BonisOleg/adiabatic/static/images/сайт/0-02-05-3eb4adaa0fc649120910b41186bc80454fc107874810b4671cba74e420dbb2bf_a26d8dc03b7513a2.jpg

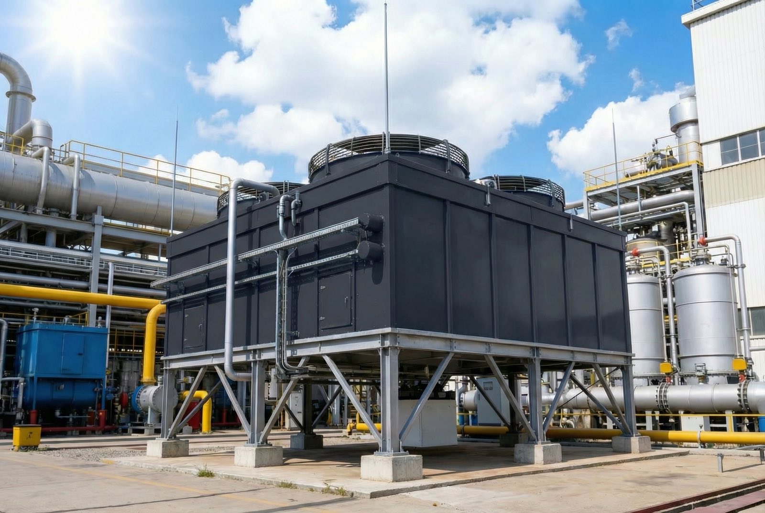
static/images/сайт/0-02-05-3eb4adaa0fc649120910b41186bc80454fc107874810b4671cba74e420dbb2bf_a26d8dc03b7513a2.jpg
