BonisOleg/adiabatic/static/images/сайт/photo_2025-12-09_13-31-13.jpg

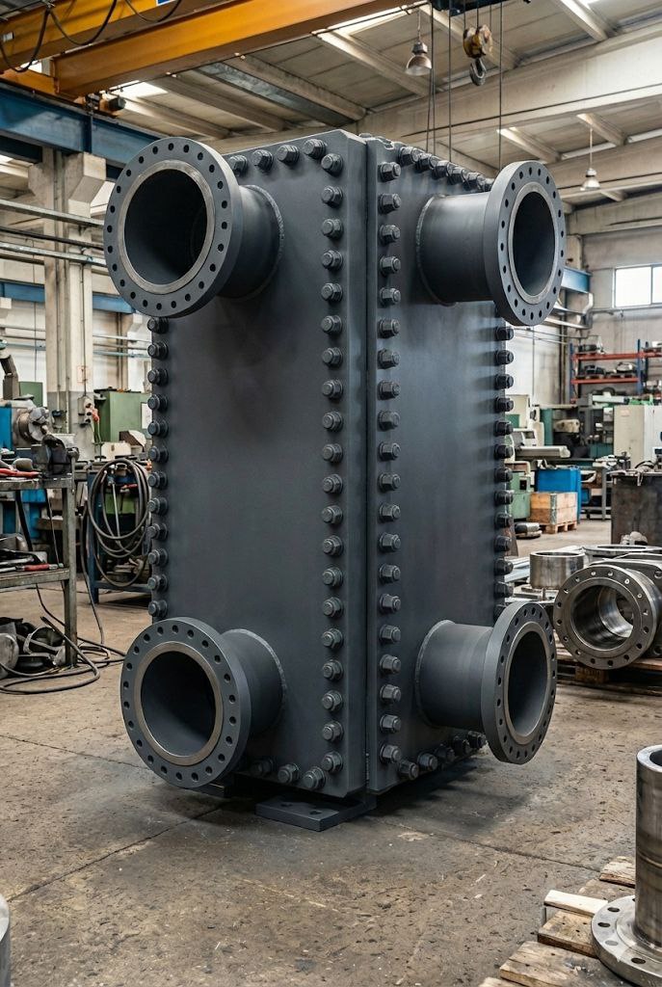
static/images/сайт/photo_2025-12-09_13-31-13.jpg
