BonisOleg/adiabatic/ОПТИМІЗАЦІЯ_ПЛАН.md

# 🚀 ПЛАН ОПТИМІЗАЦІЇ ADIABATIC ПРОЄКТУ

## 📊 ПОТОЧНА СИТУАЦІЯ

### Аналіз проєкту:
- **Загальний CSS**: 1 файл `main.css` (1992 рядки) - ВСІ стилі разом
- **Загальний JS**: 1 файл `main.js` (1030+ рядків) - ВСІ скрипти разом
- **Inline CSS**: 237 рядків у `base.html` (критичні стилі)
- **Inline JS**: Analytics та Service Worker у `base.html`
- **Зайвий код**: Неактивні додатки (payment, documents, analytics)

### Активні сторінки (14 штук):
1. **pages** (7): home, about, contacts, products, partners, blog, page_detail
2. **catalog** (4): catalog_list, category_detail, product_detail, qr_document
3. **leads** (3): lead_form, thank_you, thank_you_detail

## 🎯 ЦІЛІ ОПТИМІЗАЦІЇ

1. **Розділити CSS і JS по сторінках** - 1 файл на сторінку
2. **Видалити ВЕСЬ зайвий код** неактивних додатків
3. **Зберегти 100% функціональність** сайту
4. **Прискорити завантаження** за рахунок меншого розміру файлів
5. **Покращити кешування** браузером

## 📋 ДЕТАЛЬНИЙ ПЛАН ВИКОНАННЯ

### ЕТАП 1: ОЧИЩЕННЯ ЗАЙВОГО CSS/JS КОДУ

⚠️ **ВАЖЛИВО**: Додатки payment/, documents/, analytics/ **ЗАЛИШАЄМО** - вони потрібні для майбутнього!

#### 1.1 Очистити зайві стилі з main.css
- [ ] Видалити стилі для неактивних payment форм (якщо є)
- [ ] Видалити стилі для неактивних analytics dashboard (якщо є)
- [ ] Видалити стилі для неактивних document viewers (якщо є)
- [ ] Залишити базові стилі, які можуть знадобитися

#### 1.2 Очистити зайвий JavaScript з main.js
- [ ] Видалити неактивний JS для payment processing
- [ ] Видалити неактивний JS для analytics dashboard
- [ ] Видалити неактивний JS для document management
- [ ] Залишити базовий функціонал

#### 1.3 Оптимізувати без видалення додатків
- [ ] Перевірити які CSS/JS класи НЕ використовуються в шаблонах
- [ ] Видалити тільки неактивний код, не структуру додатків

### ЕТАП 2: СТРУКТУРА CSS ФАЙЛІВ

#### 2.1 Базові файли (спільні)
```
static/css/
├── base.css           # Критичні стилі з base.html
├── components.css     # Кнопки, форми, карти (спільні компоненти)
├── layout.css         # Header, footer, navigation, grid
└── variables.css      # CSS змінні, кольори, шрифти
```

#### 2.2 CSS файли по сторінках
```
static/css/pages/
├── home.css           # Hero з відео, продукти, партнери
├── about.css          # Про компанію, команда
├── contacts.css       # Контактна форма, карта
├── products.css       # Сфери застосування, галузі
├── partners.css       # Список партнерів
├── blog.css           # Блог, статті
└── page_detail.css    # Динамічні сторінки

static/css/catalog/
├── catalog_list.css   # Список каталогу, фільтри
├── category_detail.css # Сторінка категорії
├── product_detail.css  # Детальна сторінка продукту, 3D gallery
└── qr_document.css    # QR документи

static/css/leads/
├── lead_form.css      # Форма заявки
├── thank_you.css      # Сторінка подяки
└── thank_you_detail.css # Детальна подяка
```

### ЕТАП 3: СТРУКТУРА JS ФАЙЛІВ

#### 3.1 Базові файли (спільні)
```
static/js/
├── base.js            # Мобільне меню, smooth scroll, iOS фікси
├── components.js      # Форми, модалки, утиліти
└── analytics.js       # GA4, відстеження (винести з base.html)
```

#### 3.2 JS файли по сторінках
```
static/js/pages/
├── home.js            # Відео ротація, анімації hero
├── contacts.js        # Карта, валідація контактної форми
└── [інші сторінки мають мінімум JS]

static/js/catalog/
├── catalog_list.js    # Фільтри каталогу, пошук
├── product_detail.js  # 3D Gallery, Image Modal, техспеки
└── gallery.js         # 3D переглядач (окремо для переіспользування)

static/js/leads/
├── lead_form.js       # Валідація форм, AJAX відправка
└── form_validation.js # Спільна валідація для всіх форм
```

### ЕТАП 4: ОПТИМІЗАЦІЯ ПІДКЛЮЧЕННЯ

#### 4.1 Оновити base.html
```html
<!-- Критичні стилі inline (тільки найнеобхідніше) -->
<style>
  /* Тільки reset, основні змінні, header, footer */
</style>

<!-- Базові CSS файли (асинхронно) -->
<link rel="preload" href="/static/css/variables.css" as="style" onload="this.onload=null;this.rel='stylesheet'">
<link rel="preload" href="/static/css/layout.css" as="style" onload="this.onload=null;this.rel='stylesheet'">
<link rel="preload" href="/static/css/components.css" as="style" onload="this.onload=null;this.rel='stylesheet'">

<!-- Базовий JS -->
<script src="/static/js/base.js" defer></script>
```

#### 4.2 Блоки для сторінок
```html
{% block page_css %}{% endblock %}
{% block page_js %}{% endblock %}
```

#### 4.3 Приклад підключення для home.html
```html
{% block page_css %}
<link rel="stylesheet" href="/static/css/pages/home.css">
{% endblock %}

{% block page_js %}
<script src="/static/js/pages/home.js" defer></script>
{% endblock %}
```

### ЕТАП 5: РОЗПОДІЛ ФУНКЦІОНАЛУ

#### 5.1 Спільний функціонал (base.js)
- Мобільне меню (mobile menu toggle)
- Desktop анімоване меню
- Smooth scrolling
- iOS Safari фікси
- Back to top кнопка
- Service Worker реєстрація

#### 5.2 Компоненти (components.js)
- Валідація форм (базова)
- Модальні вікна (базові)
- Утиліти (debounce, відстеження помилок)
- Intersection Observer для анімацій

#### 5.3 Специфічний функціонал по сторінках
- **home.js**: Відео ротація, анімації hero секції
- **product_detail.js**: 3D Gallery, Image Modal, техспеки
- **lead_form.js**: AJAX форми, специфічна валідація
- **catalog_list.js**: Фільтри, пошук по каталогу

### ЕТАП 6: ОПТИМІЗАЦІЯ CSS

#### 6.1 Розподіл стилів з main.css

**variables.css** (CSS змінні):
```css
:root {
  --primary: #1B365D;
  --secondary: #C4384D;
  /* всі CSS змінні */
}
```

**layout.css** (структура):
- Header, footer
- Navigation (desktop + mobile)
- Container, section classes
- Grid systems

**components.css** (компоненти):
- Кнопки (.btn, .btn--primary, etc.)
- Картки (.card, .equipment-card)
- Форми (.form, .form-group)
- Модальні вікна

**home.css** (тільки для головної):
- Hero стилі
- Video rotation
- Products grid
- Applications section
- Downloads section

**product_detail.css** (тільки для продукту):
- 3D Gallery стилі
- Tech specs таблиці
- Advantages grid
- CTA section

### ЕТАП 7: ТЕСТУВАННЯ

#### 7.1 Функціональне тестування
- [ ] Мобільне меню працює
- [ ] Desktop анімоване меню працює
- [ ] Відео ротація на головній
- [ ] 3D Gallery на сторінці продукту
- [ ] Форми відправляються
- [ ] Всі анімації працюють
- [ ] iOS Safari оптимізації

#### 7.2 Performance тестування
- [ ] Швидкість завантаження сторінок
- [ ] Розмір CSS/JS файлів
- [ ] Кешування працює
- [ ] Lazy loading зображень

## 📊 ОЧІКУВАНІ РЕЗУЛЬТАТИ

### До оптимізації:
- **main.css**: 1992 рядки (~150KB)
- **main.js**: 1030+ рядків (~80KB)
- **Завантаження**: ВСІ стилі і скрипти на кожній сторінці

### Після оптимізації:
- **base.css**: ~300 рядків (~20KB)
- **page-specific CSS**: 100-400 рядків (~5-20KB)
- **base.js**: ~200 рядків (~15KB)
- **page-specific JS**: 50-300 рядків (~3-15KB)
- **Завантаження**: Тільки потрібні файли для конкретної сторінки

### Прискорення:
- **Головна сторінка**: ~70% менше CSS/JS
- **Сторінка продукту**: ~50% менше CSS/JS (бо 3D функціонал)
- **Форма заявки**: ~80% менше CSS/JS
- **Загальне прискорення**: 2-3x швидше

## 🔧 ТЕХНІЧНІ ДЕТАЛІ

### CSS організація:
```css
/* components.css - приклад кнопок */
.btn {
  /* базові стилі кнопок */
}

.btn--primary { /* основна кнопка */ }
.btn--secondary { /* вторинна кнопка */ }
.btn--3d { /* тільки для продуктів */ }
```

### JS модульність:
```javascript
// base.js
function initMobileMenu() { /* спільний код */ }
function initSmoothScrolling() { /* спільний код */ }

// home.js
function initVideoRotation() { /* тільки для головної */ }

// product_detail.js  
class Gallery3D { /* тільки для продуктів */ }
```

### Підключення за потребою:
- **home.html**: base.css + home.css + base.js + home.js
- **product_detail.html**: base.css + product_detail.css + base.js + gallery.js + product_detail.js
- **lead_form.html**: base.css + form.css + base.js + form_validation.js

## ✅ ЧЕКЛІСТ ВИКОНАННЯ

### Підготовка:
- [ ] Backup поточного коду
- [ ] Тестове середовище готове

### Очищення зайвого коду:
- [ ] Проаналізувати які CSS класи не використовуються
- [ ] Проаналізувати який JS код не використовується  
- [ ] Видалити неактивні стилі з main.css
- [ ] Видалити неактивний JavaScript з main.js
- [ ] ✅ ЗАЛИШИТИ всі додатки (payment/, documents/, analytics/)

### Розділення CSS:
- [ ] Створити структуру папок
- [ ] Розділити main.css на компоненти
- [ ] Створити CSS для кожної сторінки
- [ ] Перевірити всі стилі працюють

### Розділення JS:
- [ ] Створити структуру папок
- [ ] Розділити main.js на модулі
- [ ] Створити JS для кожної сторінки
- [ ] Перевірити весь функціонал працює

### Оновлення шаблонів:
- [ ] Оновити base.html
- [ ] Додати блоки page_css і page_js
- [ ] Оновити всі 14 шаблонів
- [ ] Перевірити підключення файлів

### Тестування:
- [ ] Всі сторінки відкриваються
- [ ] Всі функції працюють
- [ ] Мобільна версія працює
- [ ] iOS Safari працює
- [ ] Performance покращений

### Фінальні кроки:
- [ ] Видалити старі файли main.css, main.js
- [ ] Оновити .gitignore якщо потрібно
- [ ] Документувати зміни
- [ ] Deploy на продакшен

## 🚀 РЕЗУЛЬТАТ

Після виконання плану:
- ✅ **Сайт стане швидшим** (2-3x)
- ✅ **Код стане чистішим** (без зайвого)
- ✅ **Підтримка стане легшою** (модульність)
- ✅ **Кешування покращиться** (менші файли)
- ✅ **100% функціональність збережена**

**Головне правило**: НІЧОГО НЕ ЗЛАМАТИ! 🛡️
