BonisOleg/adiabatic/static/images/tovar6.png

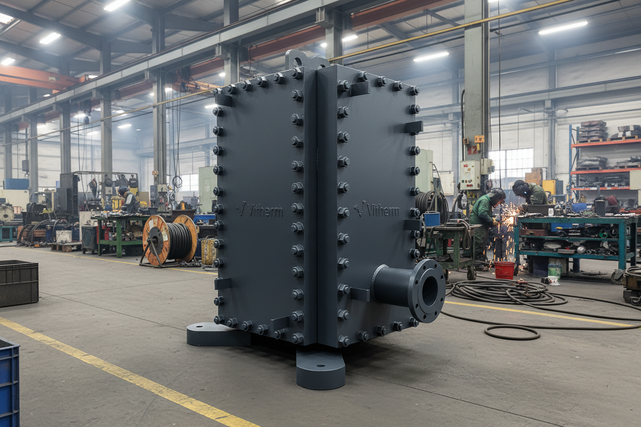
static/images/tovar6.png
