BonisOleg/adiabatic/static/images/сайт/0-02-05-1a9fca4899ccf471a3d658756550e7a283c3ff7af5b11dbfbce31b4d3bbf0c0a_f5ad5dce52cb923e.jpg

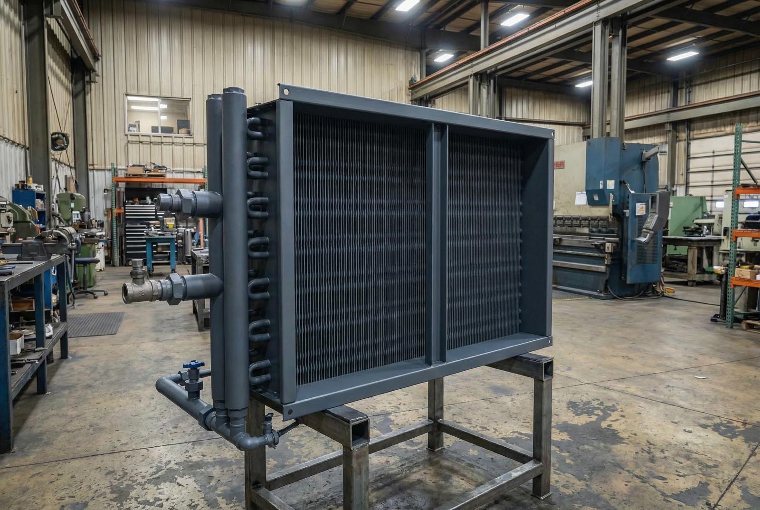
static/images/сайт/0-02-05-1a9fca4899ccf471a3d658756550e7a283c3ff7af5b11dbfbce31b4d3bbf0c0a_f5ad5dce52cb923e.jpg
