BonisOleg/adiabatic/static/images/сайт/0-02-05-5e768033f6e527f5cd78bf170995c12d8afdc9c7c348f54152d39fb6d8a779e8_63474c44207616c6.jpg

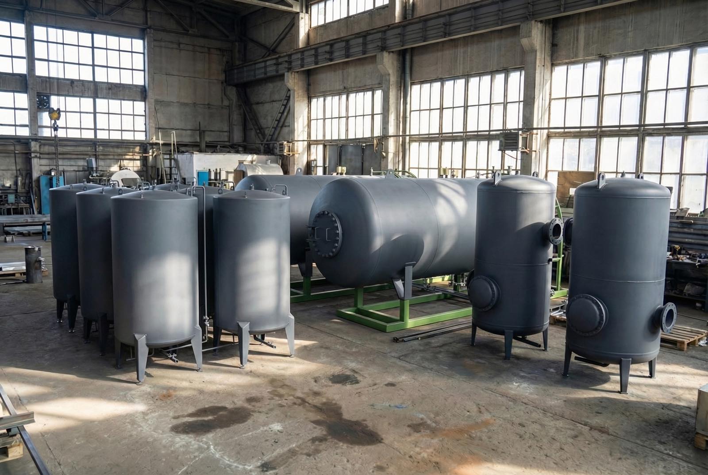
static/images/сайт/0-02-05-5e768033f6e527f5cd78bf170995c12d8afdc9c7c348f54152d39fb6d8a779e8_63474c44207616c6.jpg
