BonisOleg/adiabatic/static/images/сайт/0-02-05-919ba7b33e21d02bffa0fa3d58ddc5d80f63605416315276e9dd6206414cf1c3_1c1d455c35bce096.jpg

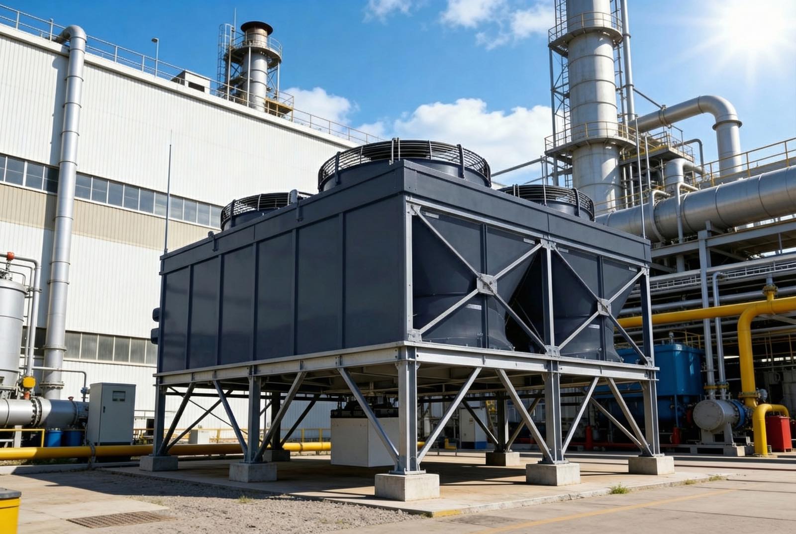
static/images/сайт/0-02-05-919ba7b33e21d02bffa0fa3d58ddc5d80f63605416315276e9dd6206414cf1c3_1c1d455c35bce096.jpg
