BonisOleg/adiabatic/static/images/сайт/0-02-05-992b67395d587ad29af840b961c614702c5de4444f6ba71ae19c8a748ea154f4_6bf83c84c83d3f53.jpg

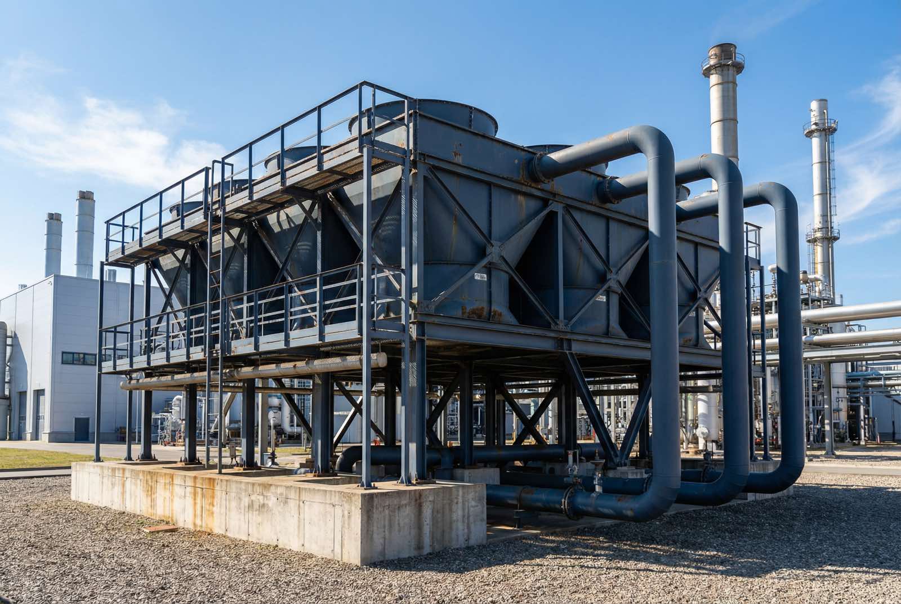
static/images/сайт/0-02-05-992b67395d587ad29af840b961c614702c5de4444f6ba71ae19c8a748ea154f4_6bf83c84c83d3f53.jpg
