BonisOleg/adiabatic/static/images/сайт/0-02-05-746751beb6804ef7eb7b141f460269889f6d4e62b52f62eda0f67aa950a41e95_8c5e32d4b4429a24.jpg

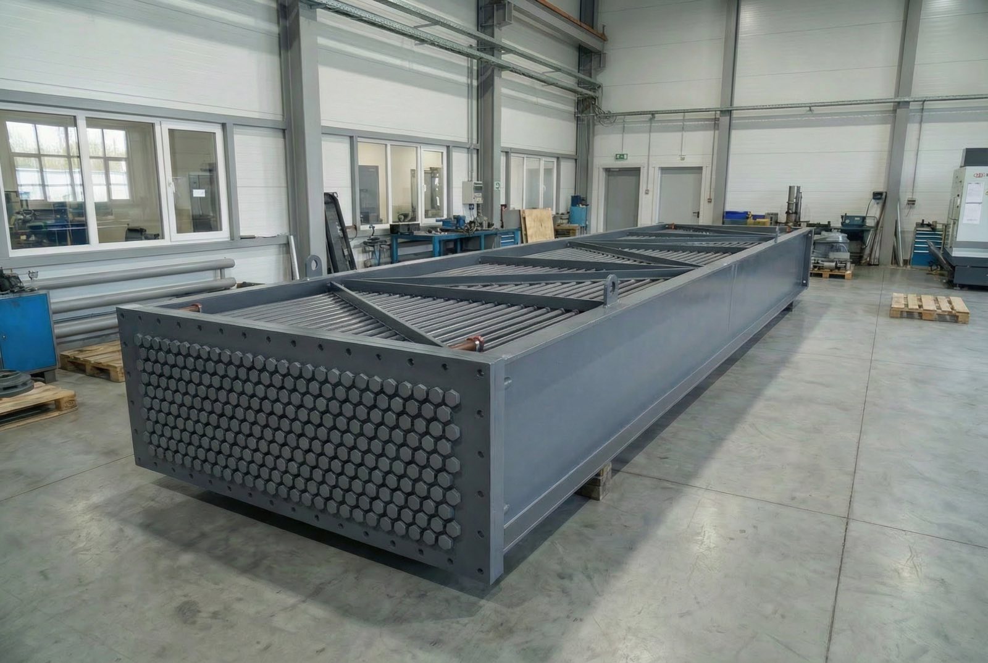
static/images/сайт/0-02-05-746751beb6804ef7eb7b141f460269889f6d4e62b52f62eda0f67aa950a41e95_8c5e32d4b4429a24.jpg
