BonisOleg/adiabatic/static/images/сайт/2314214317_50_37.png

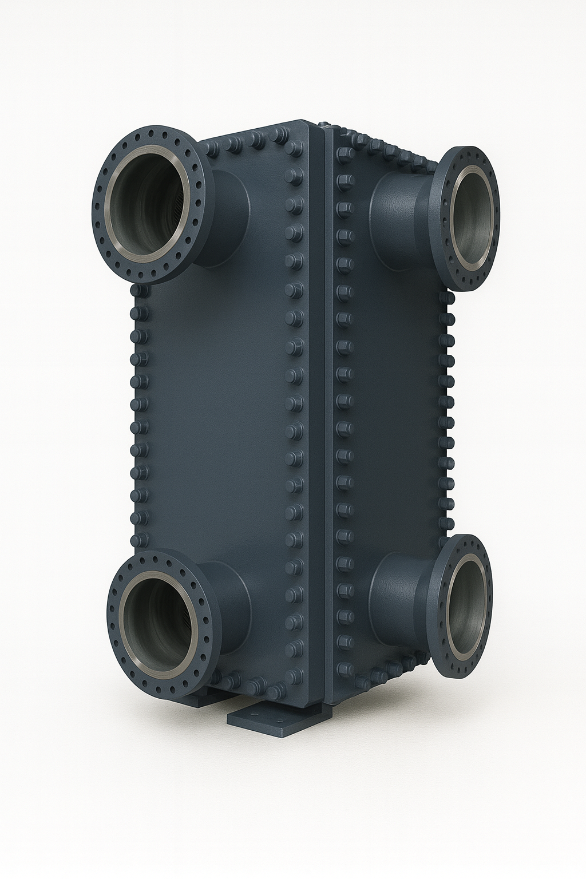
static/images/сайт/2314214317_50_37.png
