BonisOleg/adiabatic/static/images/3D/Нестандарт/8/COMPLETE RADIATOR.SLDASM

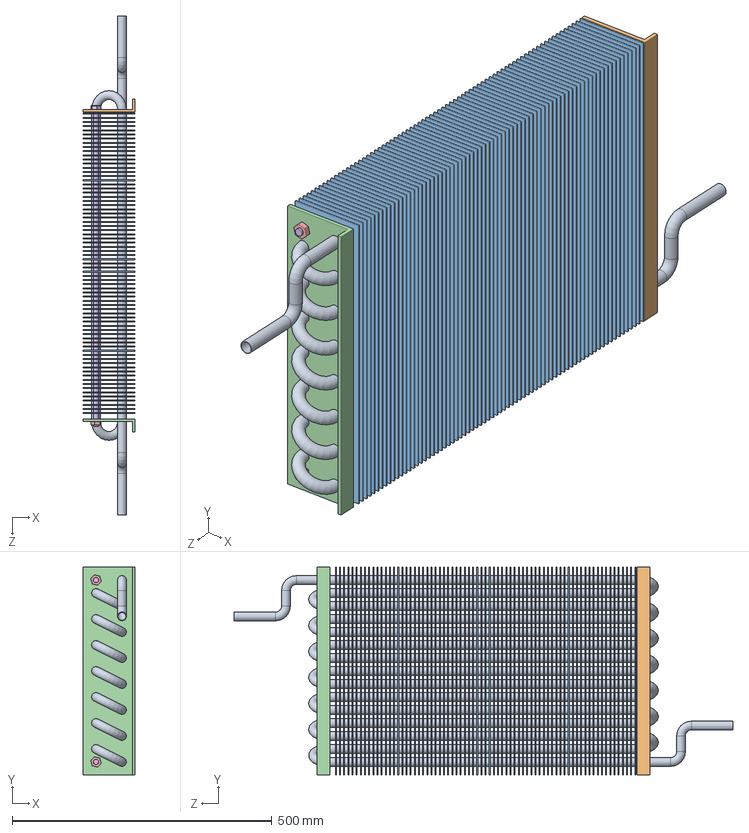
[picture p10: CAD file, 2025-09-01, last stored version]
static/images/3D/Нестандарт/8/COMPLETE RADIATOR.SLDASM
100.0 x 400.0 x 960.0 mm
pipes
side plate 2
fin x 73
side plate 1
nut x 2
strainer x 2
