BonisOleg/adiabatic/static/images/3D/Трубчатые/14/BONNET/ASME B16.5 Flange Welding Neck - Class 600 4.SLDPRT

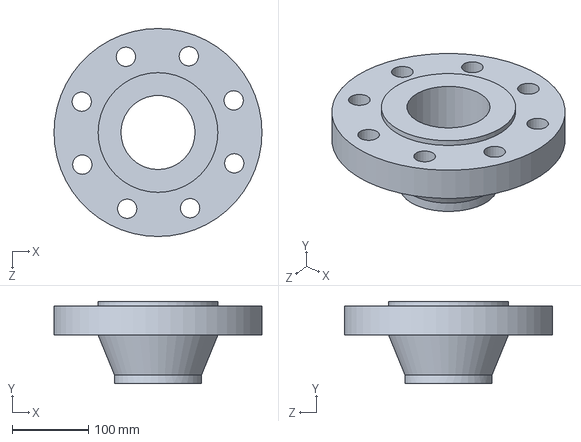
[picture p11: CAD file, 2025-09-01, last stored version]
static/images/3D/Трубчатые/14/BONNET/ASME B16.5 Flange Welding Neck - Class 600 4.SLDPRT
273.1 x 108.0 x 273.1 mm
