BonisOleg/adiabatic/static/images/3D/Трубчатые/14/SUPPORT SADDLE FIX AND MOBILE DIAM 508/SUPPORT SADDLE FIX AND MOBILE DIAM 508(2).SLDASM

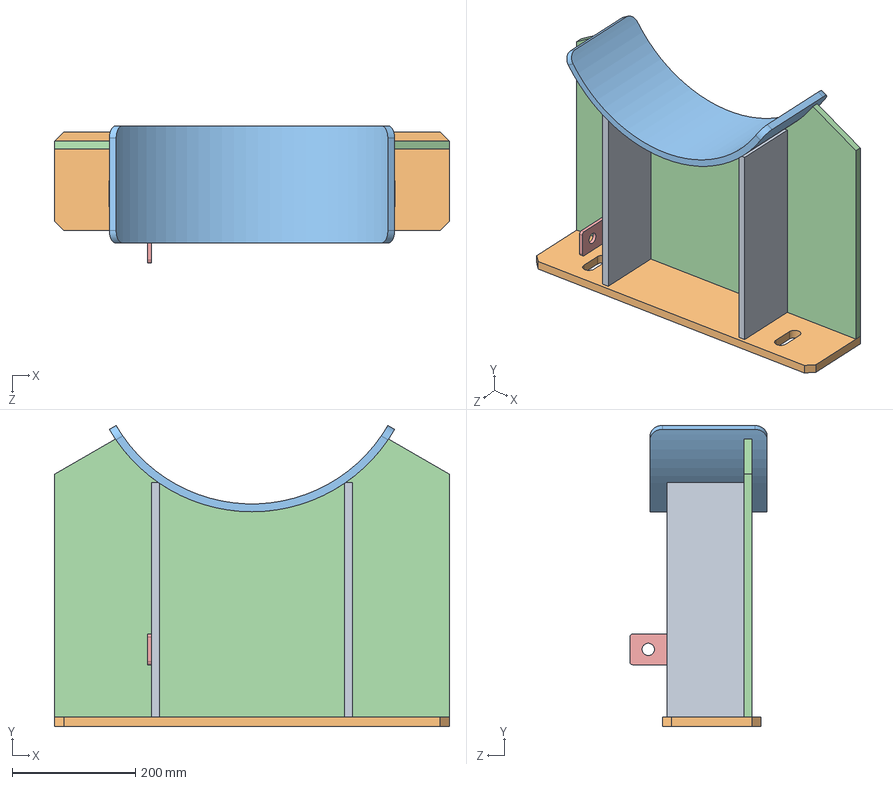
[picture p12: CAD file, 2025-09-01, last stored version]
static/images/3D/Трубчатые/14/SUPPORT SADDLE FIX AND MOBILE DIAM 508/SUPPORT SADDLE FIX AND MOBILE DIAM 508(2).SLDASM
640.0 x 487.8 x 222.7 mm
PLATE 125 X 380 X 12,7 x 2
PLATE 160 X 640 X 15,8
PLATE 190 X 544 X 12,7
PLATE 450 X 640 X 12,7
HEARTHING CONNECTOR
