BonisOleg/adiabatic/static/images/3D/Паяные/1/Assem1.SLDASM

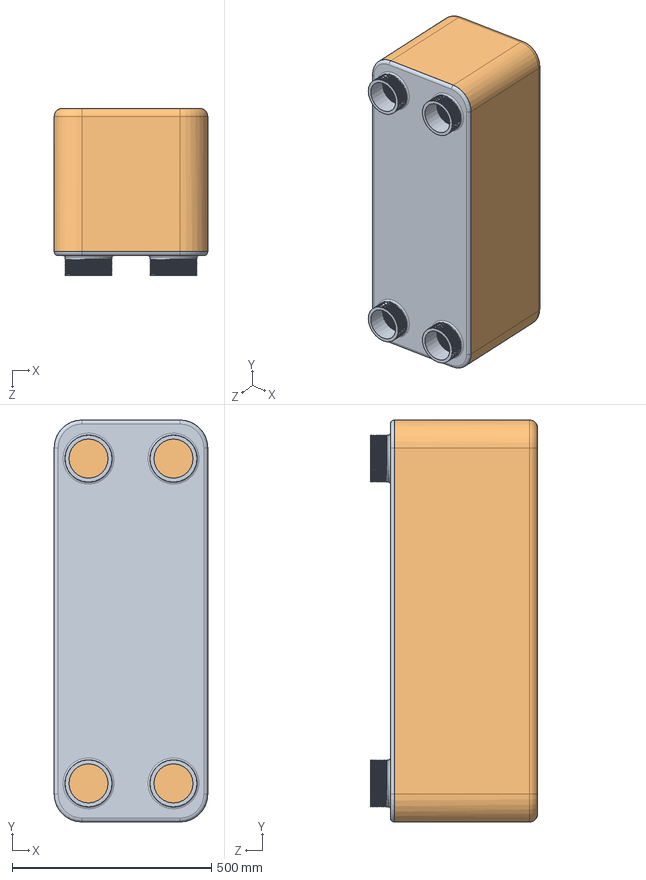
[picture p13: CAD file, 2025-09-01, last stored version]
static/images/3D/Паяные/1/Assem1.SLDASM
386.0 x 1010.0 x 420.0 mm
cover 2
cover 1
plate Bb x 66
plate A x 66
