BonisOleg/adiabatic/static/images/3D/Трубчатые/11/HEAT EXCHANGER TIPE U 1.SLDASM

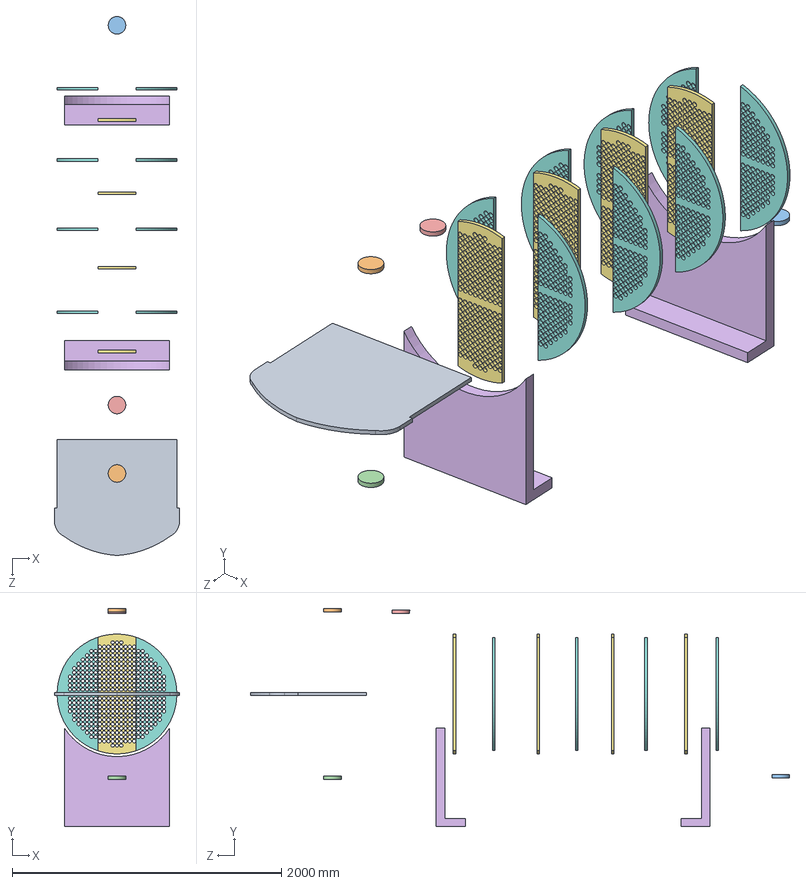
[picture p14: CAD file, 2025-09-01, last stored version]
static/images/3D/Трубчатые/11/HEAT EXCHANGER TIPE U 1.SLDASM
928.5 x 1619.2 x 4001.7 mm
FIRMAN NUR SAPUTRA_22419477_PLAT ROD
LID10
LID11
LID12
LID13
FIRMAN NUR SAPUTRA_22419477_PENYANGGA HEAT EXCHNAGER x 2
double baffle p1 x 4
double baffle t x 4
