BonisOleg/adiabatic/static/images/3D/Трубчатые/11/DOUBLE BAFFLE.SLDASM

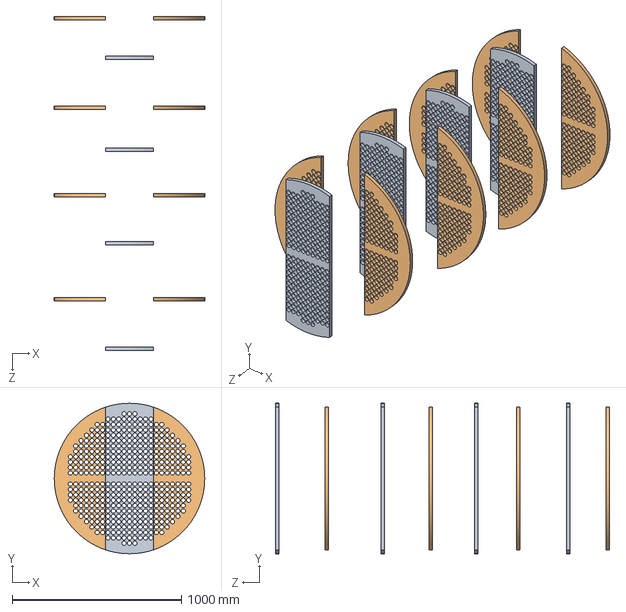
[picture p15: CAD file, 2025-09-01, last stored version]
static/images/3D/Трубчатые/11/DOUBLE BAFFLE.SLDASM
889.0 x 889.0 x 1972.2 mm
double baffle p1 x 4
double baffle t x 4
