BonisOleg/adiabatic/static/images/3D/Трубчатые/14/SHELL/SHELL.SLDASM

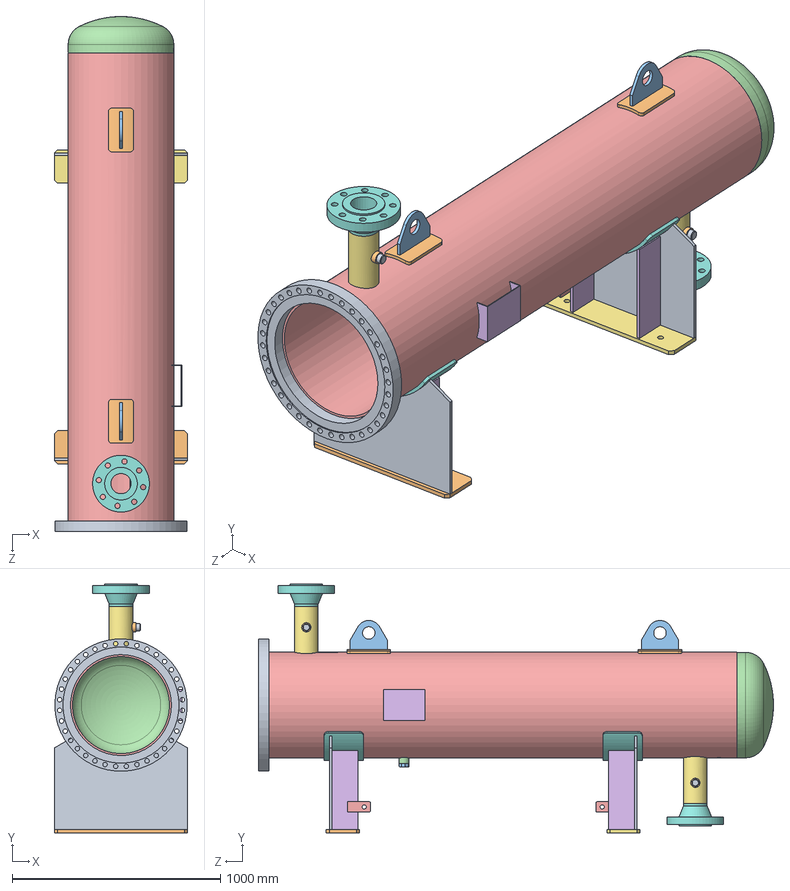
[picture p16: CAD file, 2025-09-01, last stored version]
static/images/3D/Трубчатые/14/SHELL/SHELL.SLDASM
640.0 x 1196.4 x 2475.7 mm
FLANGE DIAM 636 X 51
LIFITING LUG PLATE x 2
LIFTING LUG x 2
SHELL COVER DIAM 508 X 177
SHELL TUBE DIAM 20 Pol SCH60 x 2250
PLATE IDENTIFICATION SUPPORT
ASME B36.10M PIPE 4 POL SCH 80 X 246 x 2
ASME B16.5 Flange Welding Neck - Class 600 4 x 2
ASME B16.11 Round Head Plug 1 x 2
BONNET LIFTING LUG x 2
ASME B16.11 Coupling Threaded Class 3000 1 x 1
ASME B16.11 Coupling Threaded - Class 3000 1 x 1
HEARTHING CONNECTOR x 2
PLATE 125 X 380 X 12,7 x 4
PLATE 160 X 640 X 15,8(2)
PLATE 190 X 544 X 12,7 x 2
PLATE 450 X 640 X 12,7 x 2
PLATE 160 X 640 X 15,8
