BonisOleg/adiabatic/static/images/3D/Трубчатые/5/Assembly.SLDASM

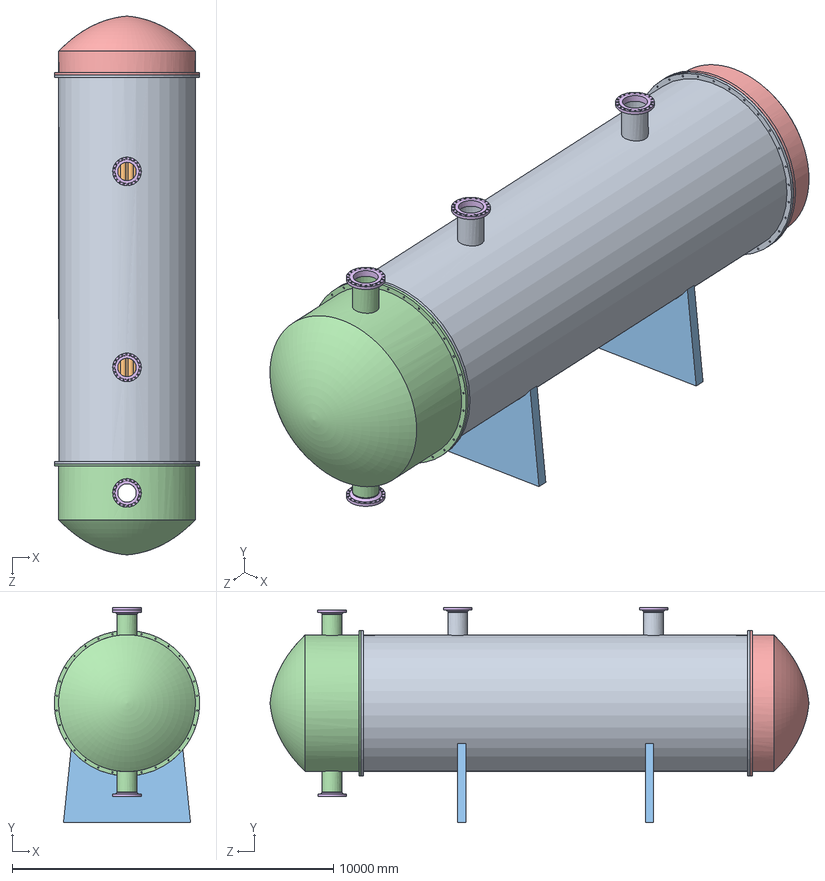
[picture p17: CAD file, 2025-09-01, last stored version]
static/images/3D/Трубчатые/5/Assembly.SLDASM
4524.0 x 6693.0 x 16774.8 mm
berk_gövdekesik
berk_ayna
berk_taşıyıcı x 2
berk_bombekesik
berk_bombe
FLANGE x 4
