BonisOleg/adiabatic/static/images/3D/Трубчатые/14/BONNET/ASME B36.10M PIPE 4 POL SCH 80 X 246.SLDPRT

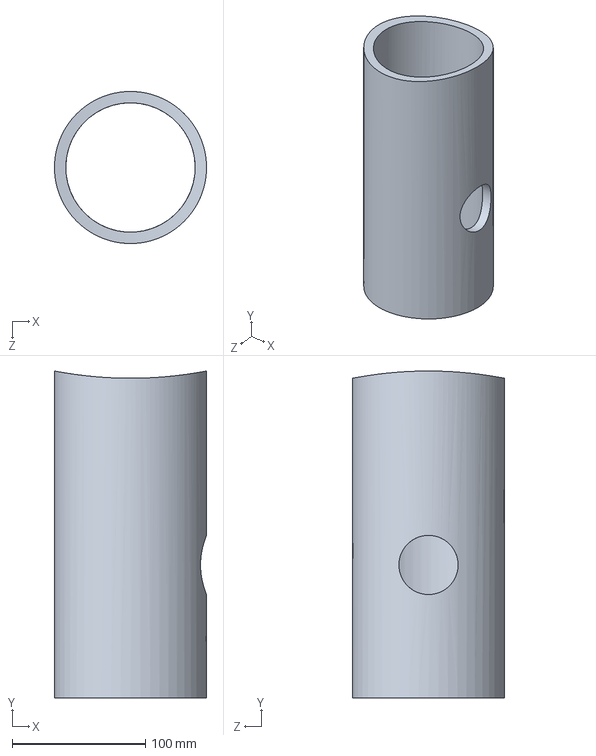
[picture p18: CAD file, 2025-09-01, last stored version]
static/images/3D/Трубчатые/14/BONNET/ASME B36.10M PIPE 4 POL SCH 80 X 246.SLDPRT
114.3 x 245.8 x 114.3 mm
