BonisOleg/adiabatic/static/images/3D/Трубчатые/14/BONNET/BONNET.SLDASM

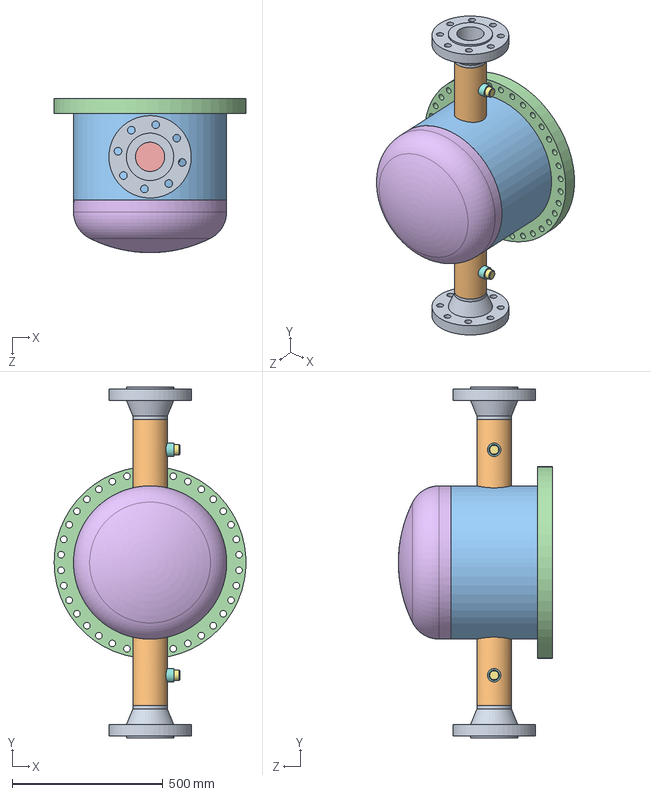
[picture p19: CAD file, 2025-09-01, last stored version]
static/images/3D/Трубчатые/14/BONNET/BONNET.SLDASM
635.4 x 1163.3 x 511.7 mm
ASME B16.5 Flange Welding Neck - Class 600 4 x 2
ASME B36.10M PIPE 4 POL SCH 80 X 246 x 2
BONNET CYLINDER Ø20 SCH 60 x 286
FLANGE DIAM 636 X 51
PASS PARTITION
SHELL COVER DIAM 508 X 177
ASME B16.11 Round Head Plug 1 x 2
BONNET LIFTING LUG x 2
