BonisOleg/adiabatic/static/images/3D/Трубчатые/14/SHELL/ASME B16.11 Round Head Plug 1.SLDPRT

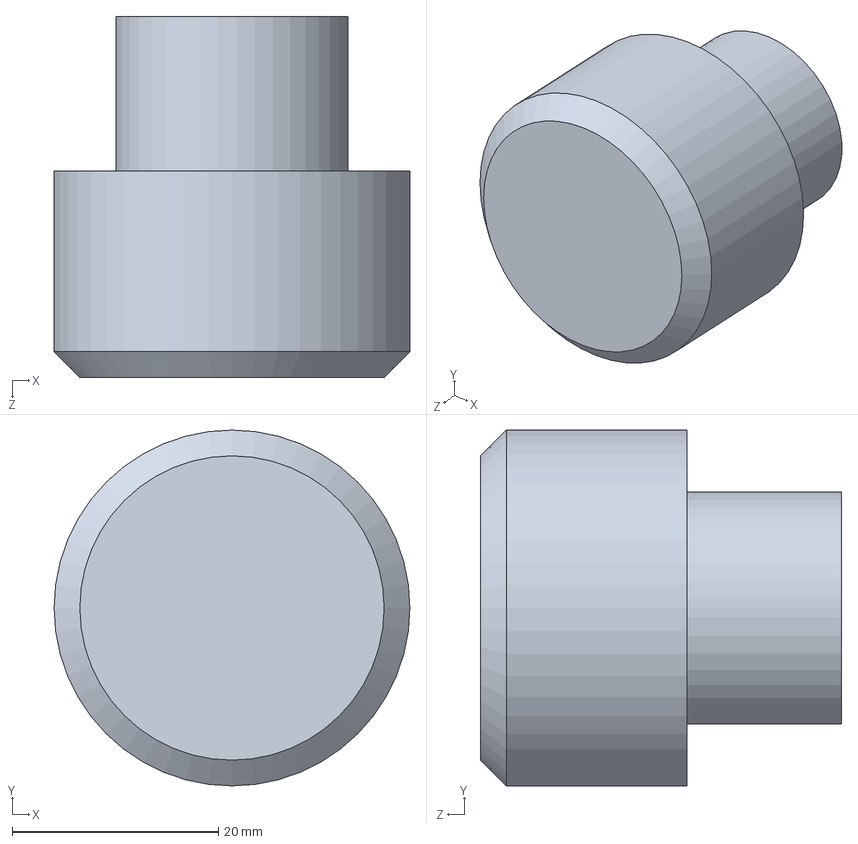
[picture p20: CAD file, 2025-09-01, last stored version]
static/images/3D/Трубчатые/14/SHELL/ASME B16.11 Round Head Plug 1.SLDPRT
34.5 x 34.5 x 35.0 mm
