BonisOleg/adiabatic/static/images/3D/Трубчатые/14/STATIONARY TUBESHEET/Assem1.SLDASM

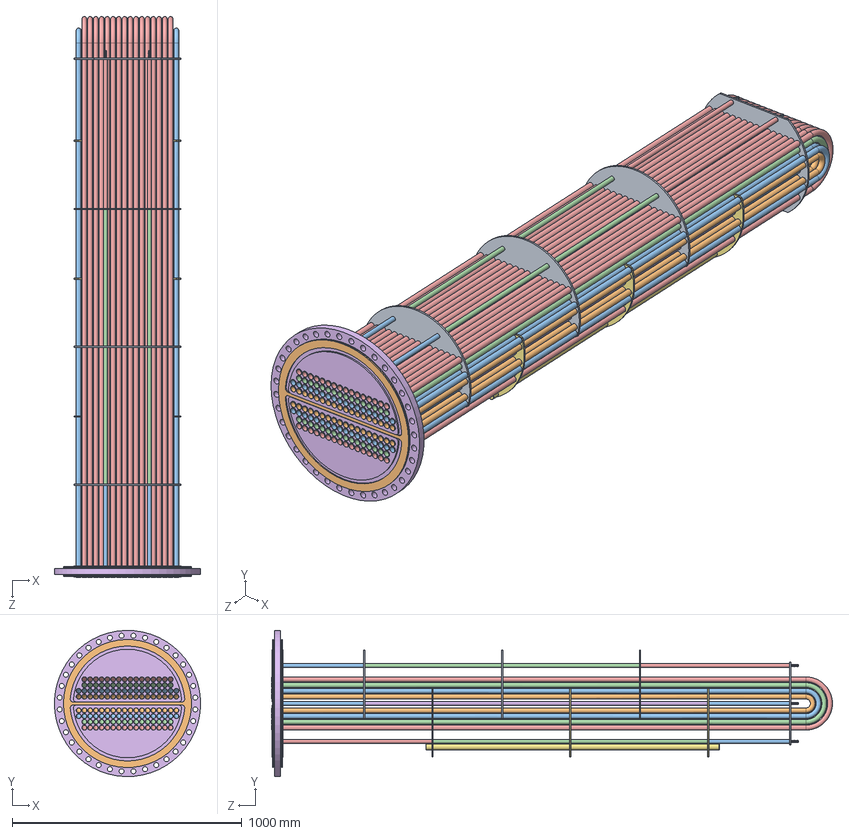
[picture p21: CAD file, 2025-09-01, last stored version]
static/images/3D/Трубчатые/14/STATIONARY TUBESHEET/Assem1.SLDASM
636.0 x 635.7 x 2440.6 mm
BAFFLE
BONNET GASKET
SPACER TUBE DIAM. 3l8 SCH 80 x 350 x 8
SPACER TUBE DIAM. 3l8 SCH 80 x 600 x 8
SPACER TUBE DIAM. 3l8 SCH 80 x 653 x 4
SPACER TUBE DIAM. 3l8 SCH 80 x 297 x 10
TIE ROD DIAM 25 X 1276 x 2
TIE ROD THREAD 3 8 X 2280 x 6
TRANSVERSE BAFFLE SUPERIOR x 3
TUBE DIAM 0.5 SCH 80 X 4766 x 18
TUBE DIAM. 0.5 SCH 80 X 4844 x 18
TUBE DIAM. 0.5 SCH 80 X 4923 x 16
TUBE DIAM. 0.5 SCH 80 X 5000 x 16
TUBESHEET
TRANSVERSE BAFFLE INFERIOR x 3
SHELL GASKET
