BonisOleg/adiabatic/static/images/3D/Трубчатые/14/SHELL/ASME B16.11 Coupling Threaded  Class 3000 1 x 1.SLDPRT

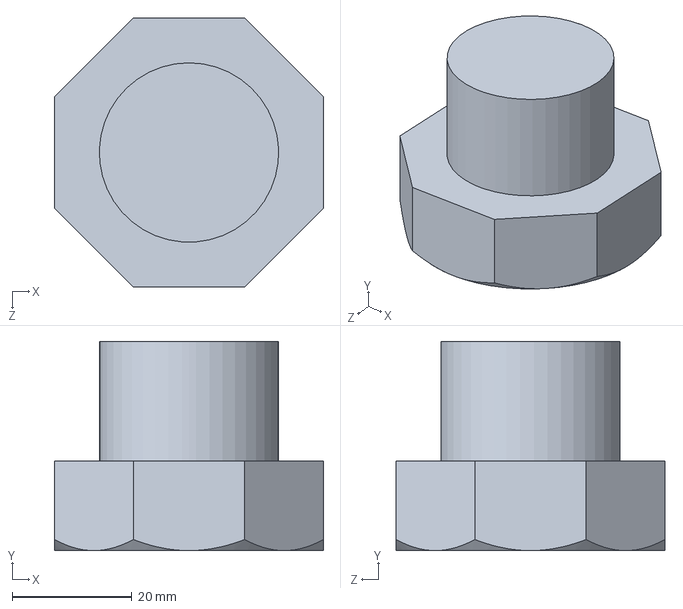
[picture p22: CAD file, 2025-09-01, last stored version]
static/images/3D/Трубчатые/14/SHELL/ASME B16.11 Coupling Threaded Class 3000 1 x 1.SLDPRT
45.0 x 35.0 x 45.0 mm
