BonisOleg/adiabatic/static/images/3D/Нестандарт/4/finned tube he/finned tube he assy.SLDASM

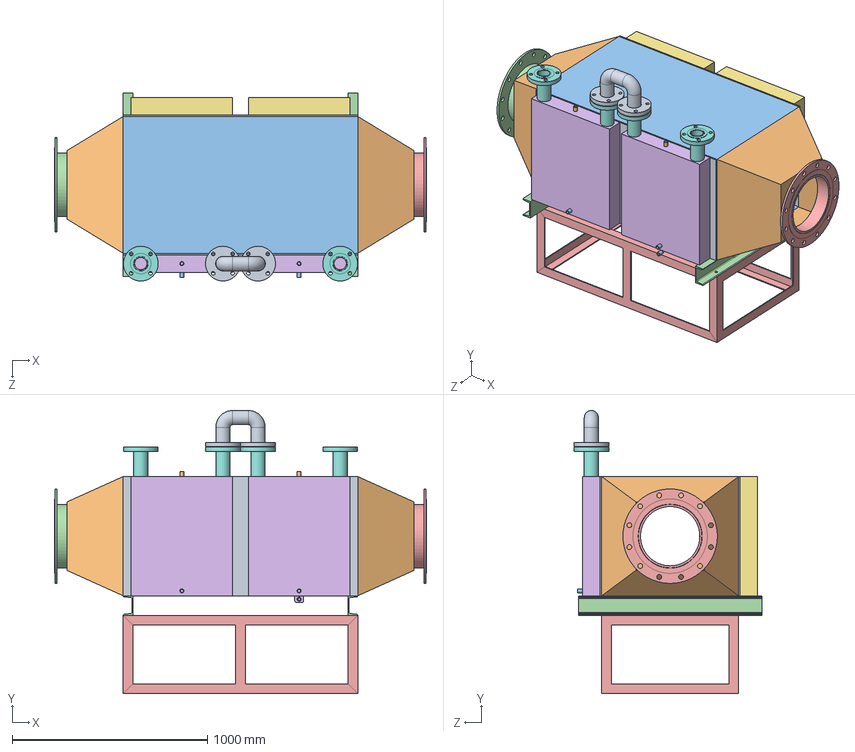
[picture p23: CAD file, 2025-09-01, last stored version]
static/images/3D/Нестандарт/4/finned tube he/finned tube he assy.SLDASM
1903.0 x 1448.0 x 962.0 mm
tube holding plate x 2
air shell x 2
air inlet flange
air outlet flange
rh waterbox x 2
lh water box x 2
65 nb class 150 x 4
loop flange
air vent 15bsp x 2
drain 15bsp x 2
50x100 channel
50x50 angle
condensate outlet
