BonisOleg/adiabatic/static/images/3D/Трубчатые/3/Main Rod End .5in thrd.SLDPRT

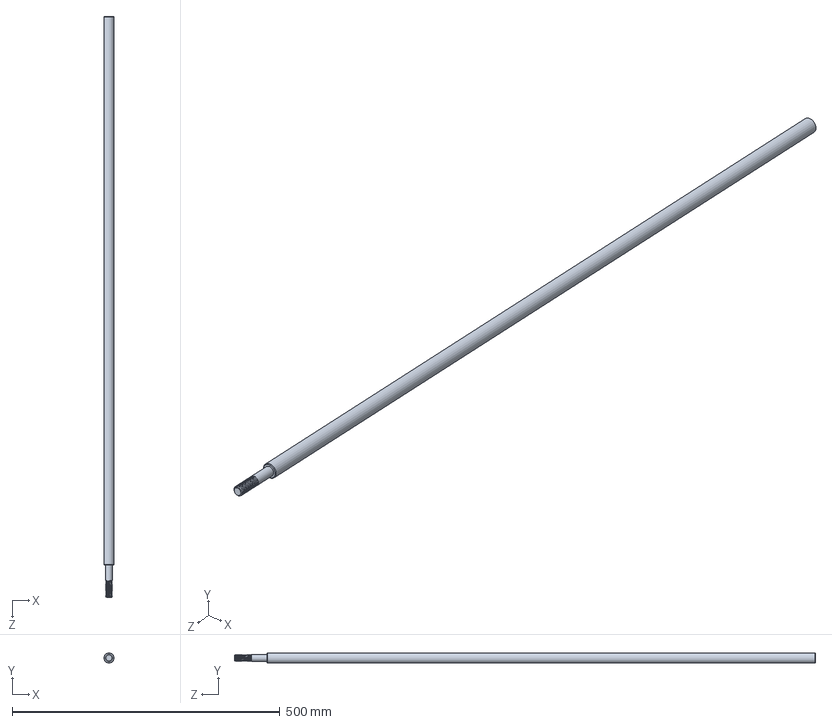
[picture p24: CAD file, 2025-09-01, last stored version]
static/images/3D/Трубчатые/3/Main Rod End .5in thrd.SLDPRT
19.1 x 19.1 x 1085.8 mm
