BonisOleg/adiabatic/static/images/3D/Трубчатые/3/Rod Plate Assembly.SLDASM

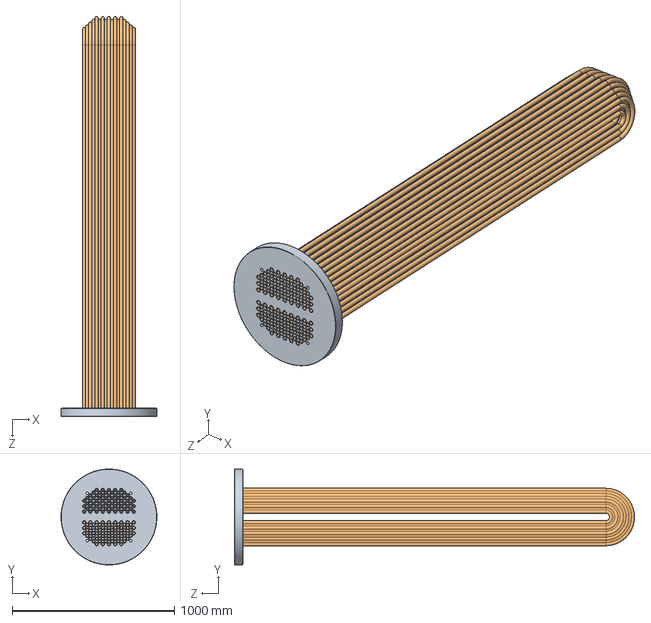
[picture p25: CAD file, 2025-09-01, last stored version]
static/images/3D/Трубчатые/3/Rod Plate Assembly.SLDASM
590.3 x 590.4 x 2462.6 mm
Plate Rod
