BonisOleg/adiabatic/static/images/3D/Трубчатые/15/Permutador e andaimes G.C/Montagem permutador inferiorg.c..SLDASM

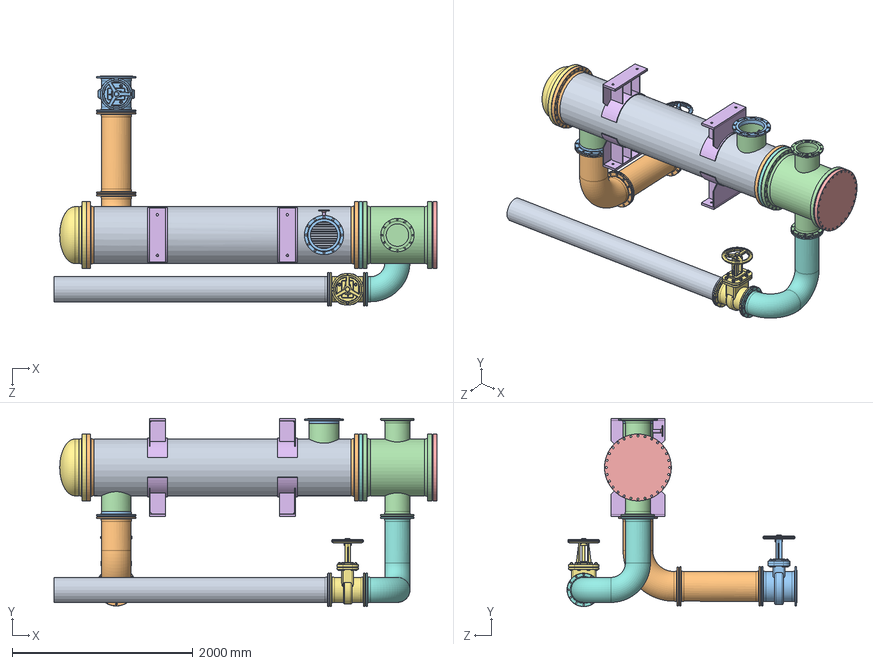
[picture p26: CAD file, 2025-09-01, last stored version]
static/images/3D/Трубчатые/15/Permutador e andaimes G.C/Montagem permutador inferiorg.c..SLDASM
4241.3 x 2084.0 x 2546.3 mm
Casco
Flange casco x 2
Flange tubo casco x 2
tubo casco x 2
Flange dreno x 2
tubo dreno x 2
Boleadog.c.
Espelho fixog.c.
Tubosg.c.
Espelho flutuanteg.c.
Chicanasg.c. x 12
Caretelg.c.
Tampa do carretelg.c.
Suporteg.c. x 4
Gate valve DN 100 PN 1,6 MPa (MZTA)g.c.
Saida carretel inferiorg.c.
tub inferior produtog.c.
saida casco inferiorg.c.
Gate valve DN 100 PN 1,6 MPa (MZTA) maiorg.c.
