BonisOleg/adiabatic/static/images/3D/Нестандарт/10/Heat Exchanger.stp

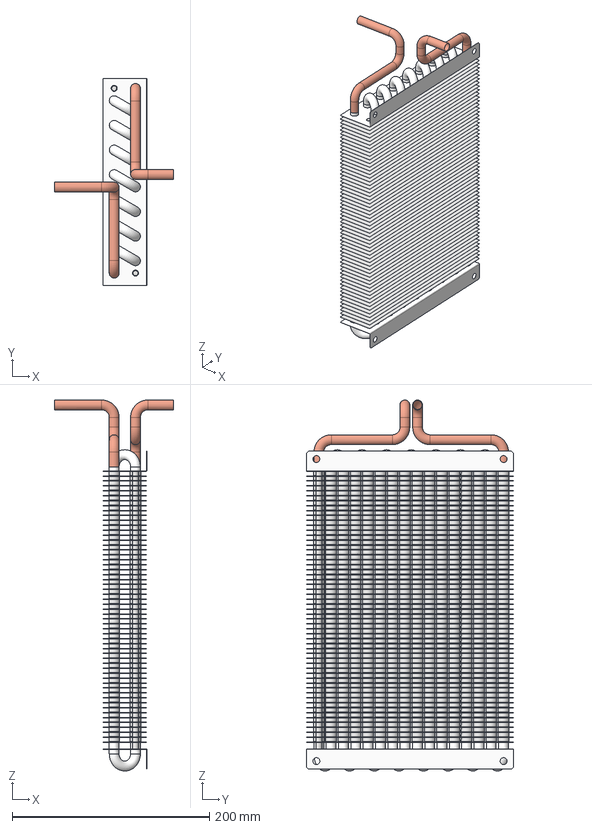
[picture p27: CAD file, 2025-09-01, last stored version]
static/images/3D/Нестандарт/10/Heat Exchanger.stp
121.0 x 210.0 x 376.4 mm
End Plate 1
End Plate 2
Support Rod x 2
Pipe 3 x 16
Pipe 5 x 15
Pipe 1
Pipe 2
cOOLING pLATE x 55
