BonisOleg/adiabatic/static/images/3D/Нестандарт/6/Carcasa.SLDPRT

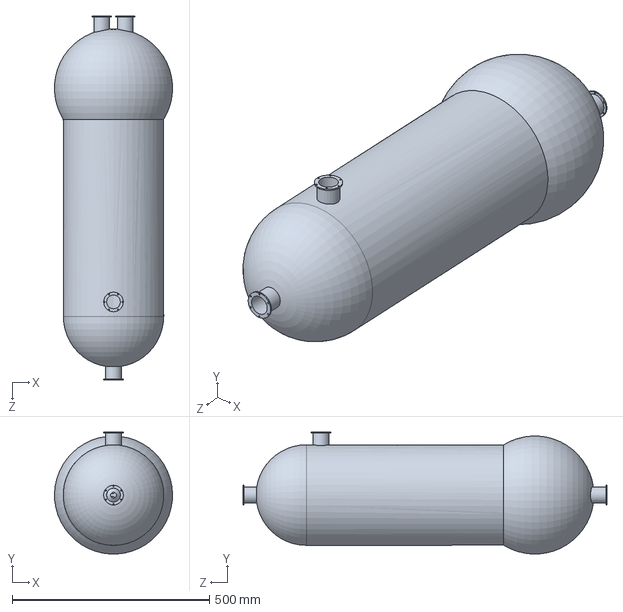
[picture p28: CAD file, 2025-09-01, last stored version]
static/images/3D/Нестандарт/6/Carcasa.SLDPRT
299.4 x 309.5 x 922.5 mm
