BonisOleg/adiabatic/static/images/3D/Паяные/1/plate A.SLDPRT

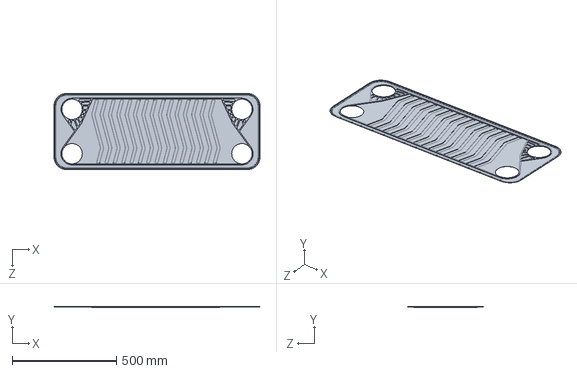
[picture p29: CAD file, 2025-09-01, last stored version]
static/images/3D/Паяные/1/plate A.SLDPRT
990.0 x 3.72 x 366.0 mm
