BonisOleg/adiabatic/static/images/3D/Пластинчатые/1/FP09-77-1-NH.stp

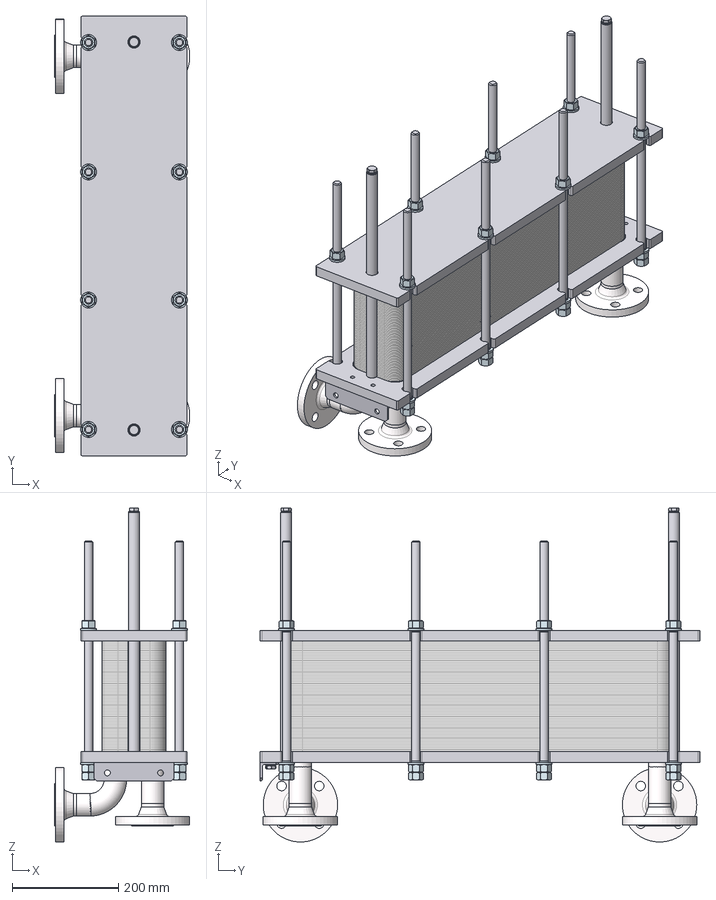
[picture p30: CAD file, 2025-09-01, last stored version]
static/images/3D/Пластинчатые/1/FP09-77-1-NH.stp
254.9 x 827.0 x 628.4 mm
DIN 933 - ersetzt durch DIN EN 24017 M10 x 40 x 2
DIN 933 - ersetzt durch DIN EN 24017 M10 x 20 x 2
