BonisOleg/adiabatic/static/images/3D/Пластинчатые/2/Wisselaar.stp

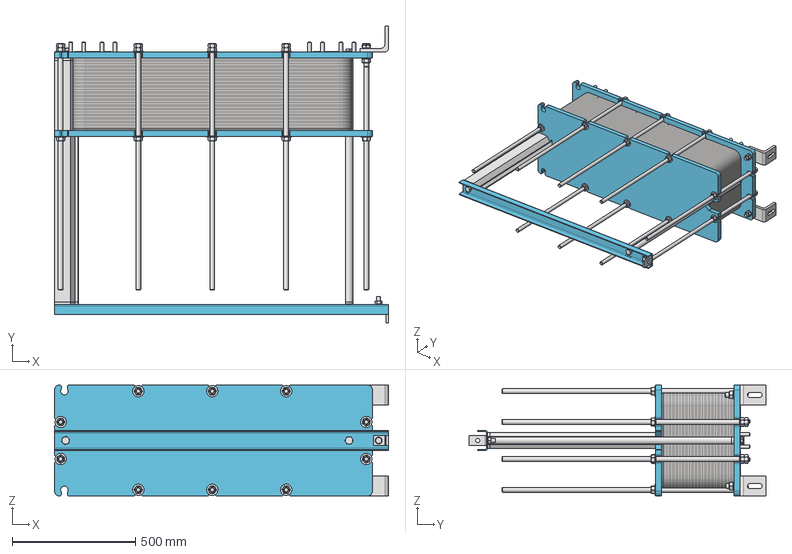
[picture p31: CAD file, 2025-09-01, last stored version]
static/images/3D/Пластинчатые/2/Wisselaar.stp
1355.0 x 1204.0 x 450.0 mm
Backplate_
Frontplate
boven_bar_1
Afdekplaat x 2
Onder_bar_1
Moer_onderbar x 2
trekstang x 10
Ring_Trekstang x 20
DIN 934 - M20 x 2_1 x 3
DIN 934 - M20 x 2 x 29
Plaat x 60
Eindplaat
Draadeind x 32
DIN 125 - A 21
DIN 125 - A 17
DIN 933 - M20 x 50
DIN 933 - M16 x 50
aansluiting x 4
Achterkant
Poot_voor x 2
Beugel_achter
DIN 433 - 19 x 8
DIN 433 - 21 x 3
DIN 433 - 17
DIN 933 - M20 x 75 x 2
DIN 933 - M16 x 50_1
DIN 933 - M20 x 50_1 x 2
DIN 934 - M16
