BonisOleg/adiabatic/static/images/3D/Пластинчатые/3/Heat Exchanger Funke FP-70.stp

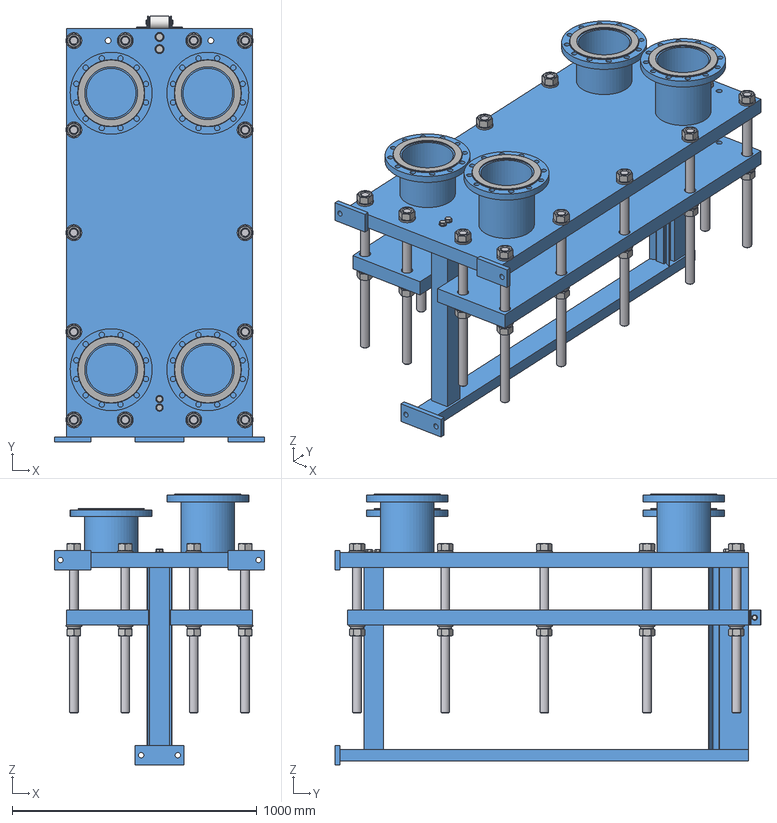
[picture p32: CAD file, 2025-09-01, last stored version]
static/images/3D/Пластинчатые/3/Heat Exchanger Funke FP-70.stp
860.0 x 1740.0 x 1107.5 mm
ﾄﾀﾍ.7.00.01.23
ﾄﾀﾍ.7.00.00.39 x 2
ﾄﾀﾍ.7.00.00.39-06 x 2
ﾄﾀﾍ.7.00.05.01-01 x 2
ﾄﾀﾍ.7.00.01.67
ﾄﾀﾍ.7.00.08.20 x 2
ﾄﾀﾍ.7.00.08.21-01
襞旂 13942-68 x 2
ﾄﾀﾍ.7.00.08.36
ﾄﾀﾍ.6.00.10.02
ﾄﾀﾍ.7.00.08.40-03 x 2
ﾄﾀﾍ.7.00.08.40-02 x 2
ﾄﾀﾍ.7.00.05.02
ﾄﾀﾍ.7.00.02.17-01
ﾄﾀﾍ.7.00.03.01-01 x 28
ﾄﾀﾍ.6.00.00.07-13 x 14
