BonisOleg/adiabatic/static/images/3D/Пластинчатые/5/Alfa Laval TK20-BWFG.STEP

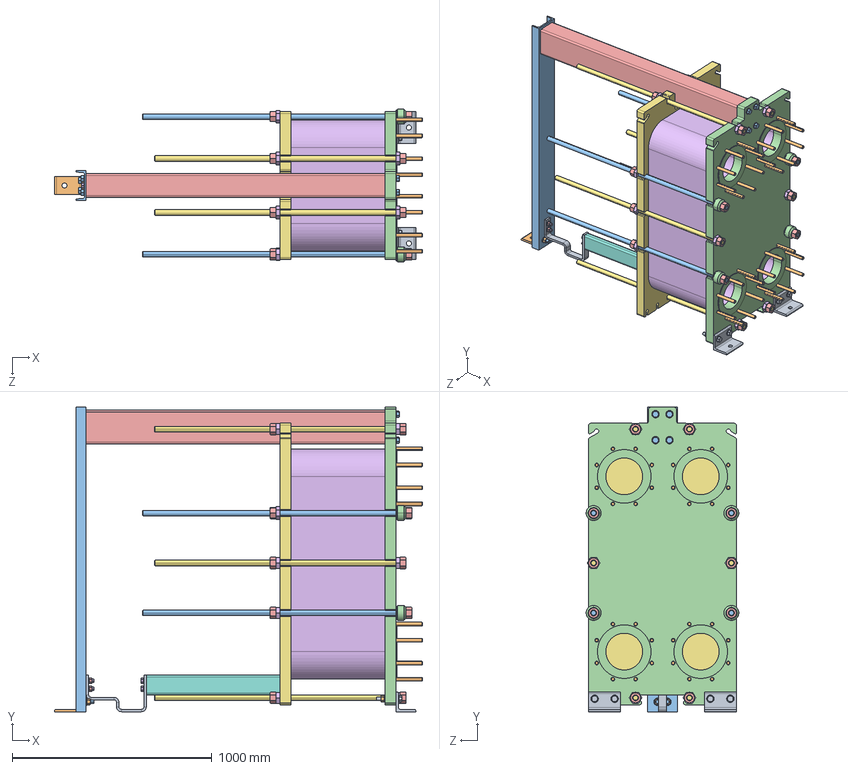
[picture p33: CAD file, 2025-09-01, last stored version]
static/images/3D/Пластинчатые/5/Alfa Laval TK20-BWFG.STEP
1843.0 x 1525.0 x 765.0 mm
Cantoneira TK20-BWFG x 2
Cantoneira2 TK20-BWFG
Perfil U TK20-BWFG
Placa Fixa TK20-BWFG
Travessa Superior TK20-BWFG
Placas TK20-BWFG
Placa Movel TK20-BWFG
Travessa Inferior TK20-BWFG
Chapa Apoio TK20-BWFG
Parafuso 3-4X150 TK20-BWFG x 32
Parafuso M30 TK20-BWFG x 4
Bucha TK20-BWFG x 4
hex nut heavy_a_B18.2.4.6M - Heavy hex nut, M30 x 3.5 --W-N x 20
Contraporca TK20-BWFG x 16
Parafuso M30 TK20-BWFG_Curto x 6
flat washer type a narrow_ai_Preferred Narrow FW 0.75 x 20
hex bolt_ai_HBOLT 0.7500-16x4.5x1.75-N x 4
hex nut_ai_HNUT 0.7500-16-B-N x 6
hex bolt_ai_HBOLT 0.7500-16x2.5x1.75-N x 10
flat washer type a narrow_ai_Preferred Narrow FW 0.625 x 6
hex nut_ai_HNUT 0.6250-18-D-N x 2
hex bolt_ai_HBOLT 0.6250-18x2x1.5-N x 4
