BonisOleg/adiabatic/static/images/3D/Пластинчатые/6/Alfa Laval T20-BWFG.SLDPRT

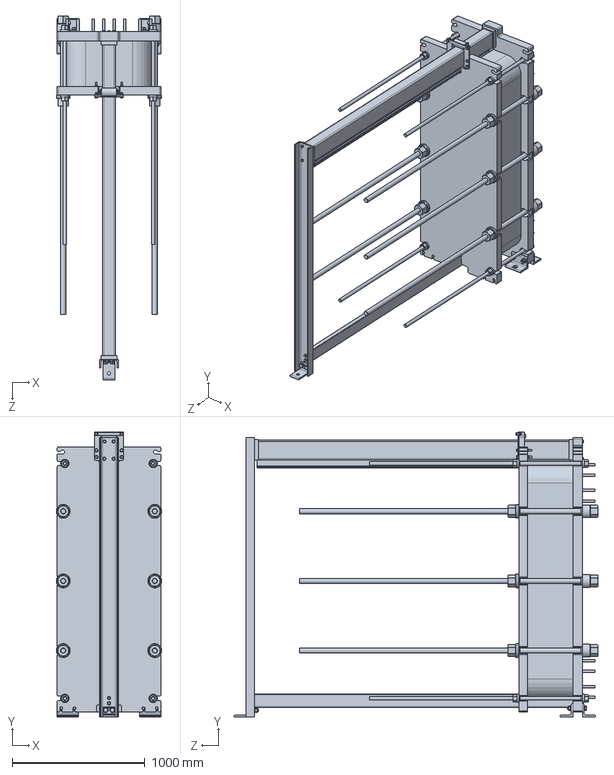
[picture p34: CAD file, 2025-09-01, last stored version]
static/images/3D/Пластинчатые/6/Alfa Laval T20-BWFG.SLDPRT
795.0 x 2145.0 x 2743.0 mm
