BonisOleg/adiabatic/static/images/3D/Пластинчатые/8/TGB OIL COOLER  EDL.stp

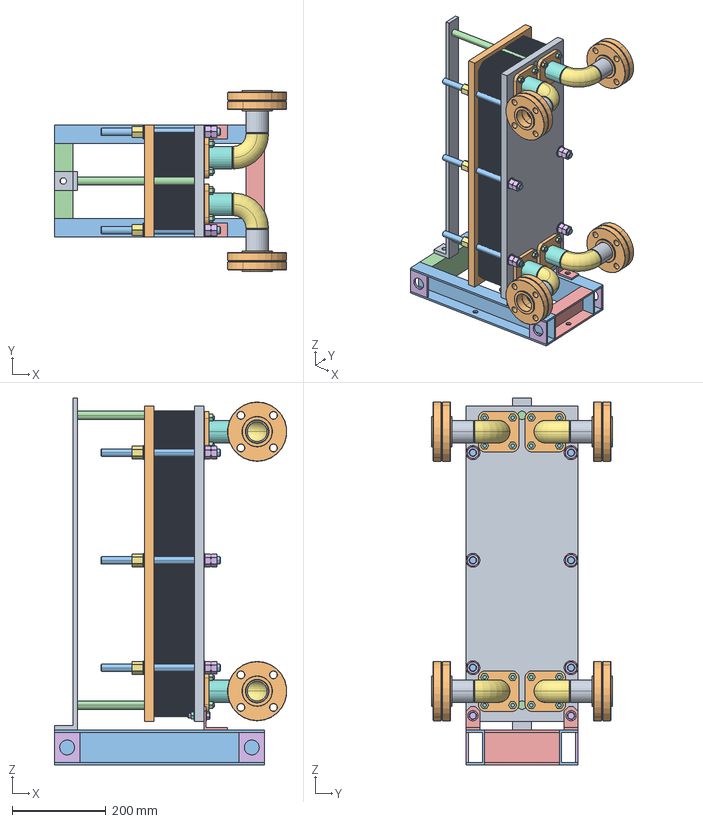
[picture p35: CAD file, 2025-09-01, last stored version]
static/images/3D/Пластинчатые/8/TGB OIL COOLER EDL.stp
497.2 x 387.4 x 785.0 mm
