BonisOleg/adiabatic/static/images/3D/Трубчатые/10/Shell and Tube Heat Exchanger.stp

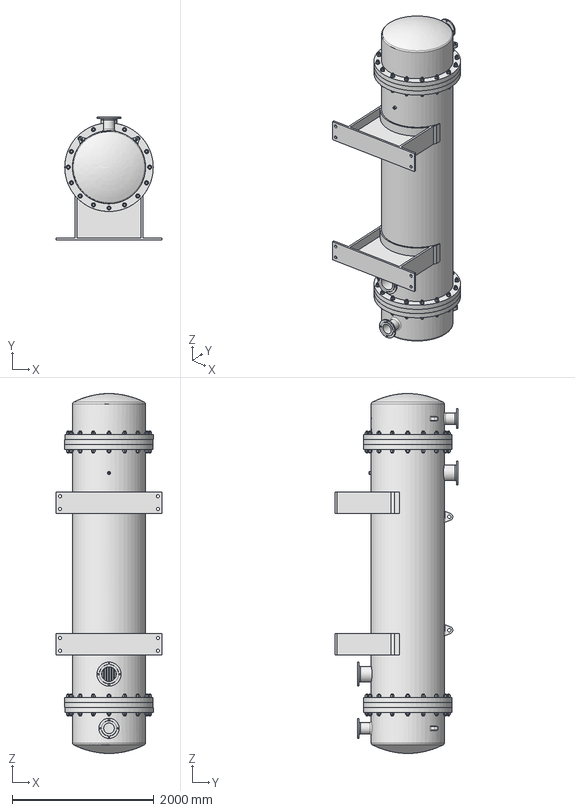
[picture p37: CAD file, 2025-09-01, last stored version]
static/images/3D/Трубчатые/10/Shell and Tube Heat Exchanger.stp
1500.0 x 1742.0 x 5080.0 mm
Tube sheet x 2
Tube x 296
Tube_MIR2 x 296
Baffle x 12
Holder x 2
Rear-end header
Front-end header
ISO 8673 - M33 x 2 x 64
DIN 126 - 36 x 64
Thread_MIR1 x 32
