BonisOleg/adiabatic/static/images/3D/Трубчатые/11/SHELL COVER.SLDPRT

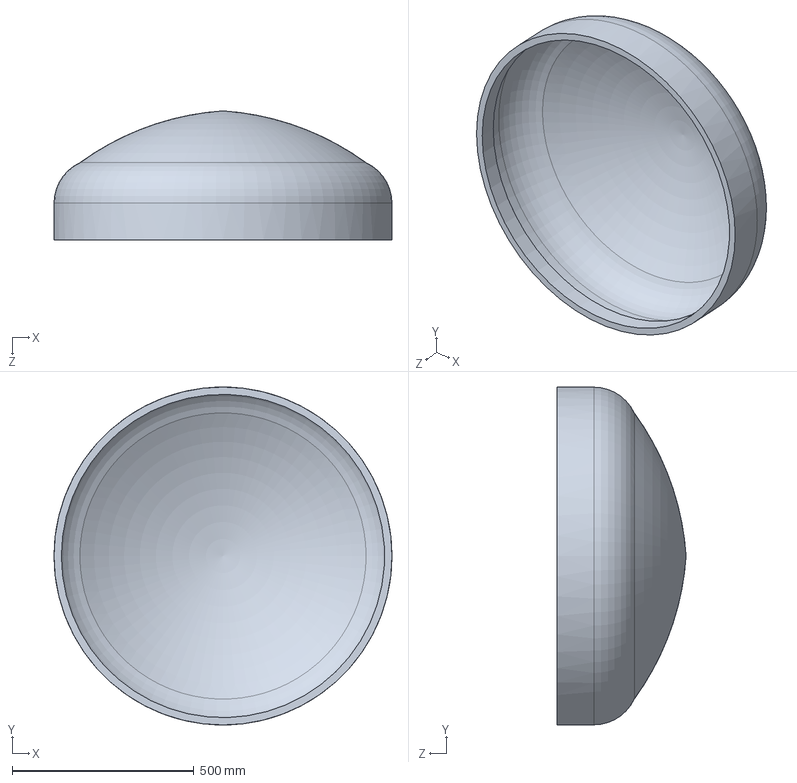
[picture p38: CAD file, 2025-09-01, last stored version]
static/images/3D/Трубчатые/11/SHELL COVER.SLDPRT
929.6 x 929.6 x 355.6 mm
