BonisOleg/adiabatic/static/images/3D/Трубчатые/14/SHELL/PLATE IDENTIFICATION SUPPORT.SLDPRT

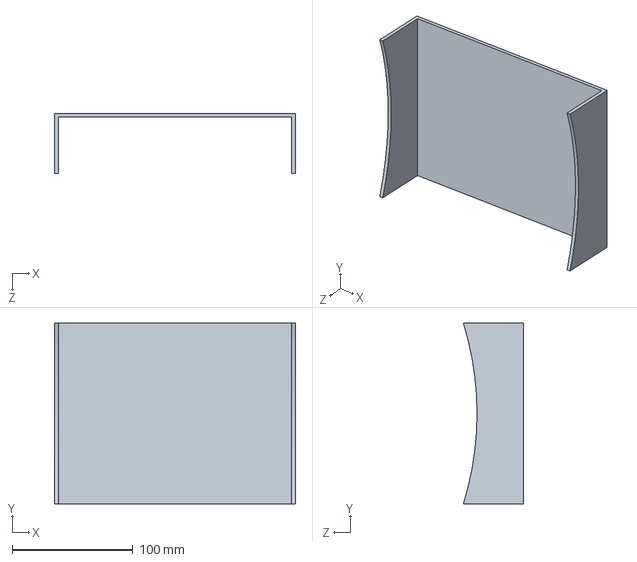
[picture p39: CAD file, 2025-09-01, last stored version]
static/images/3D/Трубчатые/14/SHELL/PLATE IDENTIFICATION SUPPORT.SLDPRT
200.0 x 150.0 x 50.0 mm
