BonisOleg/adiabatic/static/images/3D/Трубчатые/14/SUPPORT SADDLE FIX AND MOBILE DIAM 508/PLATE 160 X 640 X 15,8.SLDPRT

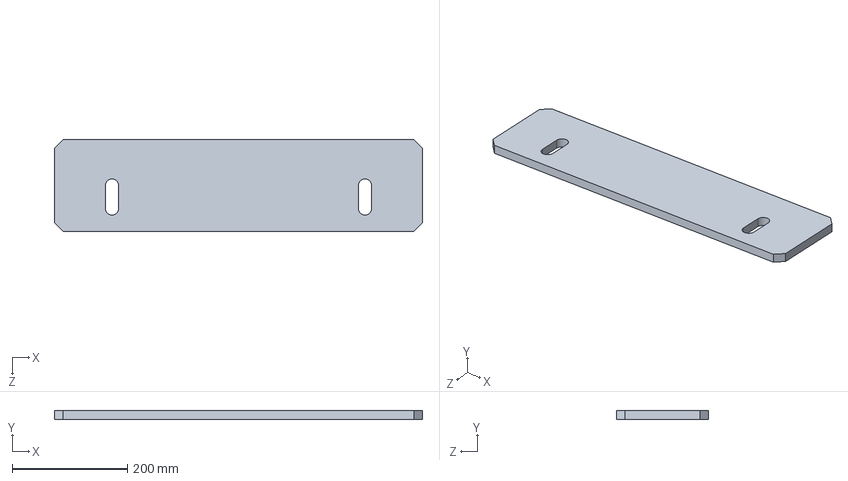
[picture p41: CAD file, 2025-09-01, last stored version]
static/images/3D/Трубчатые/14/SUPPORT SADDLE FIX AND MOBILE DIAM 508/PLATE 160 X 640 X 15,8.SLDPRT
640.0 x 15.8 x 160.0 mm
