BonisOleg/adiabatic/static/images/3D/Трубчатые/15/Permutador e andaimes G.C/Gate valve DN 100 PN 1,6 MPa (MZTA) maiorg.c..SLDPRT

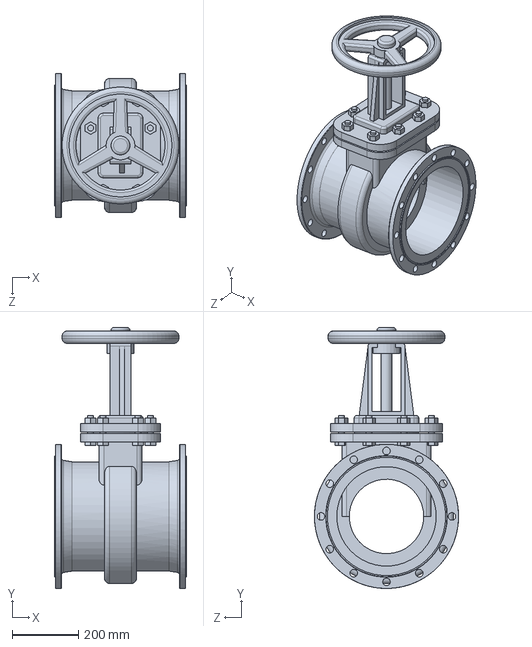
[picture p42: CAD file, 2025-09-01, last stored version]
static/images/3D/Трубчатые/15/Permutador e andaimes G.C/Gate valve DN 100 PN 1,6 MPa (MZTA) maiorg.c..SLDPRT
399.3 x 787.5 x 435.0 mm
