BonisOleg/adiabatic/static/images/3D/Трубчатые/5/berk_taşıyıcı.SLDPRT

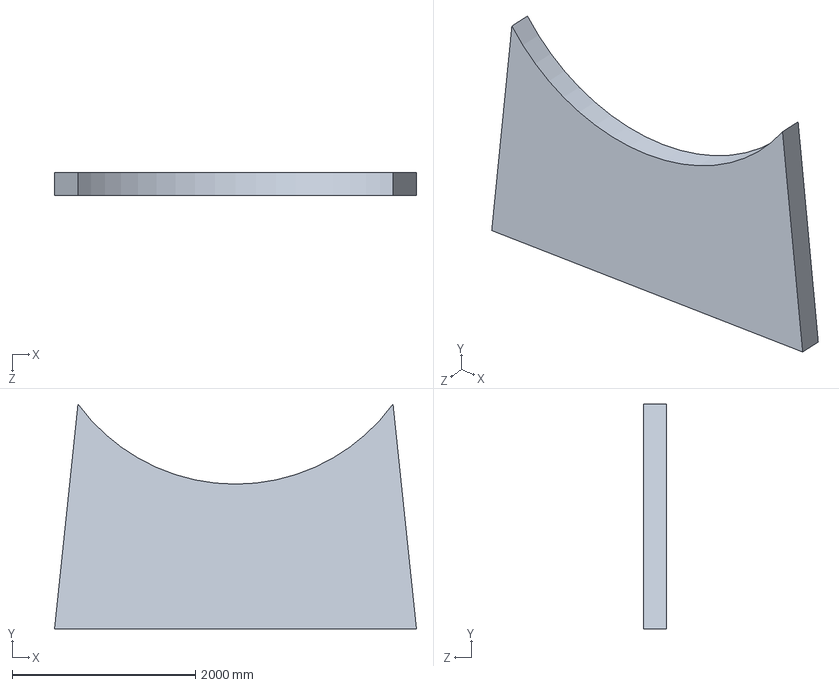
[picture p43: CAD file, 2025-09-01, last stored version]
static/images/3D/Трубчатые/5/berk_taşıyıcı.SLDPRT
3956.2 x 2458.8 x 255.0 mm
