BonisOleg/adiabatic/static/images/3D/Трубчатые/7/Heat Exchanger.igs

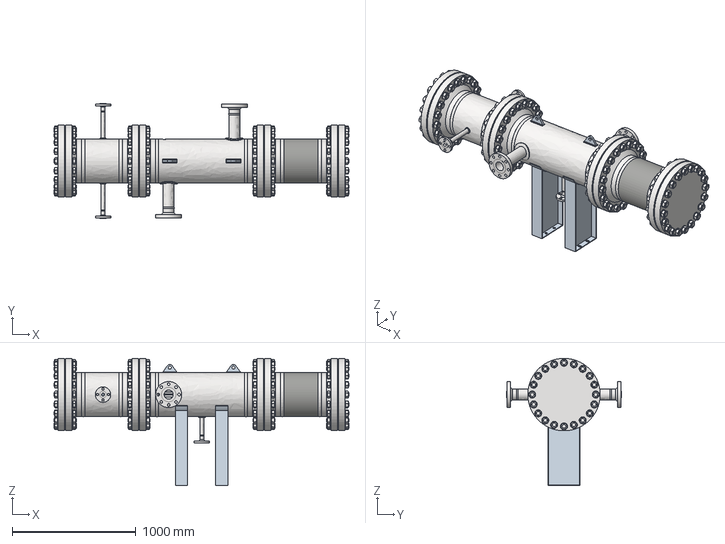
[picture p44: CAD file, 2025-09-01, last stored version]
static/images/3D/Трубчатые/7/Heat Exchanger.igs
2383.3 x 925.6 x 1027.8 mm
