BonisOleg/adiabatic/static/images/3D/Нестандарт/4/finned tube he/condensate outlet.SLDPRT

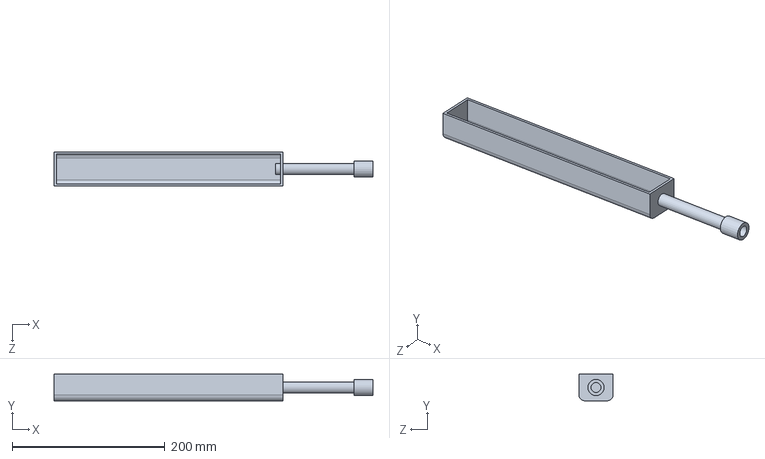
[picture p45: CAD file, 2025-09-01, last stored version]
static/images/3D/Нестандарт/4/finned tube he/condensate outlet.SLDPRT
418.0 x 35.0 x 45.0 mm
