BonisOleg/adiabatic/static/images/3D/Паяные/1/cover 1.SLDPRT

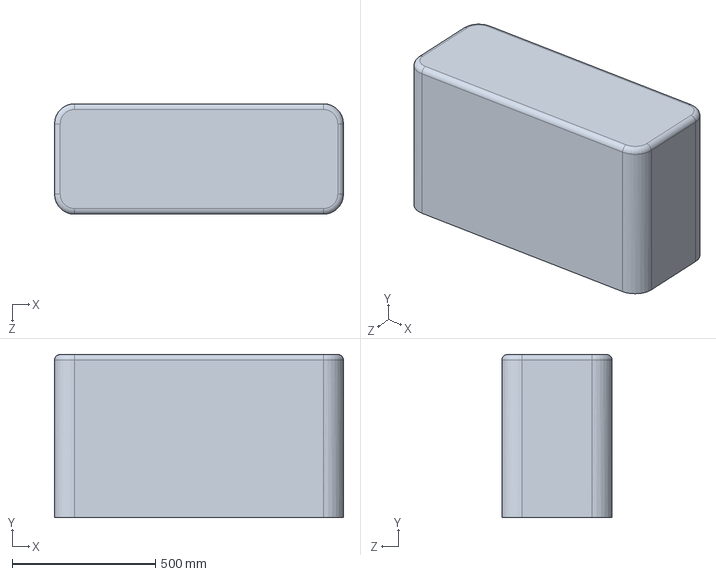
[picture p46: CAD file, 2025-09-01, last stored version]
static/images/3D/Паяные/1/cover 1.SLDPRT
1010.0 x 570.0 x 386.0 mm
