BonisOleg/adiabatic/static/images/3D/Трубчатые/11/SHELL.SLDPRT

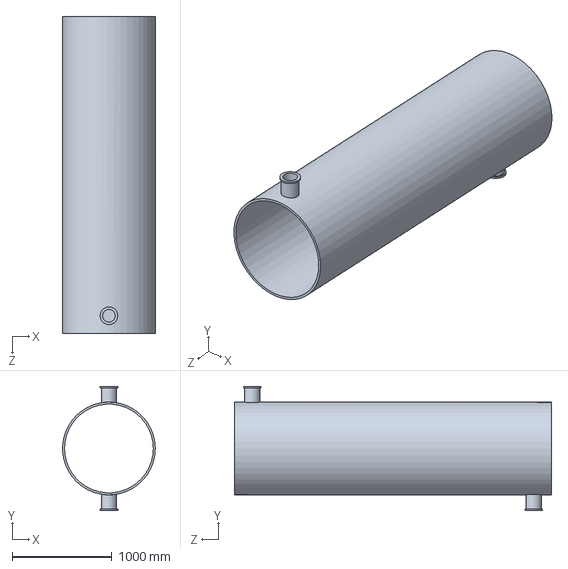
[picture p47: CAD file, 2025-09-01, last stored version]
static/images/3D/Трубчатые/11/SHELL.SLDPRT
928.4 x 1246.6 x 3175.0 mm
