BonisOleg/adiabatic/static/images/3D/Трубчатые/14/BONNET/BONNET LIFTING LUG.SLDPRT

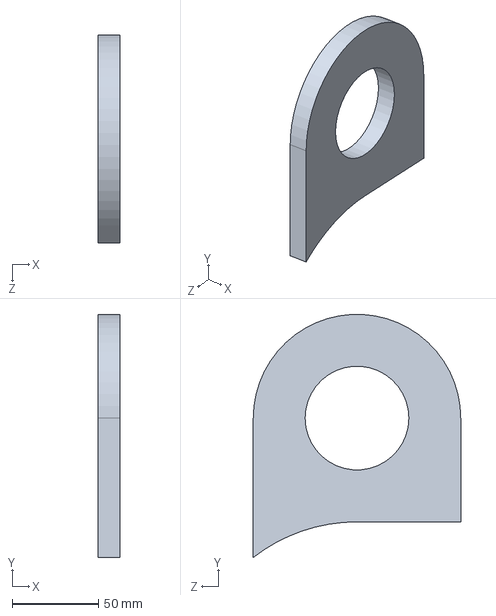
[picture p48: CAD file, 2025-09-01, last stored version]
static/images/3D/Трубчатые/14/BONNET/BONNET LIFTING LUG.SLDPRT
12.7 x 140.5 x 120.0 mm
