BonisOleg/adiabatic/static/images/3D/Трубчатые/14/SHELL/SHELL COVER DIAM 508 X 177.SLDPRT

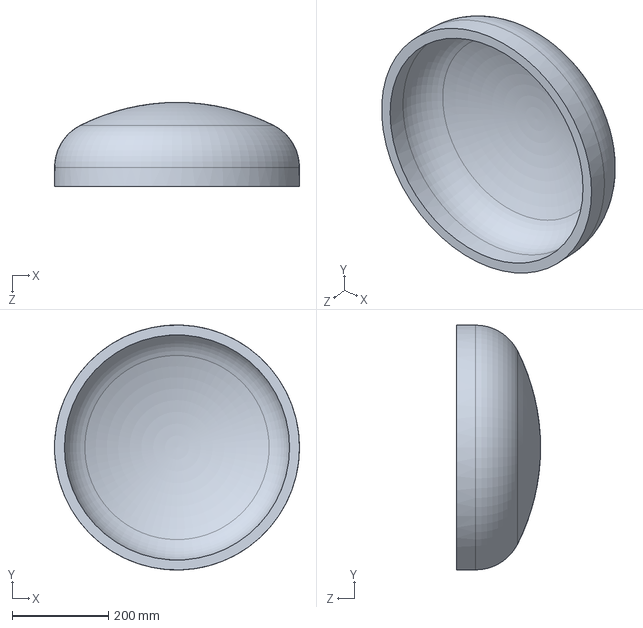
[picture p49: CAD file, 2025-09-01, last stored version]
static/images/3D/Трубчатые/14/SHELL/SHELL COVER DIAM 508 X 177.SLDPRT
508.0 x 507.8 x 174.7 mm
