BonisOleg/adiabatic/static/images/3D/Трубчатые/15/Permutador e andaimes G.C/Flange dreno.SLDPRT

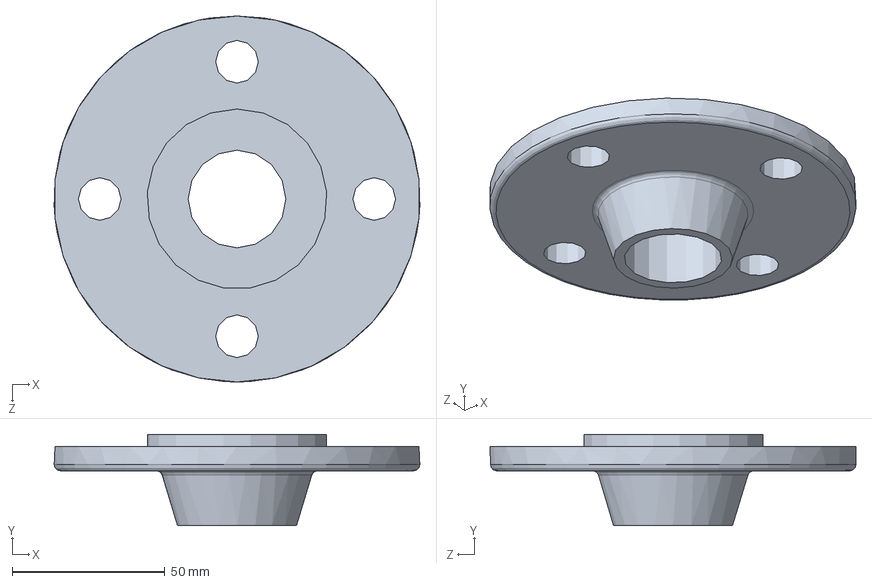
[picture p51: CAD file, 2025-09-01, last stored version]
static/images/3D/Трубчатые/15/Permutador e andaimes G.C/Flange dreno.SLDPRT
119.9 x 30.0 x 120.0 mm
