BonisOleg/adiabatic/static/images/3D/Трубчатые/3/GASKET.SLDPRT

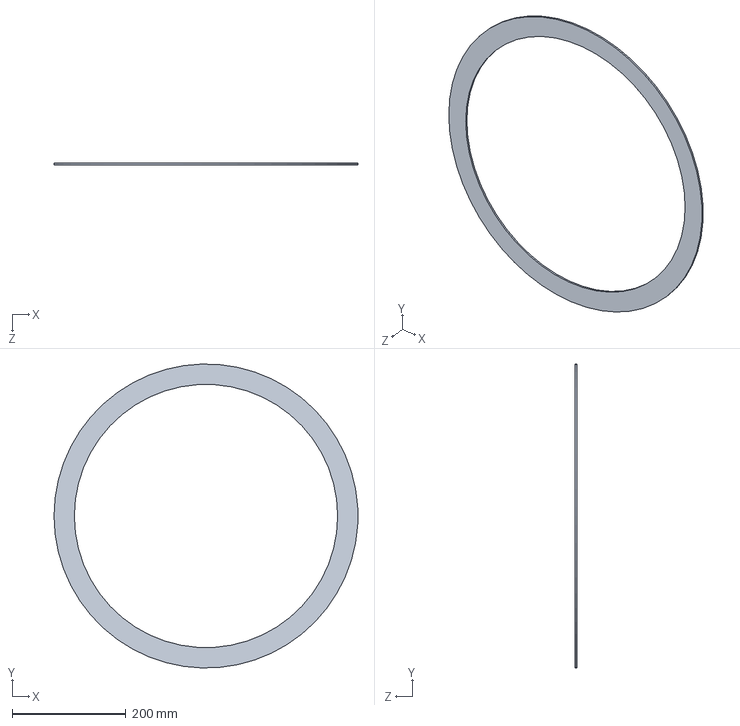
[picture p52: CAD file, 2025-09-01, last stored version]
static/images/3D/Трубчатые/3/GASKET.SLDPRT
533.4 x 533.2 x 3.17 mm
