BonisOleg/adiabatic/static/images/3D/Трубчатые/5/berk_bombe.SLDPRT

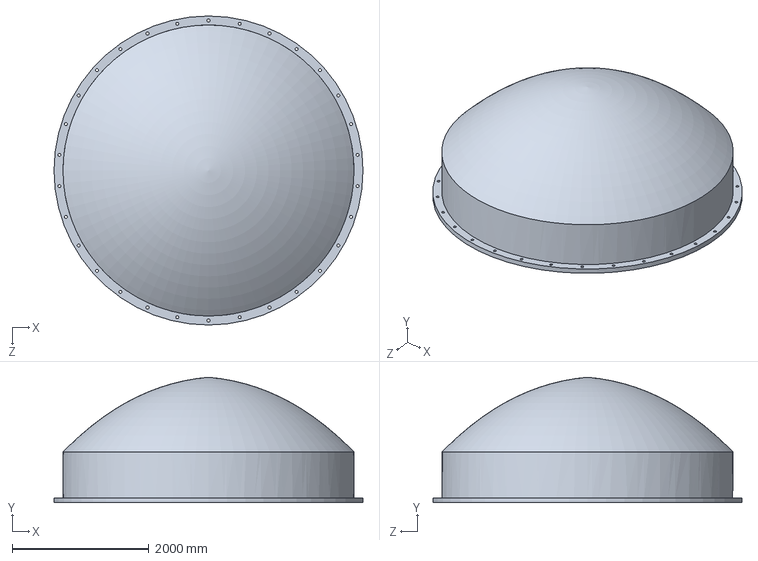
[picture p53: CAD file, 2025-09-01, last stored version]
static/images/3D/Трубчатые/5/berk_bombe.SLDPRT
4524.0 x 1837.4 x 4524.0 mm
