BonisOleg/adiabatic/static/images/3D/Нестандарт/4/finned tube he/50x100 channel.SLDPRT

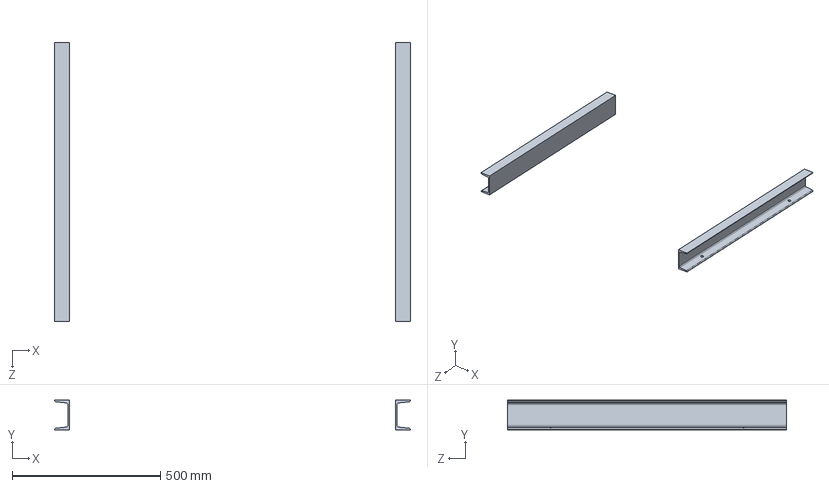
[picture p54: CAD file, 2025-09-01, last stored version]
static/images/3D/Нестандарт/4/finned tube he/50x100 channel.SLDPRT
1200.0 x 100.0 x 940.0 mm
