BonisOleg/adiabatic/static/images/3D/Трубчатые/14/BONNET/FLANGE DIAM 636 X 51.SLDPRT

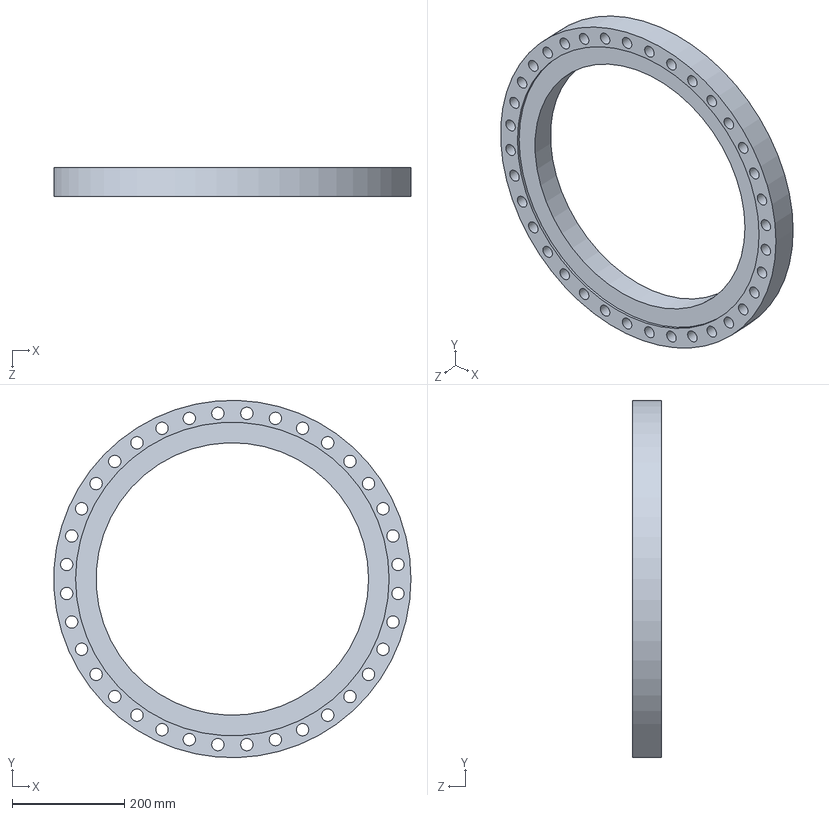
[picture p55: CAD file, 2025-09-01, last stored version]
static/images/3D/Трубчатые/14/BONNET/FLANGE DIAM 636 X 51.SLDPRT
635.4 x 635.7 x 51.0 mm
