BonisOleg/adiabatic/static/images/3D/Трубчатые/14/STATIONARY TUBESHEET/TRANSVERSE BAFFLE SUPERIOR.SLDPRT

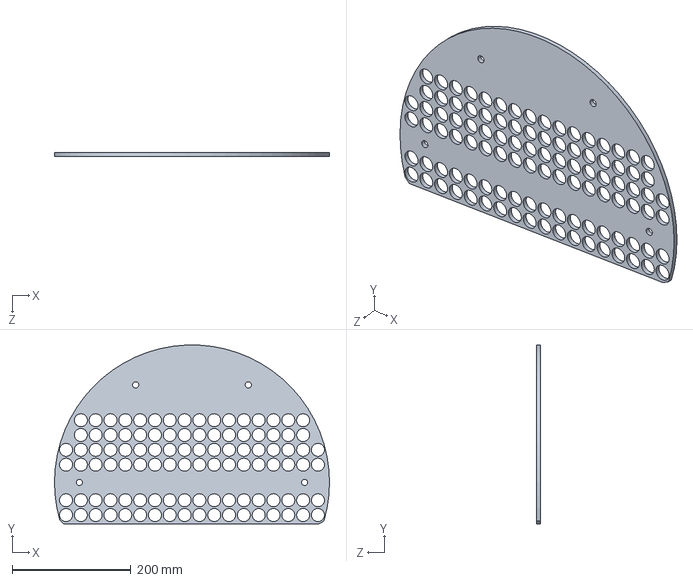
[picture p56: CAD file, 2025-09-01, last stored version]
static/images/3D/Трубчатые/14/STATIONARY TUBESHEET/TRANSVERSE BAFFLE SUPERIOR.SLDPRT
464.0 x 301.8 x 6.35 mm
