BonisOleg/adiabatic/static/images/3D/Трубчатые/3/Rod End .5in thrd.SLDPRT

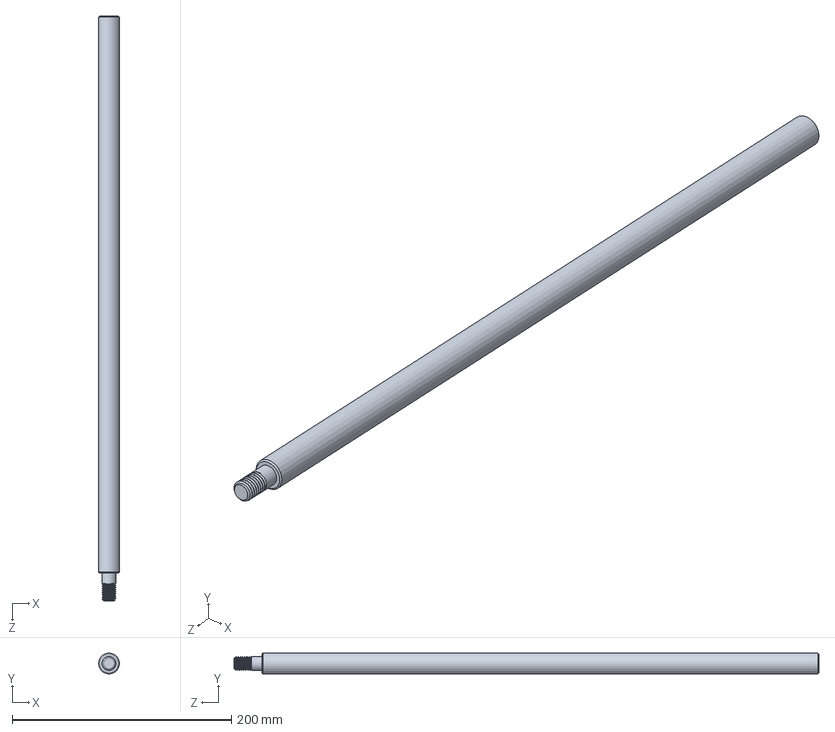
[picture p57: CAD file, 2025-09-01, last stored version]
static/images/3D/Трубчатые/3/Rod End .5in thrd.SLDPRT
19.1 x 19.1 x 533.4 mm
