BonisOleg/adiabatic/static/images/3D/Трубчатые/5/berk_gövdekesik.SLDPRT

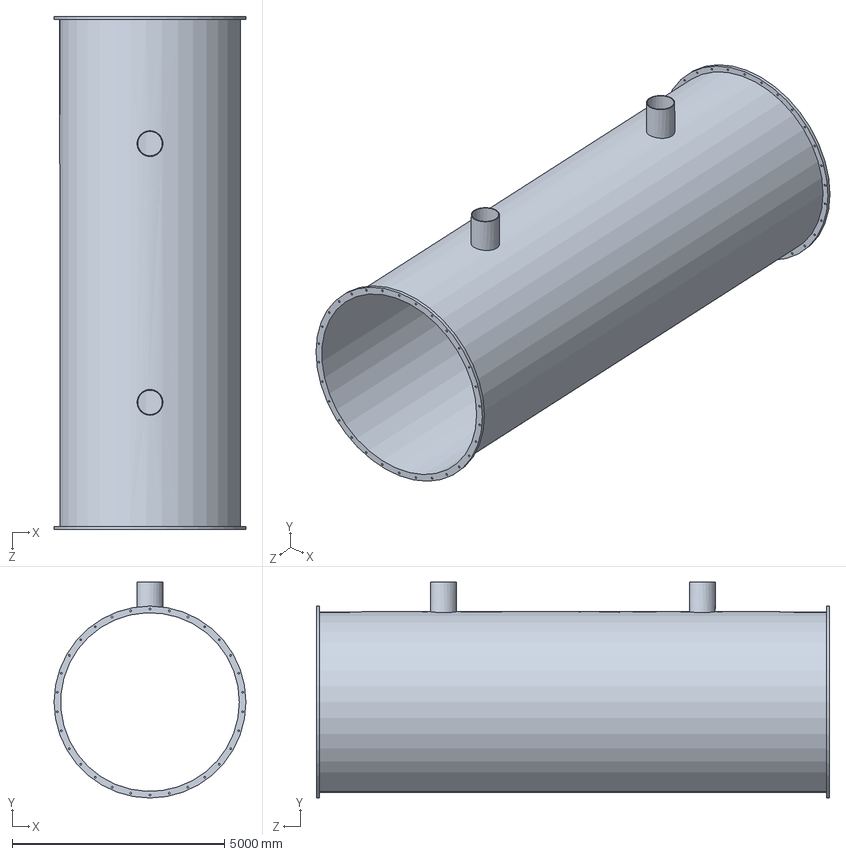
[picture p58: CAD file, 2025-09-01, last stored version]
static/images/3D/Трубчатые/5/berk_gövdekesik.SLDPRT
4524.0 x 5092.0 x 12100.0 mm
