BonisOleg/adiabatic/static/images/3D/Нестандарт/4/finned tube he/tube holding plate.SLDPRT

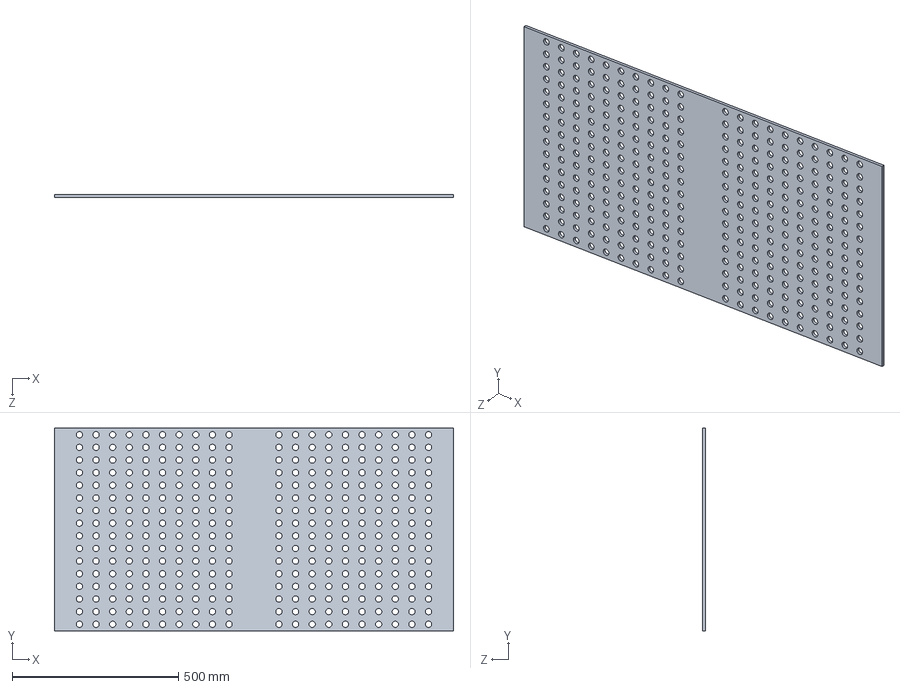
[picture p59: CAD file, 2025-09-01, last stored version]
static/images/3D/Нестандарт/4/finned tube he/tube holding plate.SLDPRT
1200.0 x 610.0 x 8.00 mm
