BonisOleg/adiabatic/static/images/3D/Паяные/1/cover 2.SLDPRT

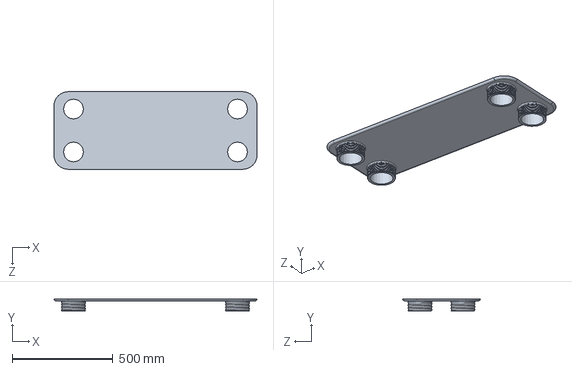
[picture p60: CAD file, 2025-09-01, last stored version]
static/images/3D/Паяные/1/cover 2.SLDPRT
1010.0 x 60.0 x 386.0 mm
