BonisOleg/adiabatic/static/images/3D/Трубчатые/11/STATIONARY TUBE SHEET.SLDPRT

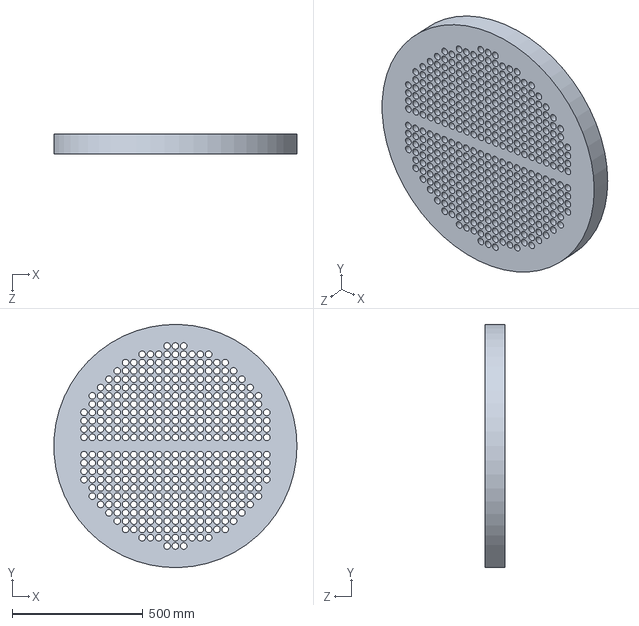
[picture p61: CAD file, 2025-09-01, last stored version]
static/images/3D/Трубчатые/11/STATIONARY TUBE SHEET.SLDPRT
928.8 x 929.2 x 76.2 mm
