BonisOleg/adiabatic/static/images/3D/Трубчатые/14/BONNET/PASS PARTITION.SLDPRT

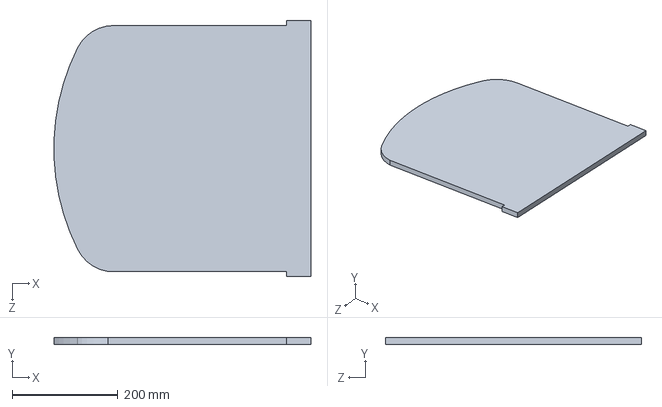
[picture p62: CAD file, 2025-09-01, last stored version]
static/images/3D/Трубчатые/14/BONNET/PASS PARTITION.SLDPRT
485.6 x 13.0 x 484.0 mm
