BonisOleg/adiabatic/static/images/3D/Трубчатые/14/STATIONARY TUBESHEET/BONNET GASKET.SLDPRT

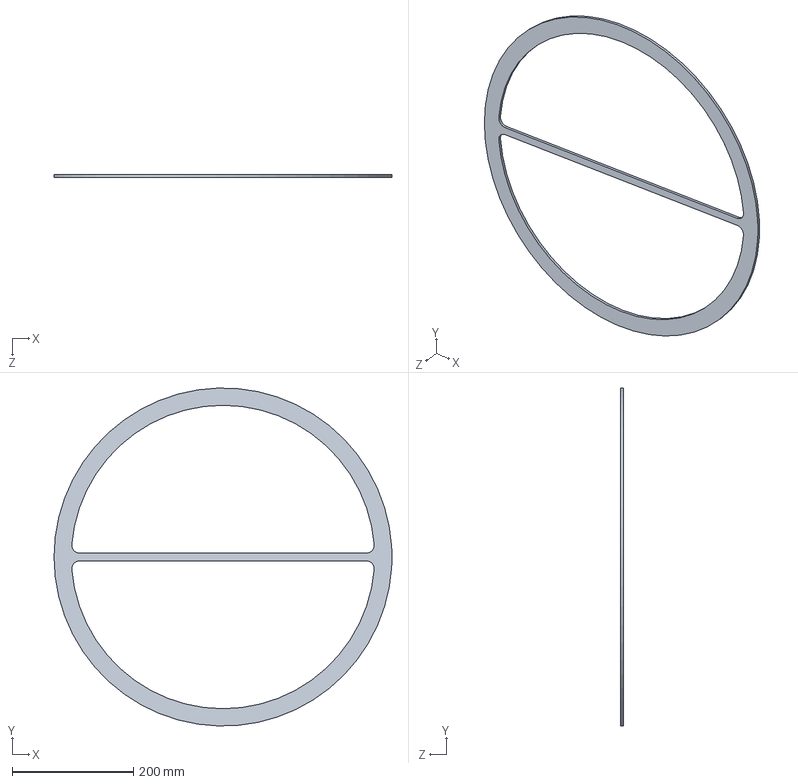
[picture p63: CAD file, 2025-09-01, last stored version]
static/images/3D/Трубчатые/14/STATIONARY TUBESHEET/BONNET GASKET.SLDPRT
557.0 x 556.8 x 4.50 mm
