BonisOleg/adiabatic/static/images/3D/Трубчатые/5/FLANGE.SLDPRT

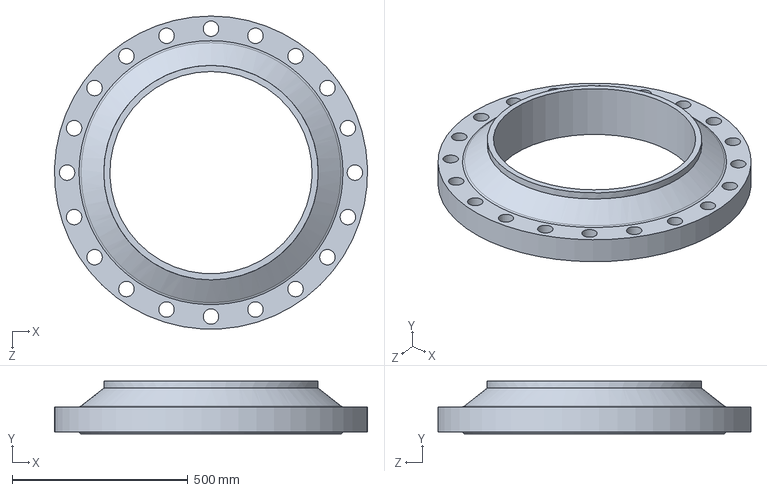
[picture p64: CAD file, 2025-09-01, last stored version]
static/images/3D/Трубчатые/5/FLANGE.SLDPRT
889.6 x 150.0 x 889.2 mm
