BonisOleg/adiabatic/static/images/3D/Нестандарт/4/finned tube he/50x50 angle.SLDPRT

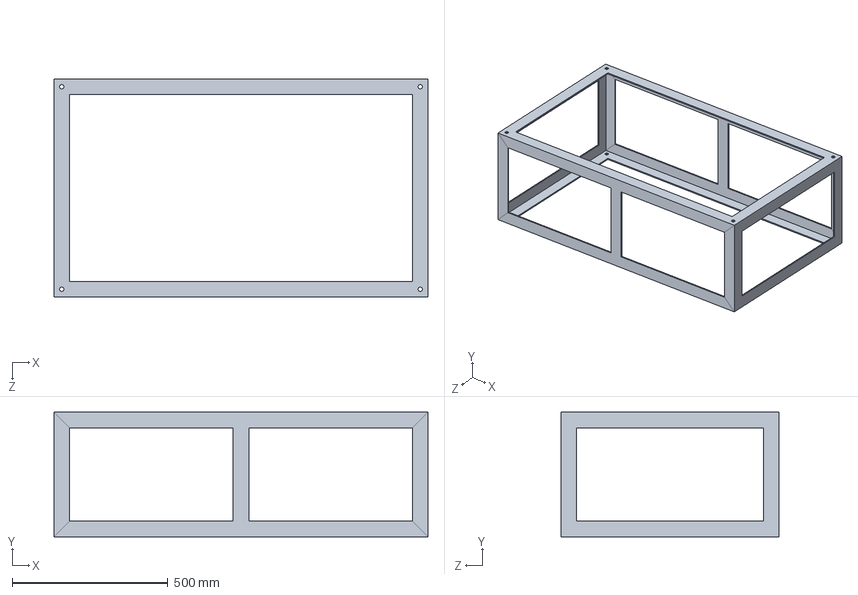
[picture p65: CAD file, 2025-09-01, last stored version]
static/images/3D/Нестандарт/4/finned tube he/50x50 angle.SLDPRT
1200.0 x 400.0 x 700.0 mm
