BonisOleg/adiabatic/static/images/3D/Трубчатые/14/SUPPORT SADDLE FIX AND MOBILE DIAM 508/PLATE 450 X 640 X 12,7.SLDPRT

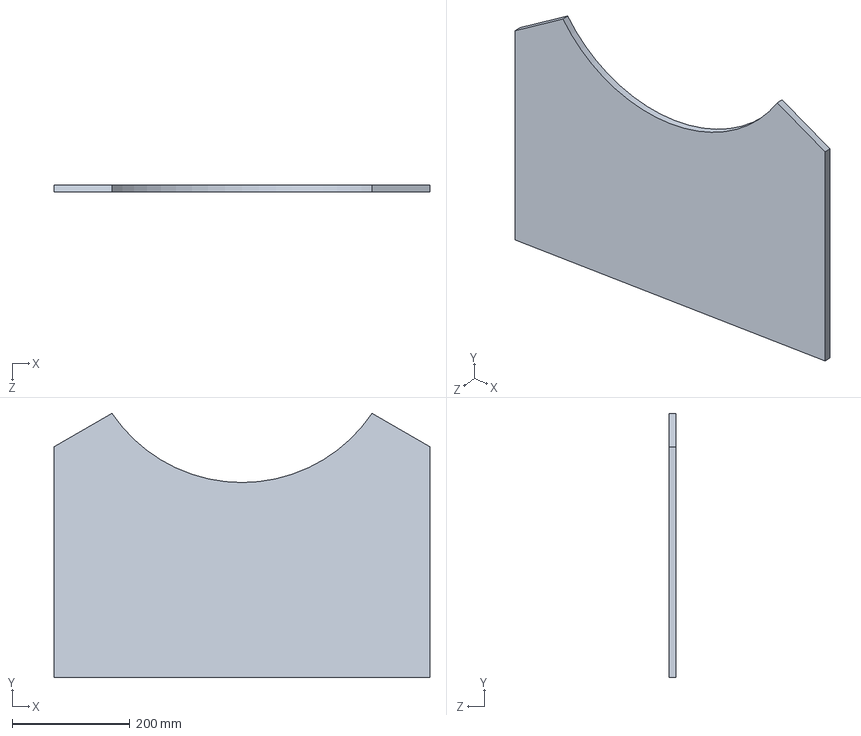
[picture p67: CAD file, 2025-09-01, last stored version]
static/images/3D/Трубчатые/14/SUPPORT SADDLE FIX AND MOBILE DIAM 508/PLATE 450 X 640 X 12,7.SLDPRT
640.0 x 450.0 x 12.7 mm
