BonisOleg/adiabatic/static/images/3D/Нестандарт/4/finned tube he/rh waterbox.SLDPRT

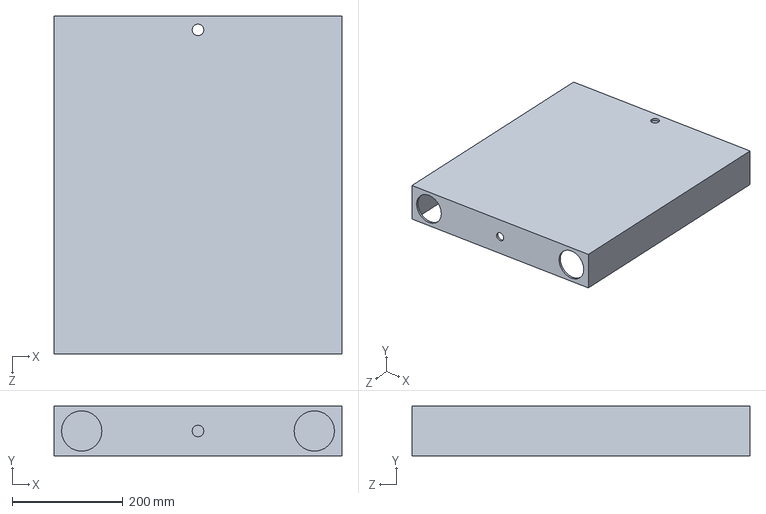
[picture p68: CAD file, 2025-09-01, last stored version]
static/images/3D/Нестандарт/4/finned tube he/rh waterbox.SLDPRT
520.0 x 90.0 x 610.0 mm
