BonisOleg/adiabatic/static/images/3D/Трубчатые/11/PENYANGGA HEAT EXCHNAGER.SLDPRT

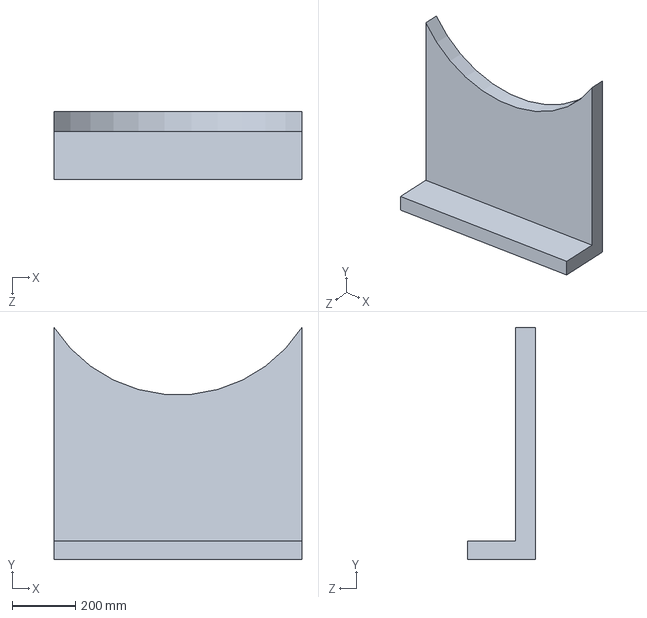
[picture p69: CAD file, 2025-09-01, last stored version]
static/images/3D/Трубчатые/11/PENYANGGA HEAT EXCHNAGER.SLDPRT
781.7 x 732.6 x 215.9 mm
