BonisOleg/adiabatic/static/images/3D/Трубчатые/14/SHELL/LIFTING LUG.SLDPRT

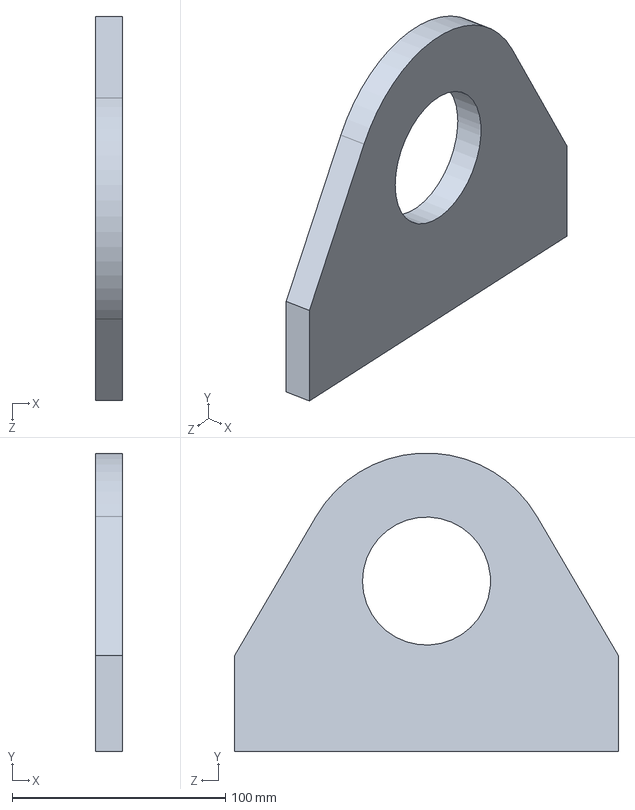
[picture p70: CAD file, 2025-09-01, last stored version]
static/images/3D/Трубчатые/14/SHELL/LIFTING LUG.SLDPRT
12.7 x 139.9 x 180.0 mm
