BonisOleg/adiabatic/static/images/3D/Трубчатые/14/STATIONARY TUBESHEET/TUBE DIAM. 0.5 SCH 80 X 4844.SLDPRT

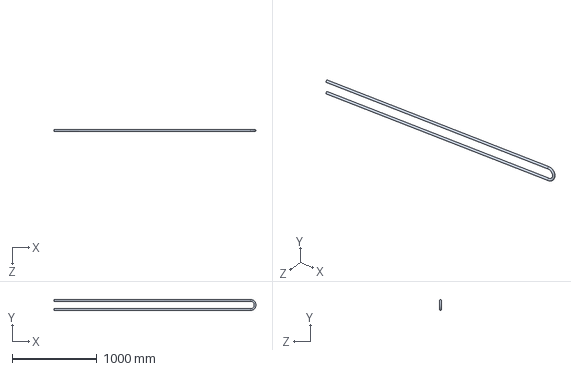
[picture p71: CAD file, 2025-09-01, last stored version]
static/images/3D/Трубчатые/14/STATIONARY TUBESHEET/TUBE DIAM. 0.5 SCH 80 X 4844.SLDPRT
2390.7 x 131.3 x 21.3 mm
