BonisOleg/adiabatic/static/images/3D/Трубчатые/14/SUPPORT SADDLE FIX AND MOBILE DIAM 508/PLATE 190 X 544 X 12,7.SLDPRT

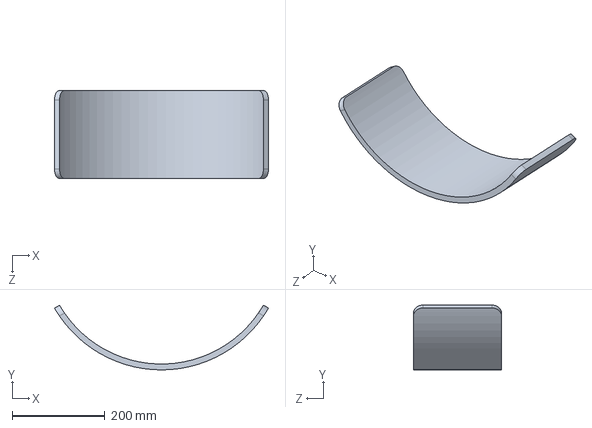
[picture p72: CAD file, 2025-09-01, last stored version]
static/images/3D/Трубчатые/14/SUPPORT SADDLE FIX AND MOBILE DIAM 508/PLATE 190 X 544 X 12,7.SLDPRT
462.1 x 140.0 x 190.0 mm
