BonisOleg/adiabatic/static/images/3D/Трубчатые/15/Permutador e andaimes G.C/saida casco inferiorg.c..SLDPRT

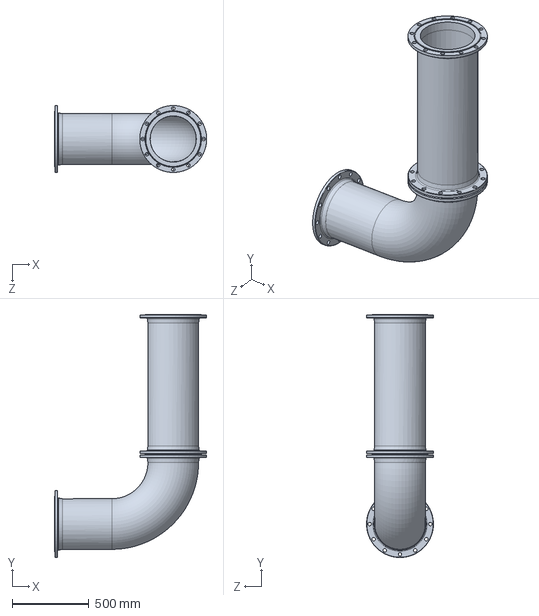
[picture p73: CAD file, 2025-09-01, last stored version]
static/images/3D/Трубчатые/15/Permutador e andaimes G.C/saida casco inferiorg.c..SLDPRT
990.5 x 1579.5 x 435.0 mm
