BonisOleg/adiabatic/static/images/3D/Трубчатые/3/End Pipe Cap.SLDPRT

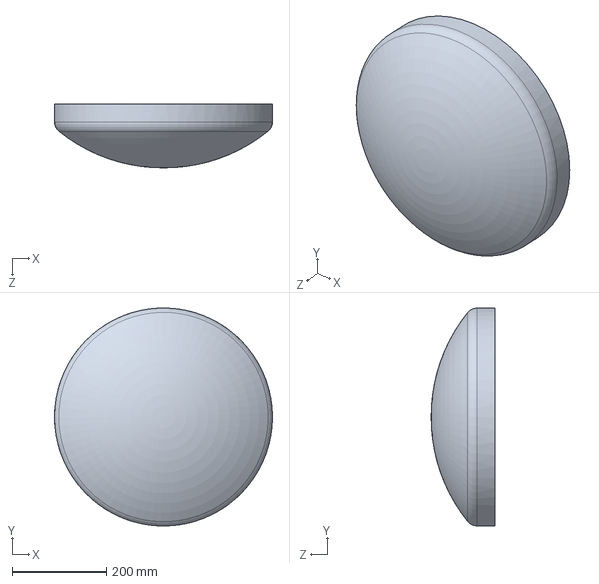
[picture p74: CAD file, 2025-09-01, last stored version]
static/images/3D/Трубчатые/3/End Pipe Cap.SLDPRT
461.8 x 461.6 x 135.0 mm
