BonisOleg/adiabatic/static/images/3D/Трубчатые/5/berk_bombekesik.SLDPRT

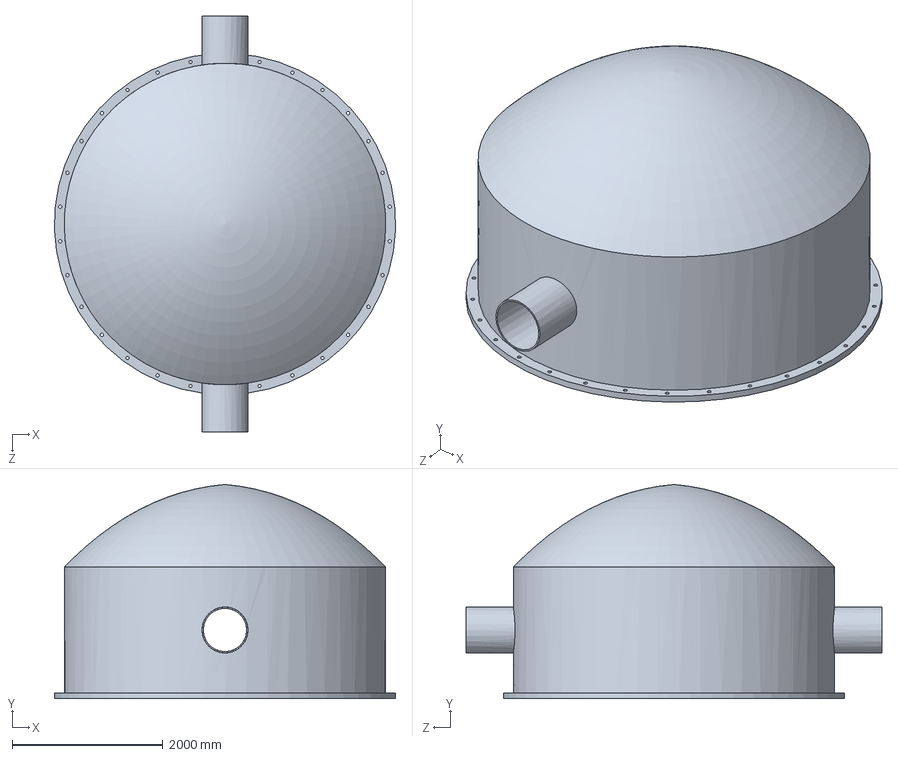
[picture p75: CAD file, 2025-09-01, last stored version]
static/images/3D/Трубчатые/5/berk_bombekesik.SLDPRT
4521.7 x 2837.4 x 5514.0 mm
