BonisOleg/adiabatic/static/images/3D/Нестандарт/4/finned tube he/65 nb class 150.SLDPRT

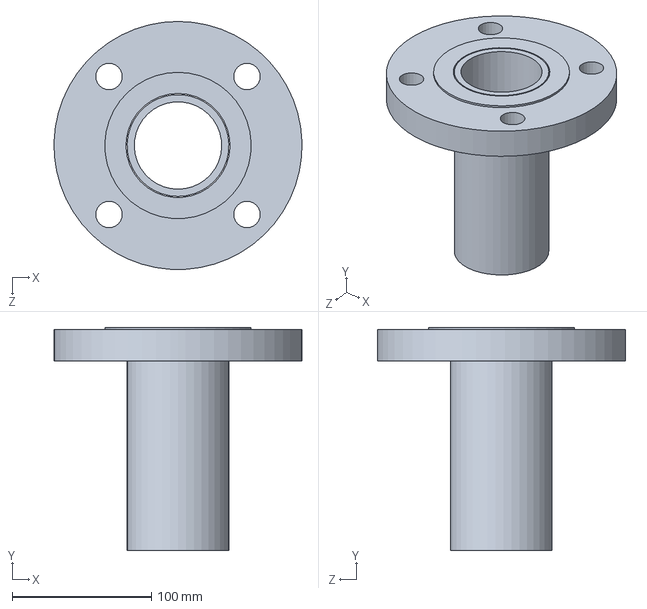
[picture p76: CAD file, 2025-09-01, last stored version]
static/images/3D/Нестандарт/4/finned tube he/65 nb class 150.SLDPRT
177.9 x 160.0 x 178.0 mm
