BonisOleg/adiabatic/static/images/3D/Трубчатые/11/Plate.SLDPRT

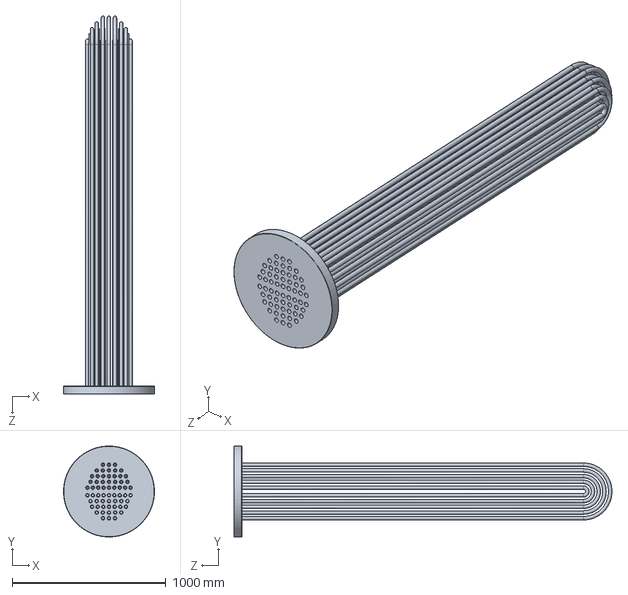
[picture p77: CAD file, 2025-09-01, last stored version]
static/images/3D/Трубчатые/11/Plate.SLDPRT
590.3 x 590.4 x 2456.1 mm
