BonisOleg/adiabatic/static/images/3D/Трубчатые/14/BONNET/BONNET CYLINDER Ø20 SCH 60 x 286.SLDPRT

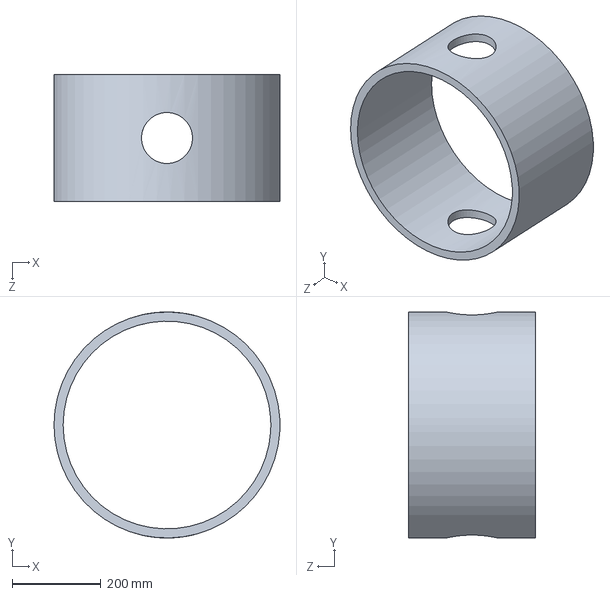
[picture p78: CAD file, 2025-09-01, last stored version]
static/images/3D/Трубчатые/14/BONNET/BONNET CYLINDER Ø20 SCH 60 x 286.SLDPRT
508.0 x 508.0 x 286.0 mm
