BonisOleg/adiabatic/static/images/3D/Трубчатые/14/STATIONARY TUBESHEET/BAFFLE.SLDPRT

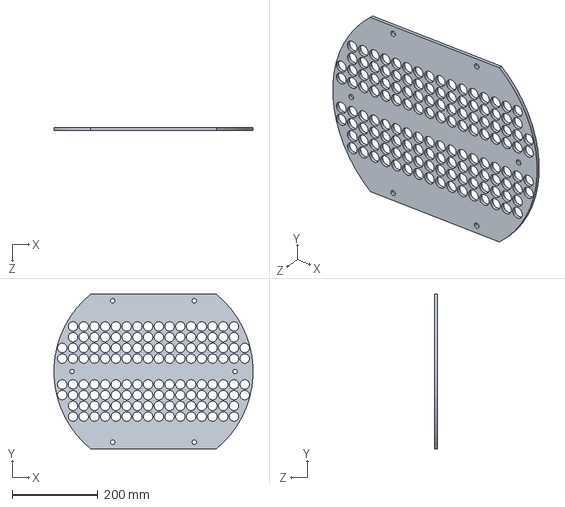
[picture p79: CAD file, 2025-09-01, last stored version]
static/images/3D/Трубчатые/14/STATIONARY TUBESHEET/BAFFLE.SLDPRT
463.4 x 360.0 x 6.35 mm
