BonisOleg/adiabatic/static/images/3D/Трубчатые/14/SUPPORT SADDLE FIX AND MOBILE DIAM 508/HEARTHING CONNECTOR.SLDPRT

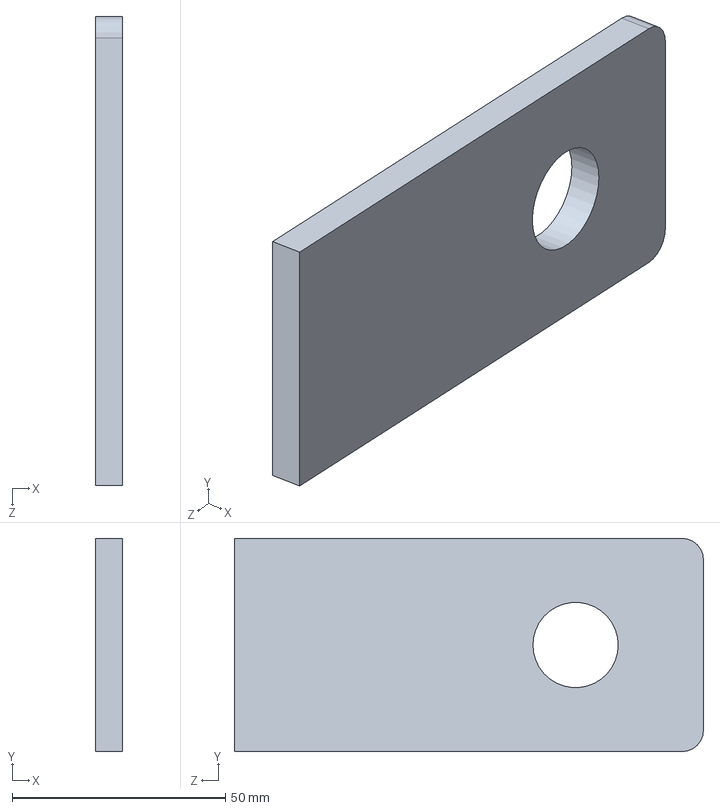
[picture p80: CAD file, 2025-09-01, last stored version]
static/images/3D/Трубчатые/14/SUPPORT SADDLE FIX AND MOBILE DIAM 508/HEARTHING CONNECTOR.SLDPRT
6.35 x 50.0 x 110.0 mm
