BonisOleg/adiabatic/static/images/3D/Трубчатые/15/Permutador e andaimes G.C/Suporteg.c..SLDPRT

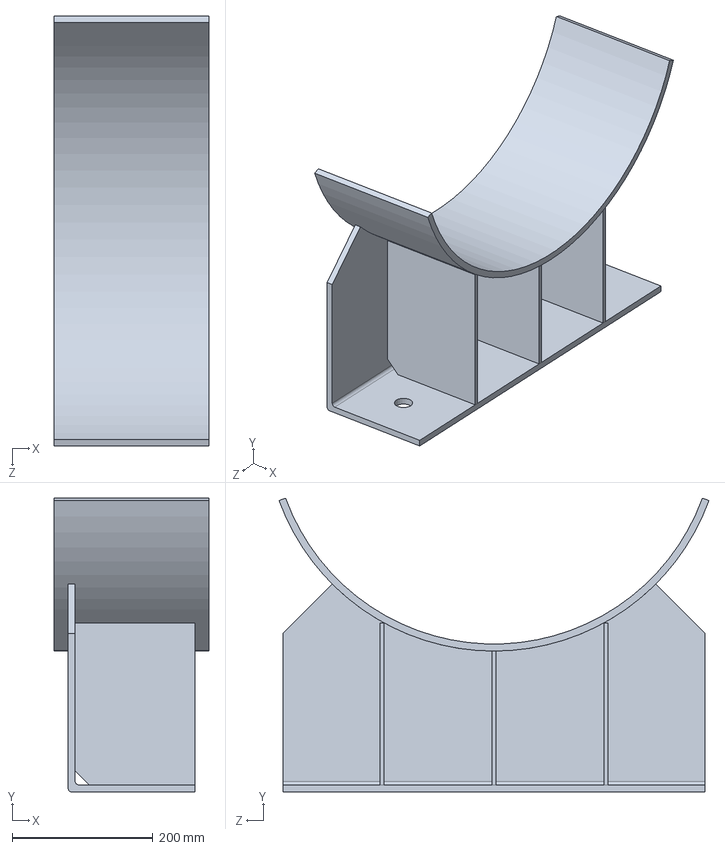
[picture p81: CAD file, 2025-09-01, last stored version]
static/images/3D/Трубчатые/15/Permutador e andaimes G.C/Suporteg.c..SLDPRT
220.0 x 417.3 x 610.8 mm
