BonisOleg/adiabatic/static/images/3D/Трубчатые/3/Pipe 18.5in-14in.SLDPRT

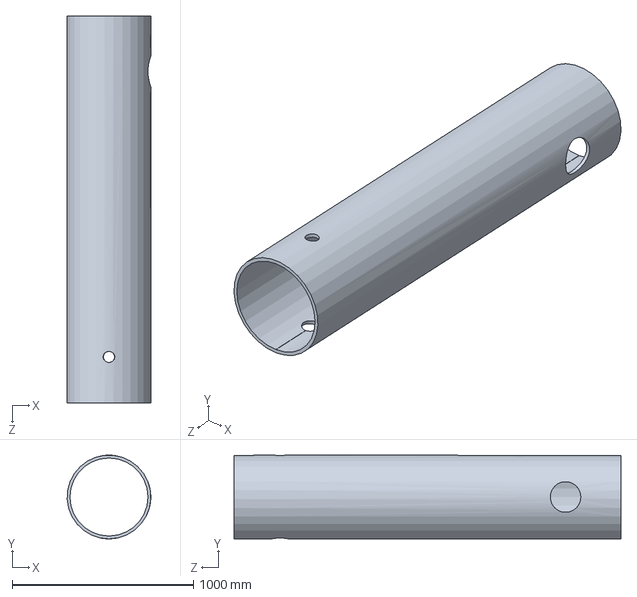
[picture p82: CAD file, 2025-09-01, last stored version]
static/images/3D/Трубчатые/3/Pipe 18.5in-14in.SLDPRT
461.5 x 461.8 x 2133.6 mm
