BonisOleg/adiabatic/static/images/3D/Трубчатые/5/berk_gövde.SLDPRT

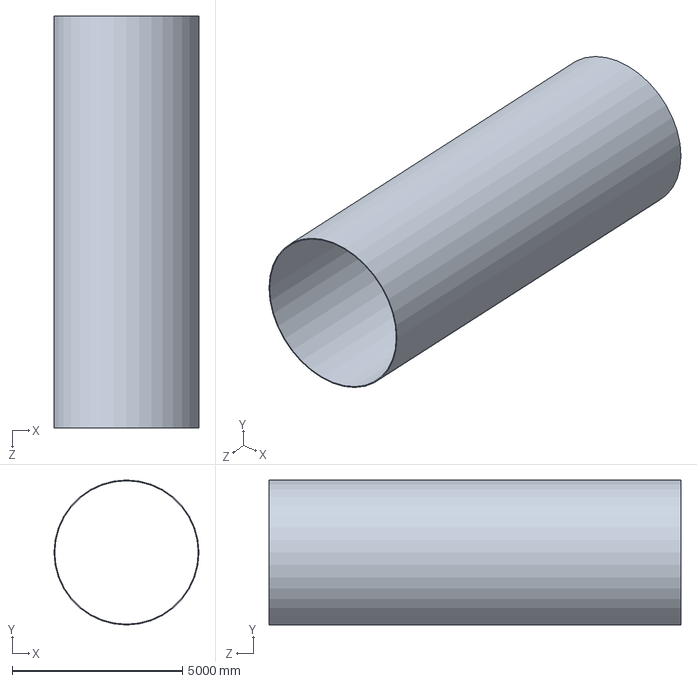
[picture p83: CAD file, 2025-09-01, last stored version]
static/images/3D/Трубчатые/5/berk_gövde.SLDPRT
4260.0 x 4260.0 x 12100.0 mm
