BonisOleg/adiabatic/static/images/3D/Нестандарт/4/finned tube he/finned tubes.SLDPRT

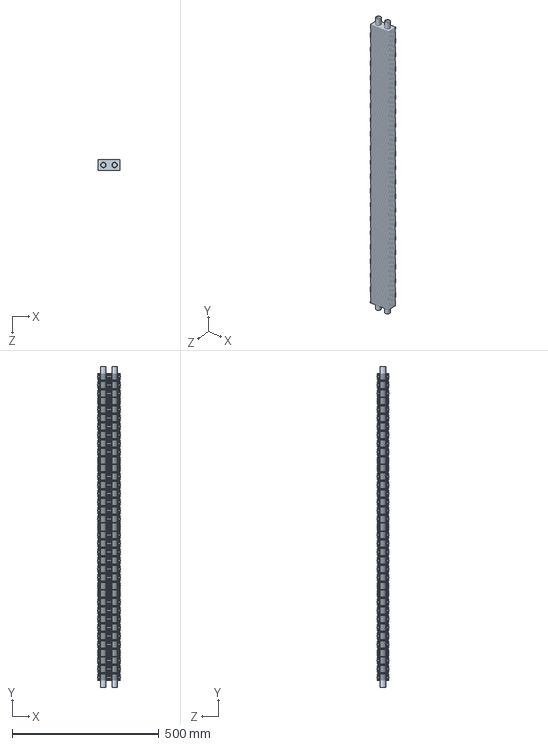
[picture p84: CAD file, 2025-09-01, last stored version]
static/images/3D/Нестандарт/4/finned tube he/finned tubes.SLDPRT
76.0 x 1095.0 x 38.0 mm
