BonisOleg/adiabatic/static/images/3D/Трубчатые/11/PLAT ROD.SLDPRT

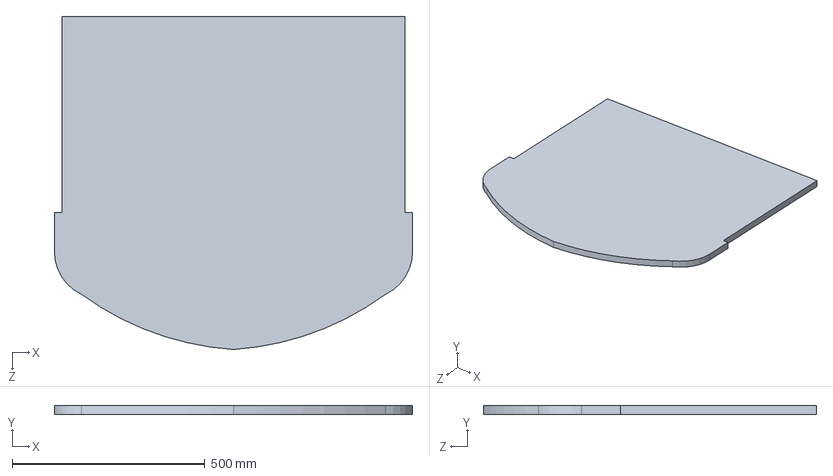
[picture p85: CAD file, 2025-09-01, last stored version]
static/images/3D/Трубчатые/11/PLAT ROD.SLDPRT
928.5 x 22.9 x 863.0 mm
