BonisOleg/adiabatic/static/images/3D/Трубчатые/14/SHELL/LIFITING LUG PLATE.SLDPRT

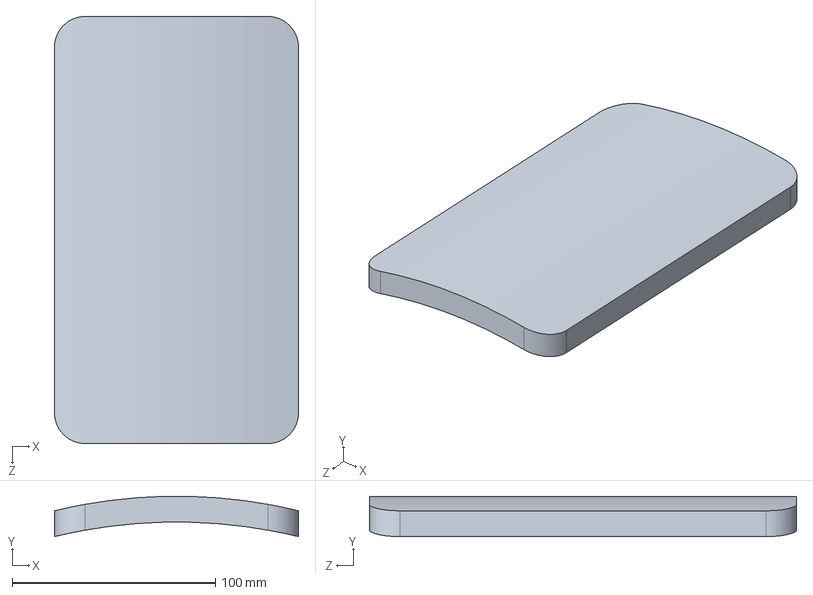
[picture p86: CAD file, 2025-09-01, last stored version]
static/images/3D/Трубчатые/14/SHELL/LIFITING LUG PLATE.SLDPRT
120.0 x 19.8 x 210.0 mm
