BonisOleg/adiabatic/static/images/3D/Трубчатые/14/STATIONARY TUBESHEET/SPACER TUBE DIAM. 3l8  SCH 80 x 653.SLDPRT

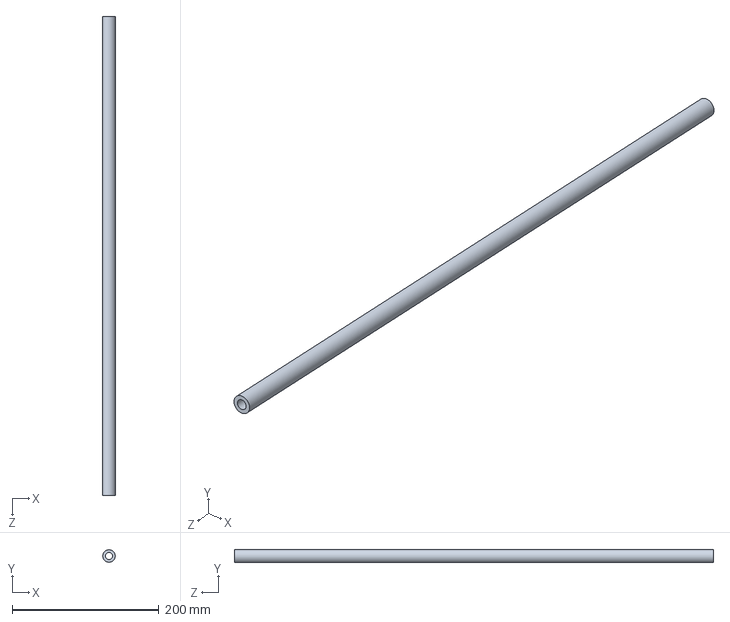
[picture p87: CAD file, 2025-09-01, last stored version]
static/images/3D/Трубчатые/14/STATIONARY TUBESHEET/SPACER TUBE DIAM. 3l8 SCH 80 x 653.SLDPRT
17.1 x 17.1 x 653.2 mm
