BonisOleg/adiabatic/static/images/3D/Трубчатые/14/SUPPORT SADDLE FIX AND MOBILE DIAM 508/PLATE 125 X 380 X 12,7.SLDPRT

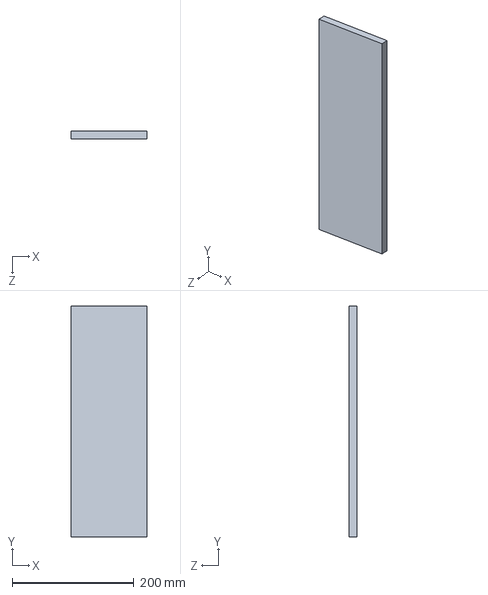
[picture p88: CAD file, 2025-09-01, last stored version]
static/images/3D/Трубчатые/14/SUPPORT SADDLE FIX AND MOBILE DIAM 508/PLATE 125 X 380 X 12,7.SLDPRT
125.0 x 380.0 x 12.7 mm
