BonisOleg/adiabatic/static/images/3D/Трубчатые/3/Flange 3in.SLDPRT

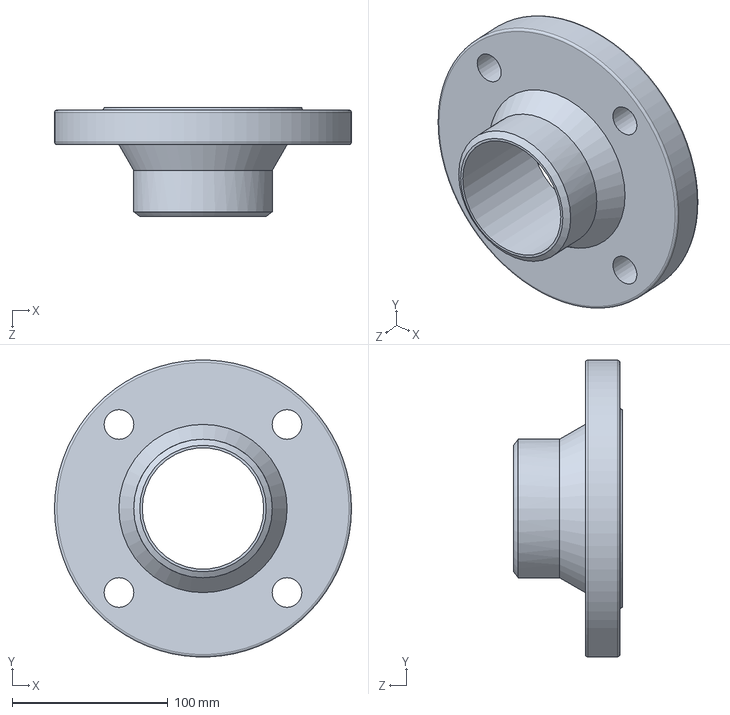
[picture p90: CAD file, 2025-09-01, last stored version]
static/images/3D/Трубчатые/3/Flange 3in.SLDPRT
190.5 x 190.3 x 69.8 mm
