BonisOleg/adiabatic/static/images/3D/Нестандарт/4/finned tube he/air shell.SLDPRT

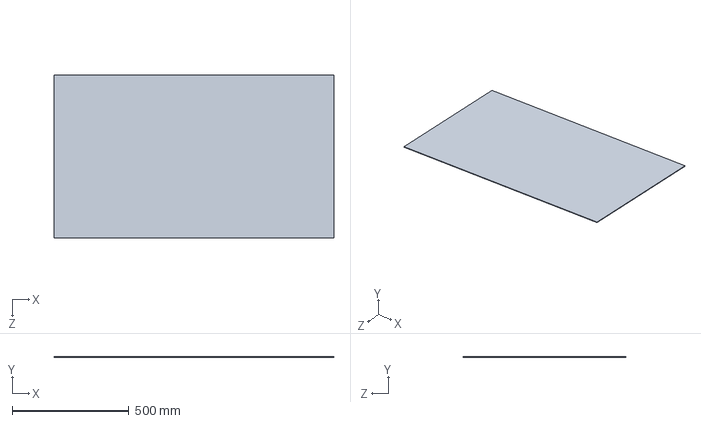
[picture p91: CAD file, 2025-09-01, last stored version]
static/images/3D/Нестандарт/4/finned tube he/air shell.SLDPRT
1200.0 x 3.00 x 700.0 mm
