BonisOleg/adiabatic/static/images/3D/Трубчатые/11/double baffle p1.SLDPRT

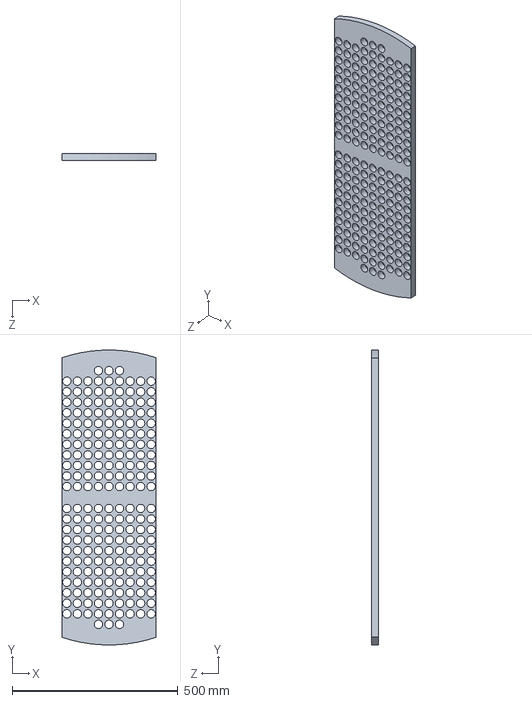
[picture p92: CAD file, 2025-09-01, last stored version]
static/images/3D/Трубчатые/11/double baffle p1.SLDPRT
284.5 x 889.0 x 20.3 mm
