BonisOleg/adiabatic/static/images/3D/Трубчатые/14/SHELL/SHELL TUBE DIAM 20 Pol SCH60 x 2250.SLDPRT

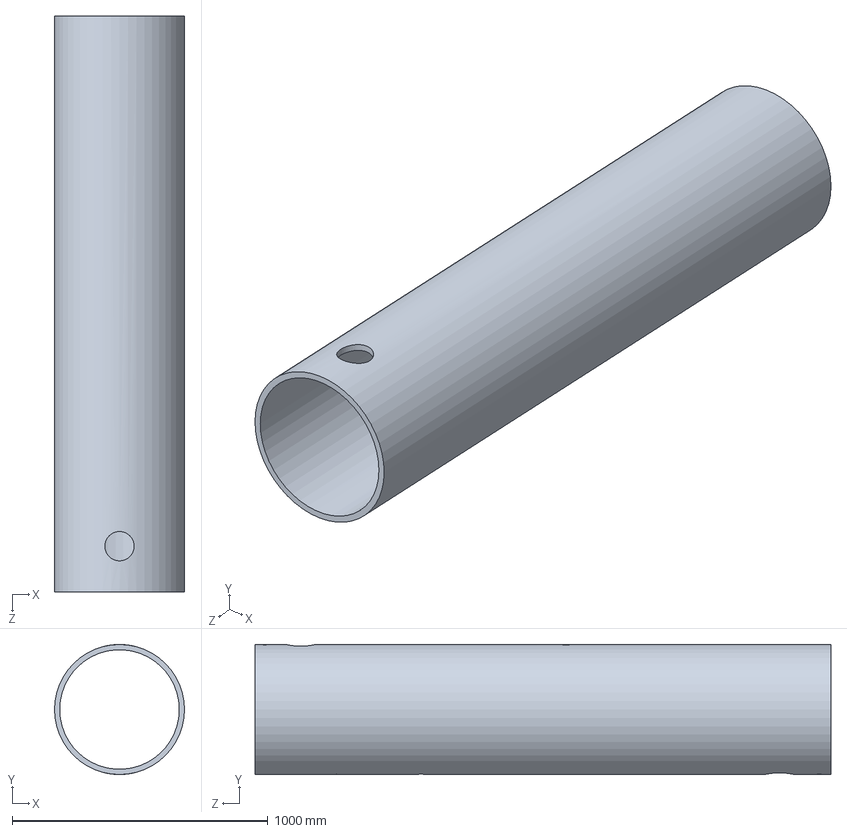
[picture p93: CAD file, 2025-09-01, last stored version]
static/images/3D/Трубчатые/14/SHELL/SHELL TUBE DIAM 20 Pol SCH60 x 2250.SLDPRT
508.0 x 508.0 x 2250.0 mm
