BonisOleg/adiabatic/static/images/3D/Трубчатые/14/STATIONARY TUBESHEET/TIE ROD DIAM 25 X 1276.SLDPRT

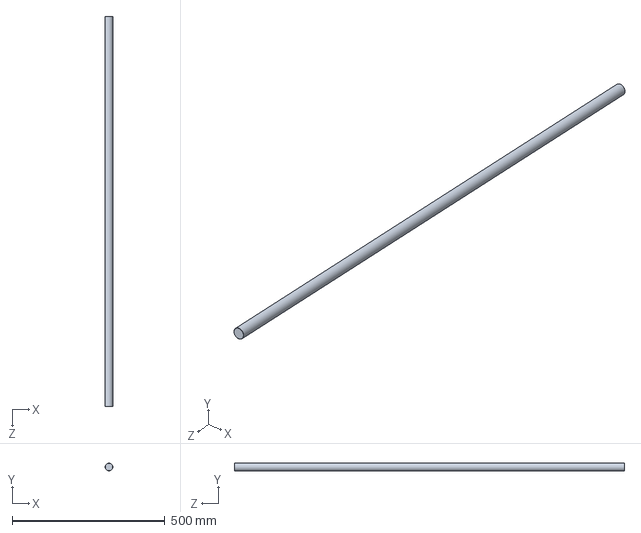
[picture p94: CAD file, 2025-09-01, last stored version]
static/images/3D/Трубчатые/14/STATIONARY TUBESHEET/TIE ROD DIAM 25 X 1276.SLDPRT
25.4 x 25.4 x 1276.0 mm
