BonisOleg/adiabatic/static/images/3D/Трубчатые/15/Permutador e andaimes G.C/Casco.SLDPRT

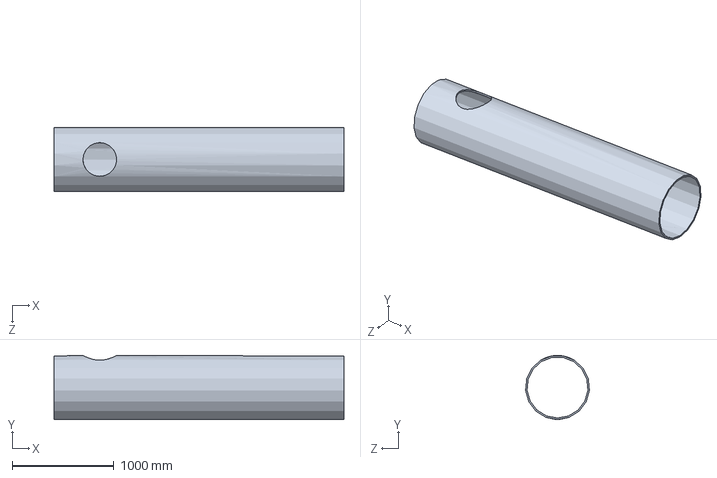
[picture p95: CAD file, 2025-09-01, last stored version]
static/images/3D/Трубчатые/15/Permutador e andaimes G.C/Casco.SLDPRT
2850.0 x 630.0 x 627.3 mm
