BonisOleg/adiabatic/static/images/3D/Трубчатые/3/Support Stand.SLDPRT

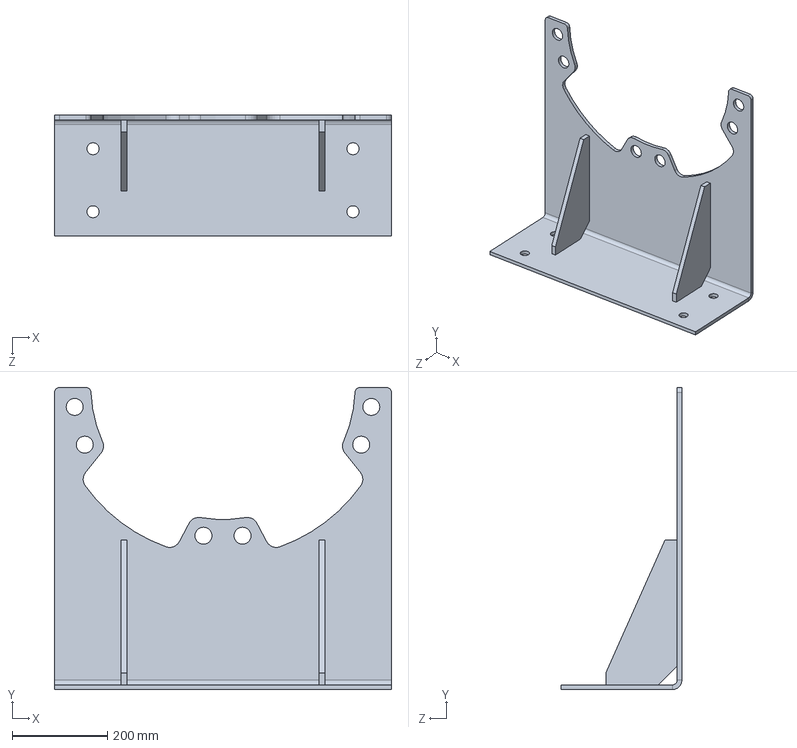
[picture p96: CAD file, 2025-09-01, last stored version]
static/images/3D/Трубчатые/3/Support Stand.SLDPRT
708.0 x 635.0 x 254.0 mm
