BonisOleg/adiabatic/static/images/3D/Трубчатые/15/Permutador e andaimes G.C/Espelho fixog.c..SLDPRT

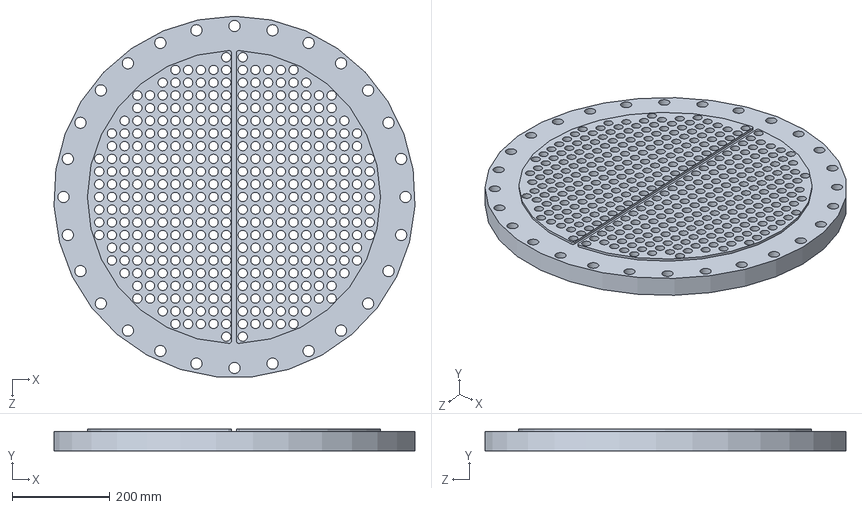
[picture p97: CAD file, 2025-09-01, last stored version]
static/images/3D/Трубчатые/15/Permutador e andaimes G.C/Espelho fixog.c..SLDPRT
739.1 x 45.0 x 738.1 mm
