BonisOleg/adiabatic/static/images/3D/Трубчатые/3/Pipe 6in.SLDPRT

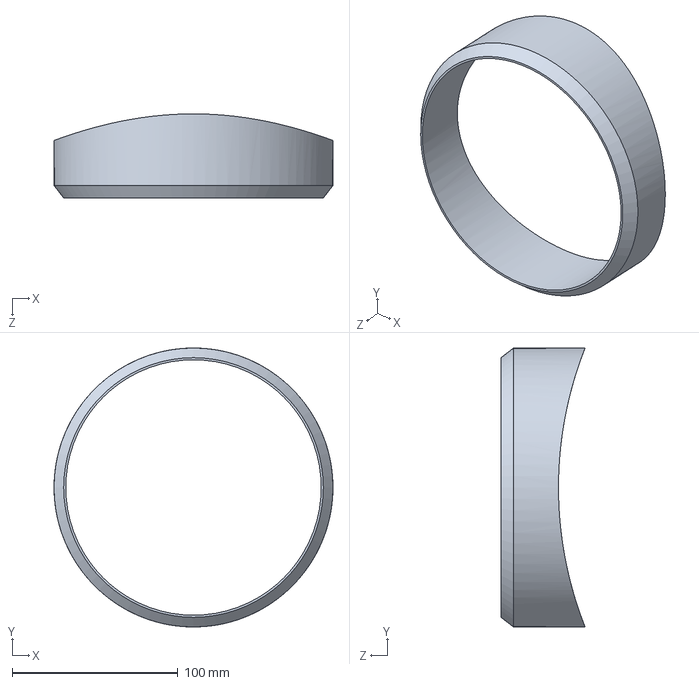
[picture p98: CAD file, 2025-09-01, last stored version]
static/images/3D/Трубчатые/3/Pipe 6in.SLDPRT
168.3 x 168.3 x 50.8 mm
