BonisOleg/adiabatic/static/images/3D/Нестандарт/4/finned tube he/air outlet flange.SLDPRT

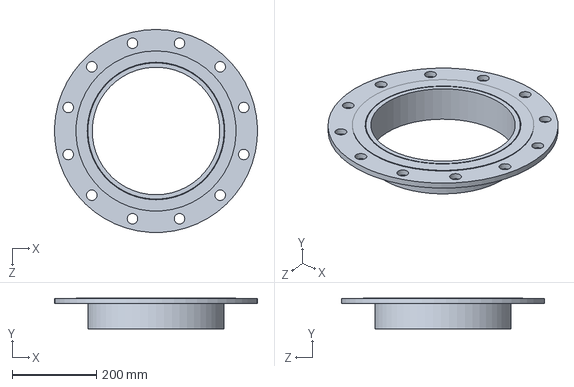
[picture p99: CAD file, 2025-09-01, last stored version]
static/images/3D/Нестандарт/4/finned tube he/air outlet flange.SLDPRT
482.8 x 73.5 x 483.0 mm
