BonisOleg/adiabatic/static/images/3D/Трубчатые/11/TATIONARY HEAD CHANEL.SLDPRT

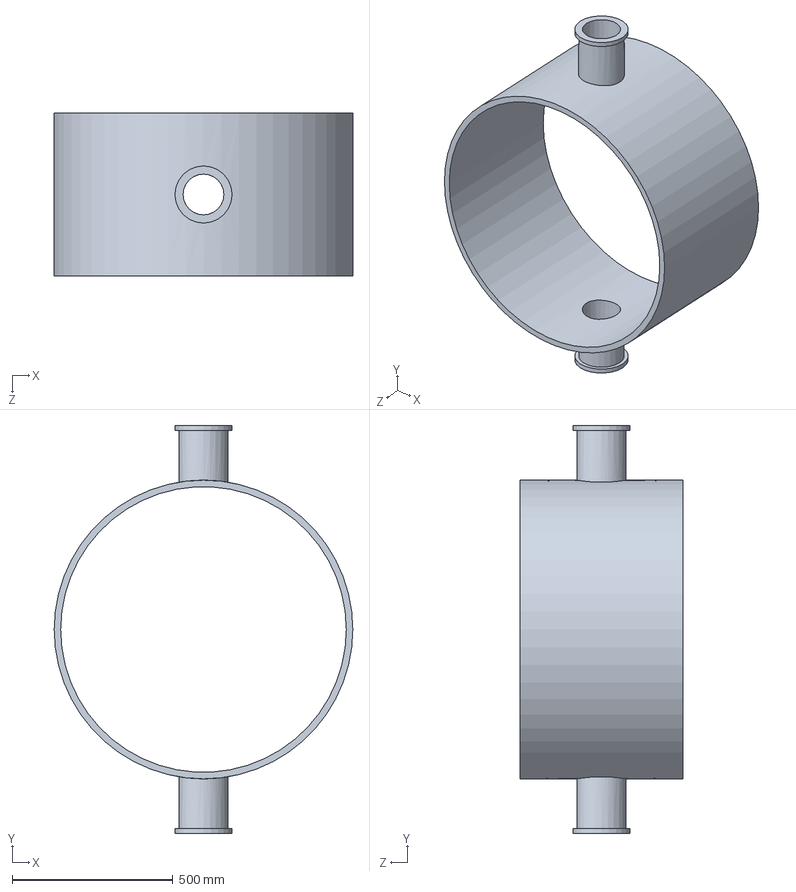
[picture p100: CAD file, 2025-09-01, last stored version]
static/images/3D/Трубчатые/11/TATIONARY HEAD CHANEL.SLDPRT
929.6 x 1270.0 x 508.0 mm
