BonisOleg/adiabatic/static/images/3D/Трубчатые/14/STATIONARY TUBESHEET/TUBE DIAM. 0.5 SCH 80 X 4923.SLDPRT

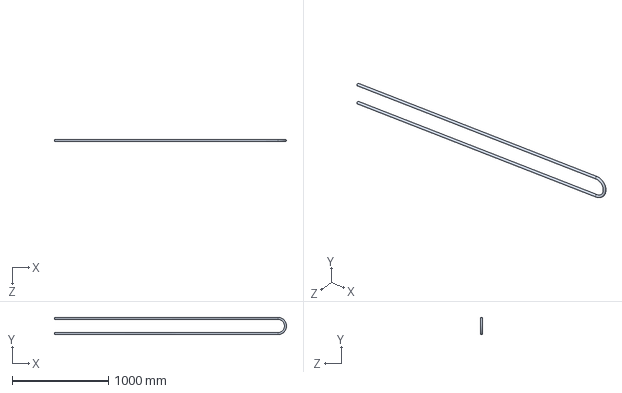
[picture p101: CAD file, 2025-09-01, last stored version]
static/images/3D/Трубчатые/14/STATIONARY TUBESHEET/TUBE DIAM. 0.5 SCH 80 X 4923.SLDPRT
2415.6 x 181.3 x 21.3 mm
