BonisOleg/adiabatic/static/images/3D/Трубчатые/15/Permutador e andaimes G.C/Фланец I 250-6 ГОСТ12831-67g.c..SLDPRT

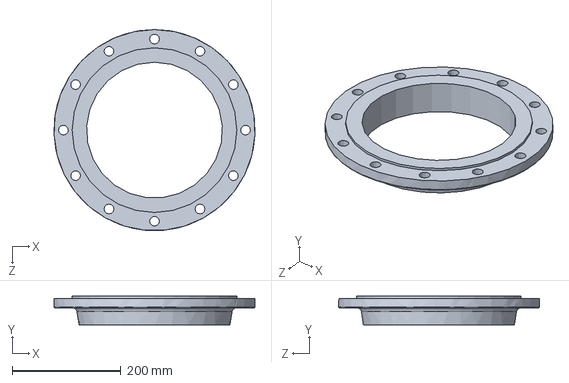
[picture p102: CAD file, 2025-09-01, last stored version]
static/images/3D/Трубчатые/15/Permutador e andaimes G.C/Фланец I 250-6 ГОСТ12831-67g.c..SLDPRT
369.8 x 53.0 x 369.5 mm
