BonisOleg/adiabatic/static/images/3D/Трубчатые/3/Threaded Rod.SLDPRT

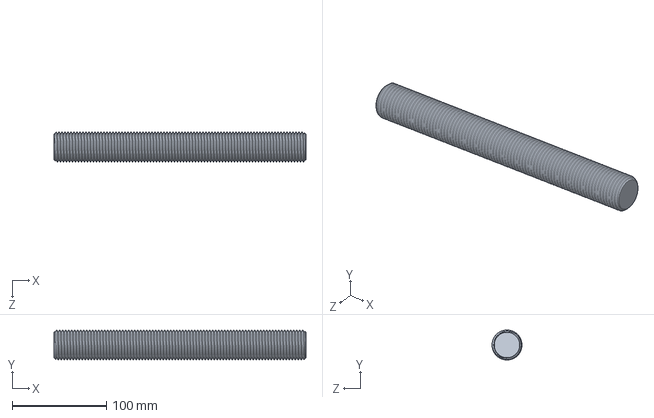
[picture p103: CAD file, 2025-09-01, last stored version]
static/images/3D/Трубчатые/3/Threaded Rod.SLDPRT
266.7 x 31.8 x 31.8 mm
