BonisOleg/adiabatic/static/images/3D/Нестандарт/4/finned tube he/drain 15bsp.SLDPRT

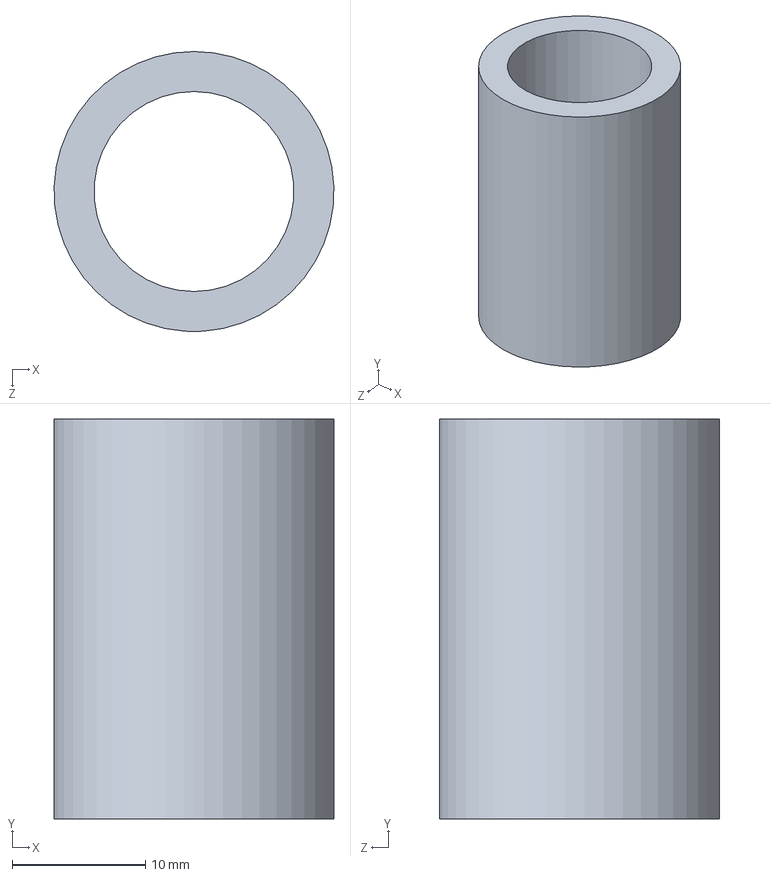
[picture p104: CAD file, 2025-09-01, last stored version]
static/images/3D/Нестандарт/4/finned tube he/drain 15bsp.SLDPRT
21.0 x 30.0 x 21.0 mm
