BonisOleg/adiabatic/static/images/3D/Трубчатые/11/double baffle t.SLDPRT

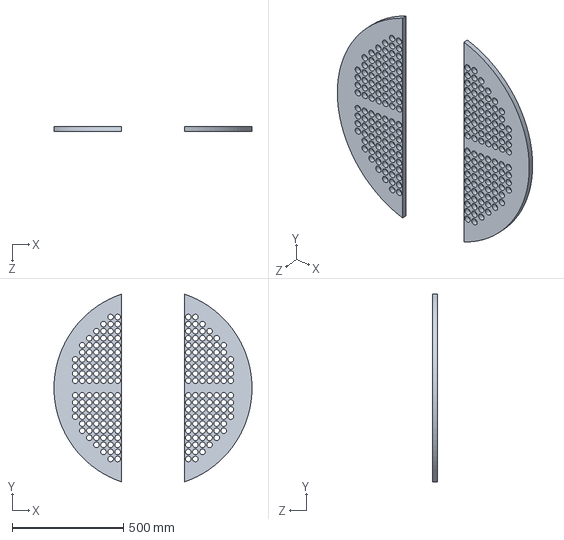
[picture p105: CAD file, 2025-09-01, last stored version]
static/images/3D/Трубчатые/11/double baffle t.SLDPRT
889.0 x 842.3 x 20.3 mm
