BonisOleg/adiabatic/static/images/3D/Трубчатые/14/STATIONARY TUBESHEET/TUBE DIAM 0.5 SCH 80 X 4766.SLDPRT

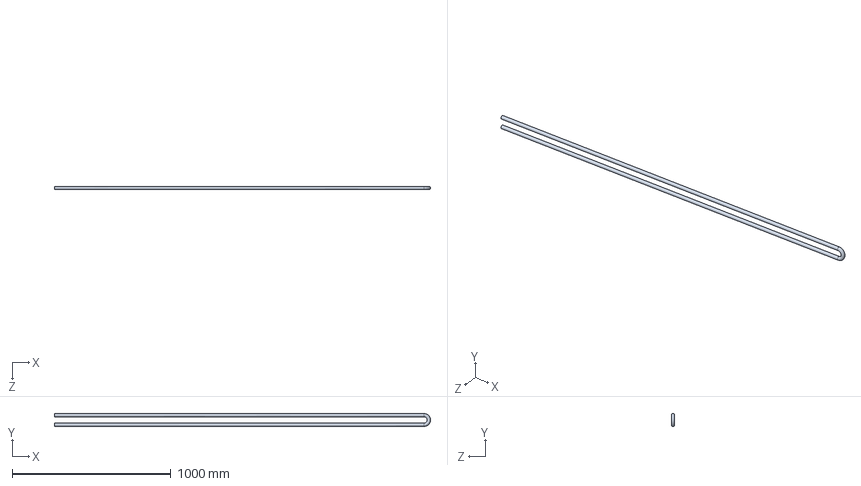
[picture p106: CAD file, 2025-09-01, last stored version]
static/images/3D/Трубчатые/14/STATIONARY TUBESHEET/TUBE DIAM 0.5 SCH 80 X 4766.SLDPRT
2365.6 x 81.3 x 21.3 mm
