BonisOleg/adiabatic/static/images/3D/Трубчатые/11/baffle.SLDPRT

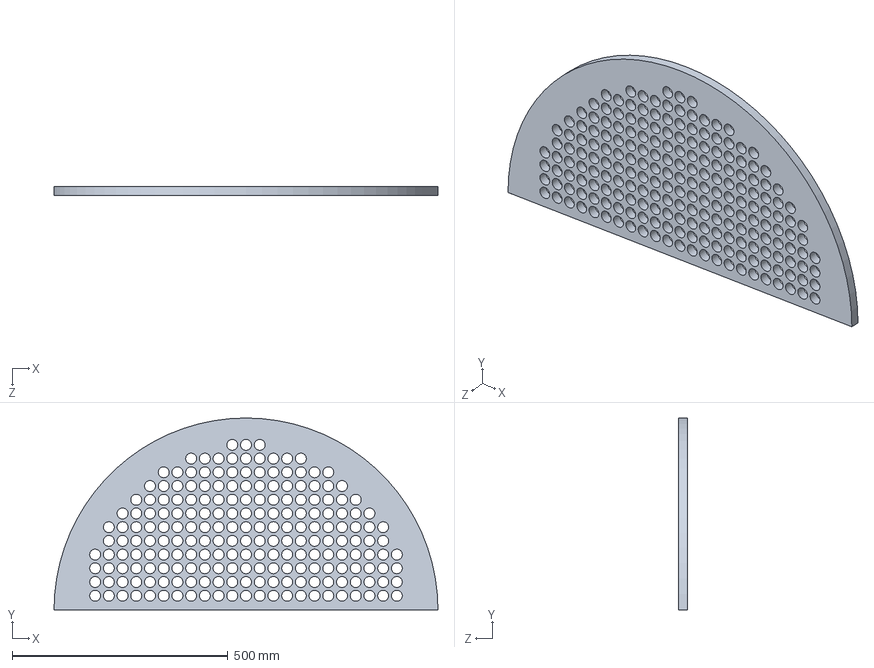
[picture p107: CAD file, 2025-09-01, last stored version]
static/images/3D/Трубчатые/11/baffle.SLDPRT
889.0 x 444.5 x 20.3 mm
