BonisOleg/adiabatic/static/images/3D/Трубчатые/14/SHELL/BONNET LIFTING LUG.SLDPRT

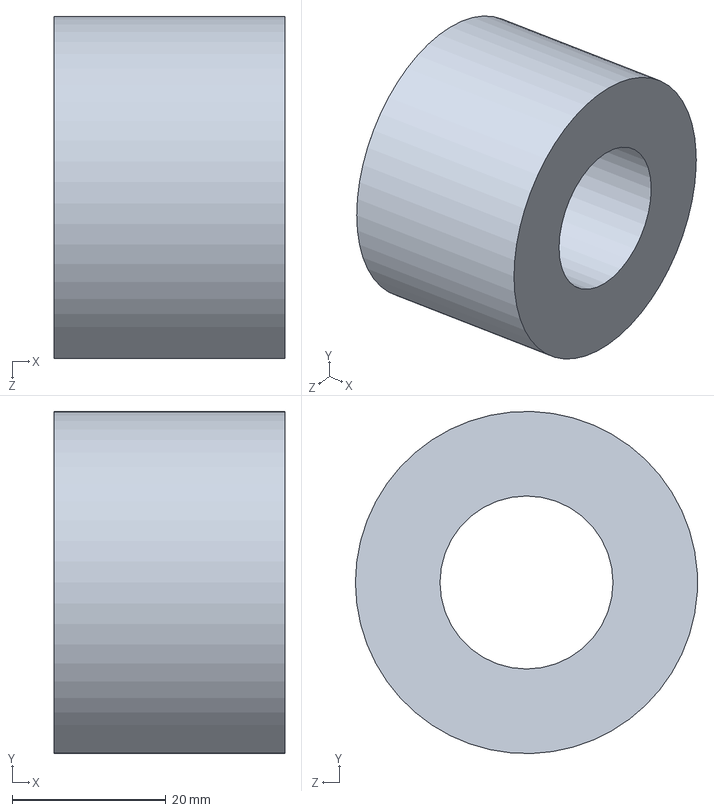
[picture p108: CAD file, 2025-09-01, last stored version]
static/images/3D/Трубчатые/14/SHELL/BONNET LIFTING LUG.SLDPRT
30.0 x 44.5 x 44.5 mm
