BonisOleg/adiabatic/static/images/3D/Трубчатые/14/STATIONARY TUBESHEET/TUBESHEET.SLDPRT

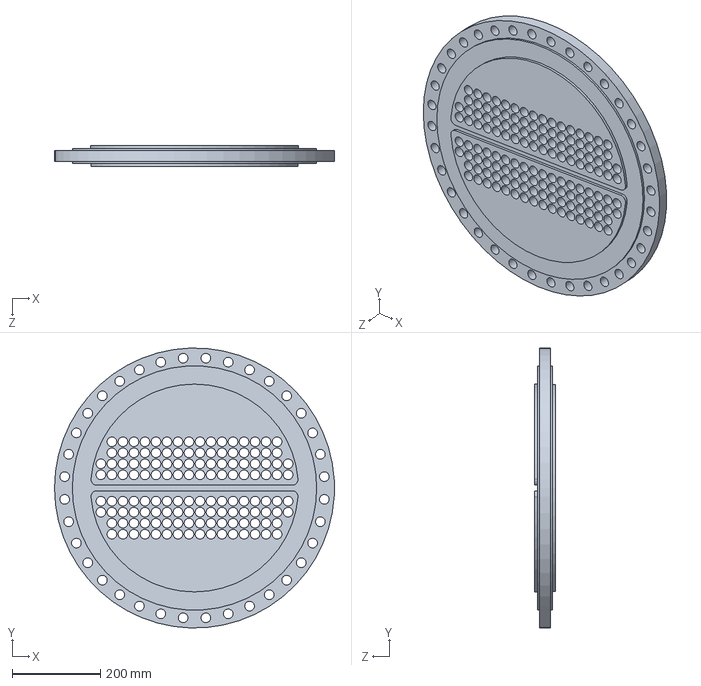
[picture p109: CAD file, 2025-09-01, last stored version]
static/images/3D/Трубчатые/14/STATIONARY TUBESHEET/TUBESHEET.SLDPRT
636.0 x 635.7 x 47.0 mm
