BonisOleg/adiabatic/static/images/3D/Трубчатые/15/Permutador e andaimes G.C/Saida carretel inferiorg.c..sldprt

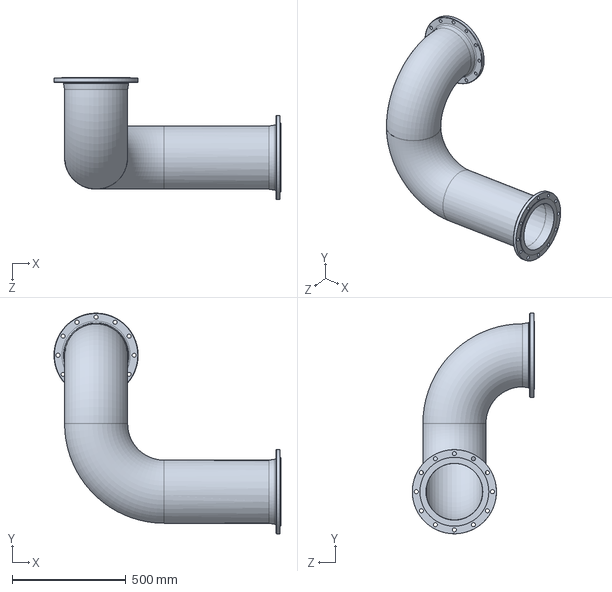
[picture p110: CAD file, 2025-09-01, last stored version]
static/images/3D/Трубчатые/15/Permutador e andaimes G.C/Saida carretel inferiorg.c..sldprt
998.0 x 969.8 x 537.8 mm
