BonisOleg/adiabatic/static/images/3D/Трубчатые/3/Pipe 2in.SLDPRT

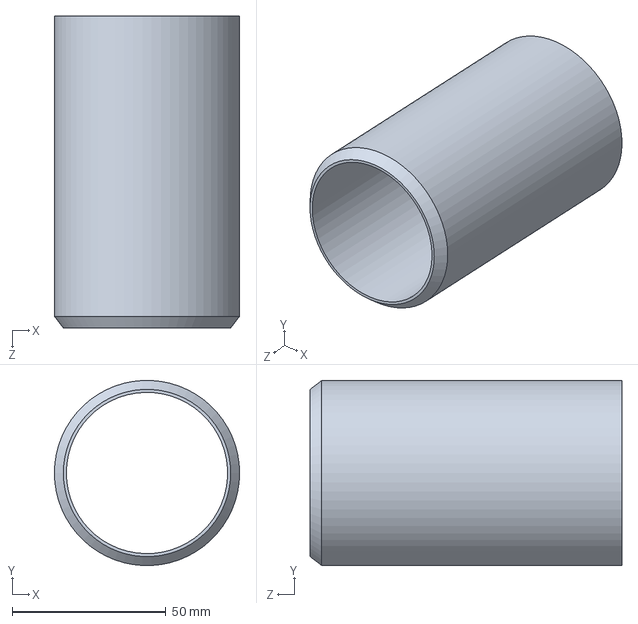
[picture p111: CAD file, 2025-09-01, last stored version]
static/images/3D/Трубчатые/3/Pipe 2in.SLDPRT
60.3 x 60.2 x 101.6 mm
