BonisOleg/adiabatic/static/images/3D/Трубчатые/14/STATIONARY TUBESHEET/TIE ROD THREAD 3 8 X 2280.SLDPRT

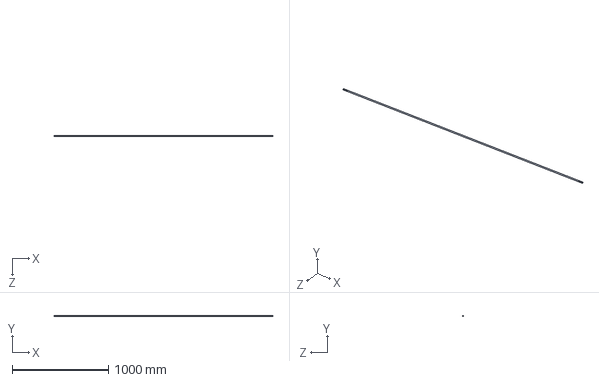
[picture p112: CAD file, 2025-09-01, last stored version]
static/images/3D/Трубчатые/14/STATIONARY TUBESHEET/TIE ROD THREAD 3 8 X 2280.SLDPRT
2280.0 x 9.53 x 9.53 mm
