BonisOleg/adiabatic/static/images/3D/Трубчатые/15/Permutador e andaimes G.C/Flange casco.SLDPRT

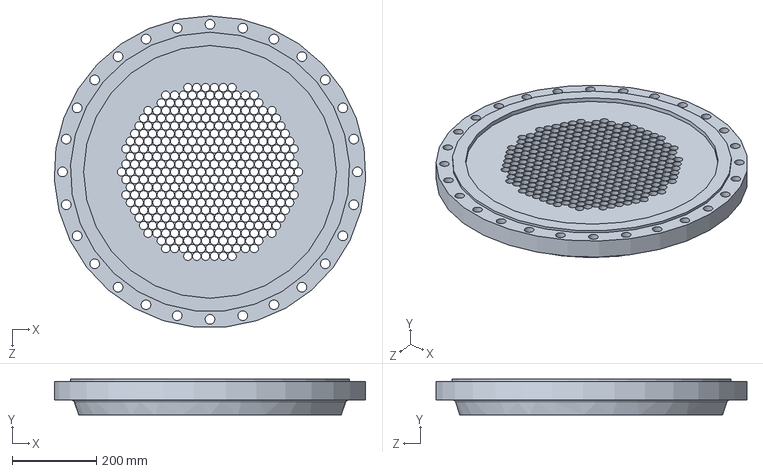
[picture p113: CAD file, 2025-09-01, last stored version]
static/images/3D/Трубчатые/15/Permutador e andaimes G.C/Flange casco.SLDPRT
739.1 x 85.0 x 738.1 mm
