BonisOleg/adiabatic/static/images/3D/Трубчатые/3/Flange 2in.SLDPRT

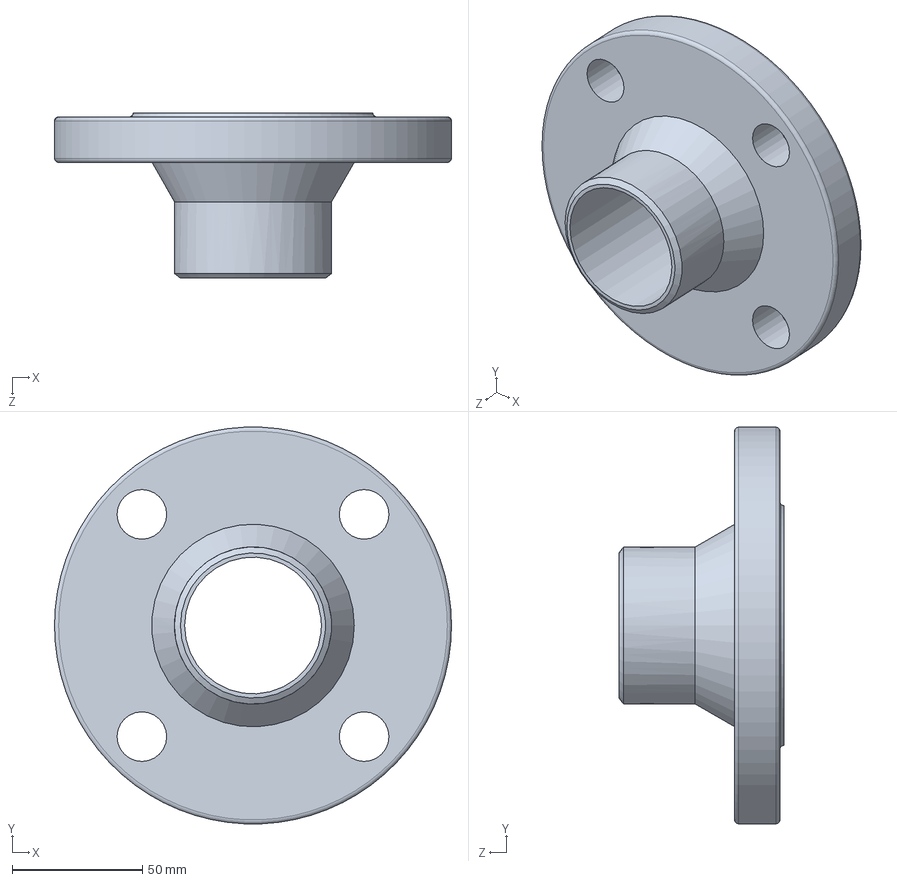
[picture p114: CAD file, 2025-09-01, last stored version]
static/images/3D/Трубчатые/3/Flange 2in.SLDPRT
152.4 x 152.3 x 63.5 mm
