BonisOleg/adiabatic/static/images/3D/Трубчатые/15/Permutador e andaimes G.C/Degrau com guarda corpo (arco fechado)g.c..SLDPRT

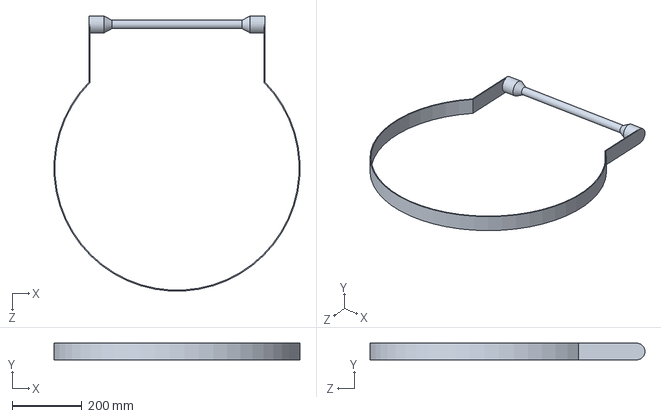
[picture p115: CAD file, 2025-09-01, last stored version]
static/images/3D/Трубчатые/15/Permutador e andaimes G.C/Degrau com guarda corpo (arco fechado)g.c..SLDPRT
705.1 x 48.2 x 788.6 mm
