BonisOleg/adiabatic/static/images/3D/Трубчатые/14/STATIONARY TUBESHEET/ESTOJO ANSI B16_5 - ROSCA CLASSE UN-2A - Ø 3_4.SLDPRT

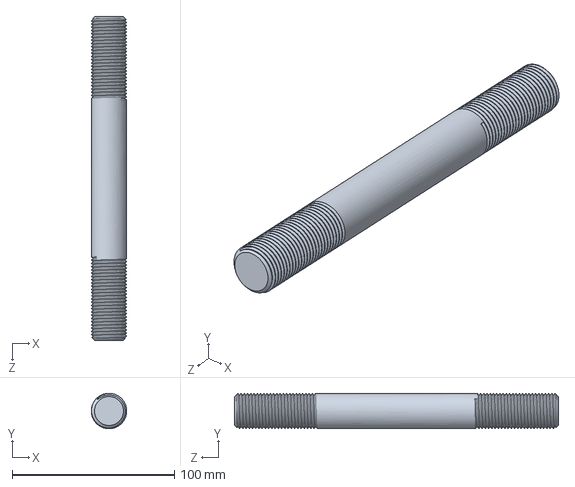
[picture p116: CAD file, 2025-09-01, last stored version]
static/images/3D/Трубчатые/14/STATIONARY TUBESHEET/ESTOJO ANSI B16_5 - ROSCA CLASSE UN-2A - Ø 3_4.SLDPRT
21.9 x 21.9 x 200.0 mm
