BonisOleg/adiabatic/static/images/3D/Трубчатые/15/Permutador e andaimes G.C/Boleadog.c..SLDPRT

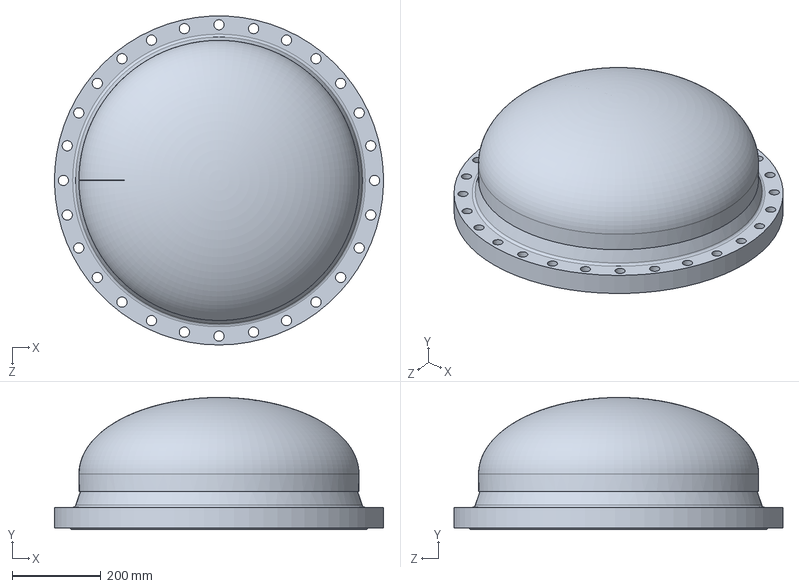
[picture p117: CAD file, 2025-09-01, last stored version]
static/images/3D/Трубчатые/15/Permutador e andaimes G.C/Boleadog.c..SLDPRT
739.8 x 297.0 x 739.6 mm
