BonisOleg/adiabatic/static/images/3D/Трубчатые/3/Plate Rod.SLDPRT

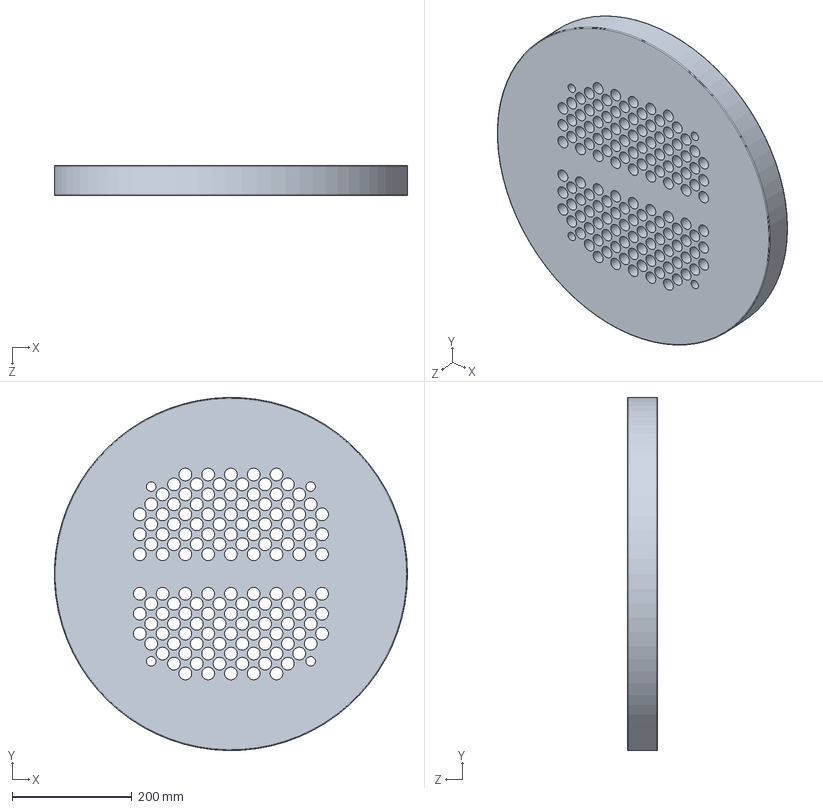
[picture p118: CAD file, 2025-09-01, last stored version]
static/images/3D/Трубчатые/3/Plate Rod.SLDPRT
590.3 x 590.4 x 50.8 mm
