BonisOleg/adiabatic/static/images/3D/Нестандарт/4/finned tube he/loop flange.SLDPRT

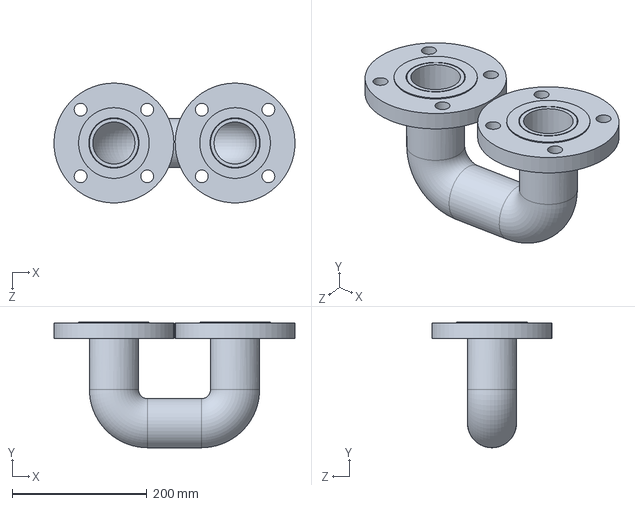
[picture p119: CAD file, 2025-09-01, last stored version]
static/images/3D/Нестандарт/4/finned tube he/loop flange.SLDPRT
357.9 x 186.5 x 178.0 mm
