BonisOleg/adiabatic/static/images/3D/Трубчатые/15/Permutador e andaimes G.C/Base fixag.c..SLDPRT

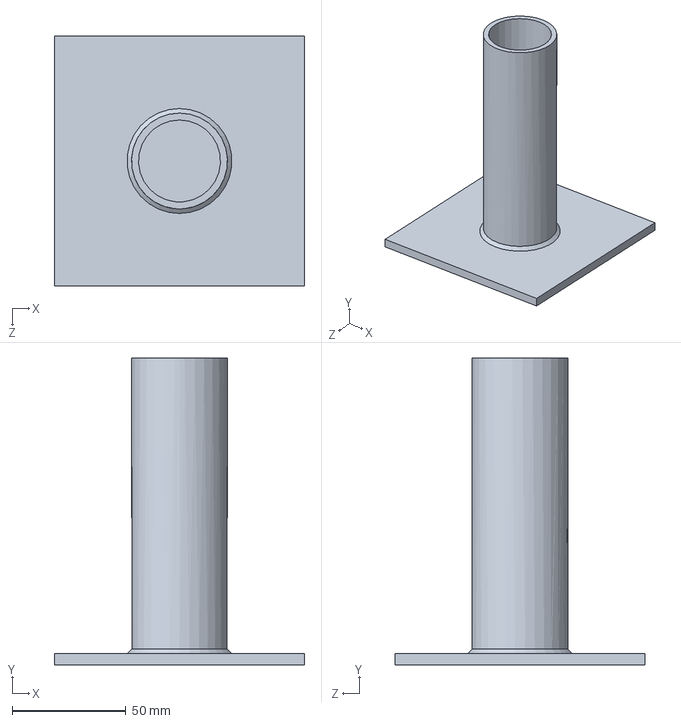
[picture p121: CAD file, 2025-09-01, last stored version]
static/images/3D/Трубчатые/15/Permutador e andaimes G.C/Base fixag.c..SLDPRT
110.0 x 135.0 x 110.0 mm
