BonisOleg/adiabatic/static/images/3D/Трубчатые/3/Plate Rod Center.SLDPRT

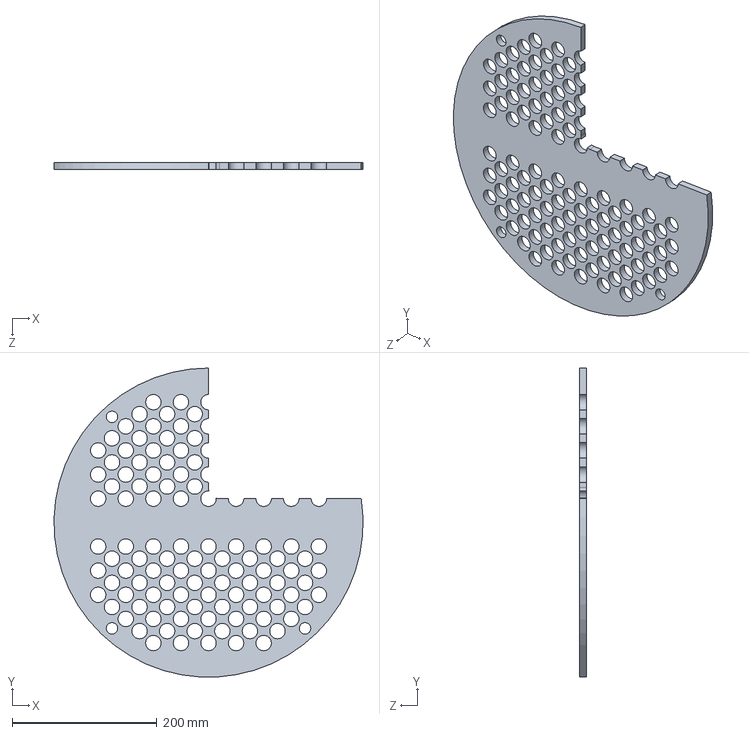
[picture p122: CAD file, 2025-09-01, last stored version]
static/images/3D/Трубчатые/3/Plate Rod Center.SLDPRT
426.8 x 426.7 x 9.53 mm
