BonisOleg/adiabatic/static/images/3D/Нестандарт/4/finned tube he/cone.SLDPRT

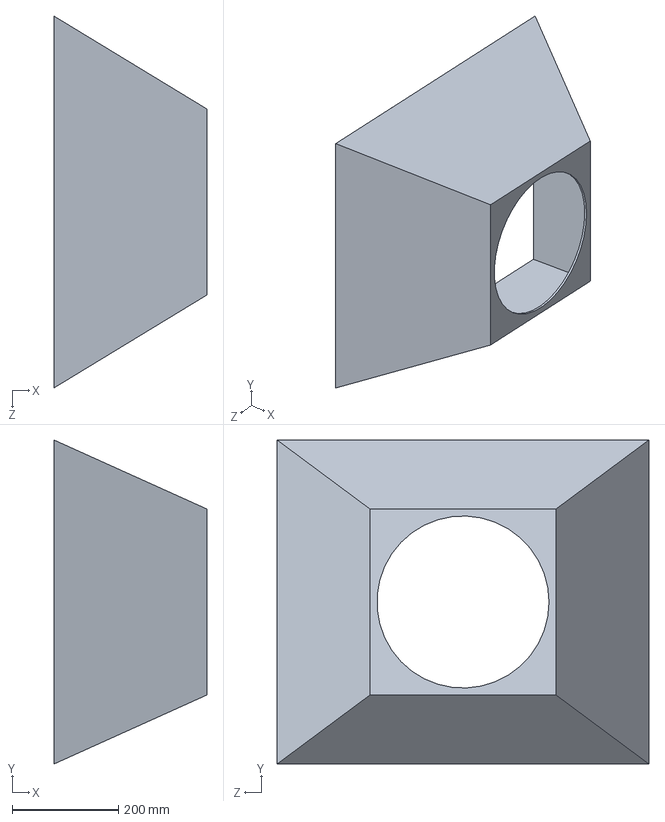
[picture p123: CAD file, 2025-09-01, last stored version]
static/images/3D/Нестандарт/4/finned tube he/cone.SLDPRT
288.0 x 610.0 x 700.0 mm
