BonisOleg/adiabatic/static/images/3D/Трубчатые/15/Permutador e andaimes G.C/Gate valve DN 100 PN 1,6 MPa (MZTA)g.c..SLDPRT

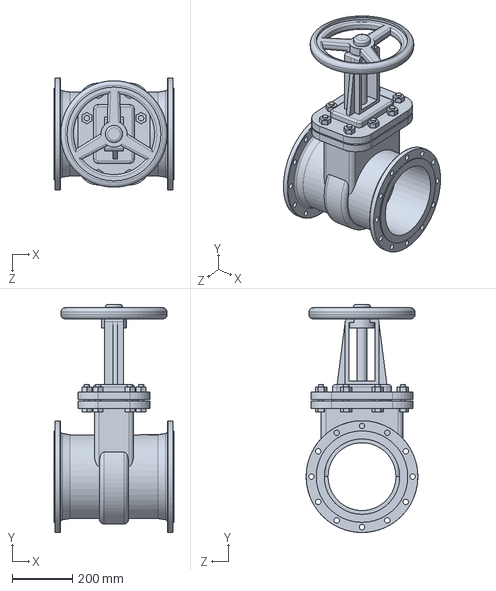
[picture p124: CAD file, 2025-09-01, last stored version]
static/images/3D/Трубчатые/15/Permutador e andaimes G.C/Gate valve DN 100 PN 1,6 MPa (MZTA)g.c..SLDPRT
397.3 x 755.0 x 370.0 mm
