BonisOleg/adiabatic/static/images/3D/Трубчатые/3/Flange 18in.SLDPRT

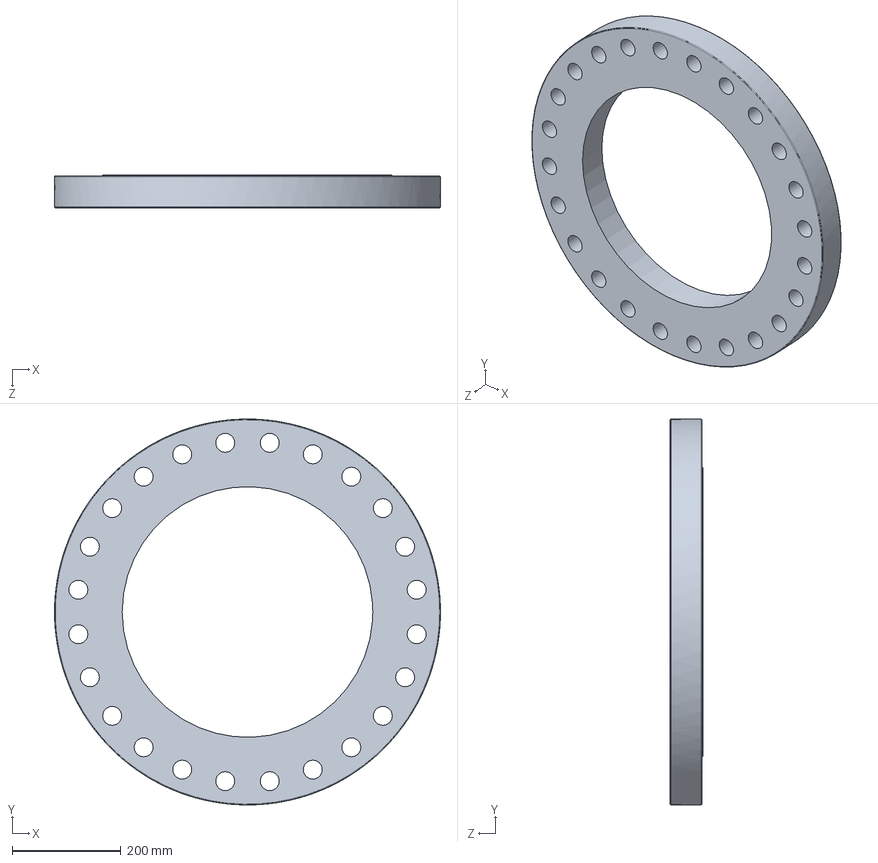
[picture p125: CAD file, 2025-09-01, last stored version]
static/images/3D/Трубчатые/3/Flange 18in.SLDPRT
711.2 x 711.0 x 60.3 mm
