BonisOleg/adiabatic/static/images/3D/Трубчатые/14/STATIONARY TUBESHEET/TUBE DIAM. 0.5 SCH 80 X 5000.SLDPRT

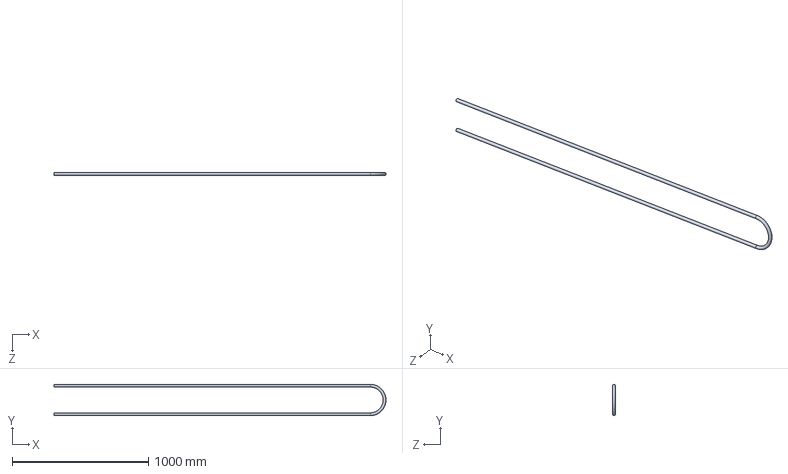
[picture p126: CAD file, 2025-09-01, last stored version]
static/images/3D/Трубчатые/14/STATIONARY TUBESHEET/TUBE DIAM. 0.5 SCH 80 X 5000.SLDPRT
2440.6 x 231.3 x 21.3 mm
