BonisOleg/adiabatic/static/images/3D/Трубчатые/15/Permutador e andaimes G.C/rodapé - 1,809 mg.c..SLDPRT

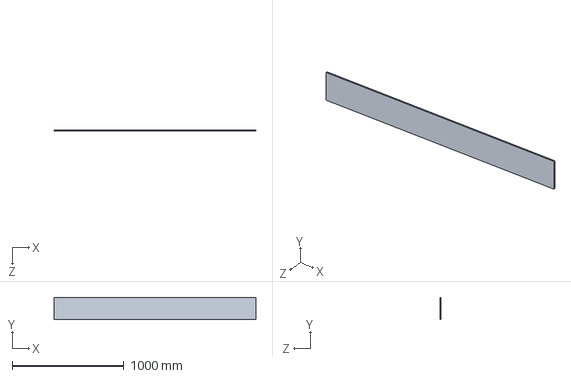
[picture p127: CAD file, 2025-09-01, last stored version]
static/images/3D/Трубчатые/15/Permutador e andaimes G.C/rodapé - 1,809 mg.c..SLDPRT
1809.0 x 200.0 x 10.0 mm
