BonisOleg/adiabatic/static/images/3D/Трубчатые/3/Pipe 3in.SLDPRT

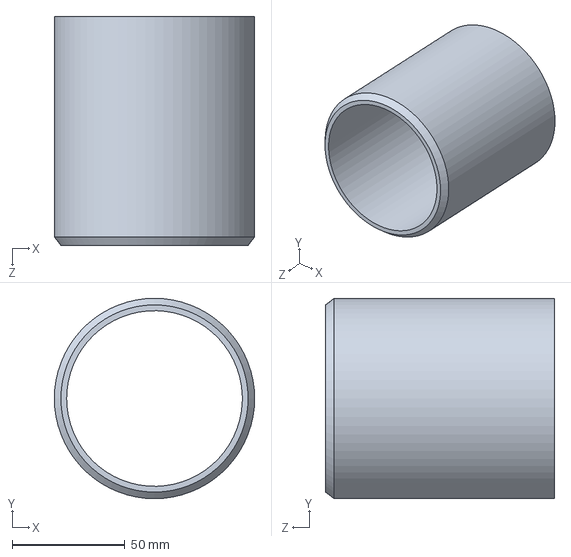
[picture p128: CAD file, 2025-09-01, last stored version]
static/images/3D/Трубчатые/3/Pipe 3in.SLDPRT
88.9 x 88.9 x 101.6 mm
