BonisOleg/adiabatic/static/images/3D/Трубчатые/3/Flange 6in.SLDPRT

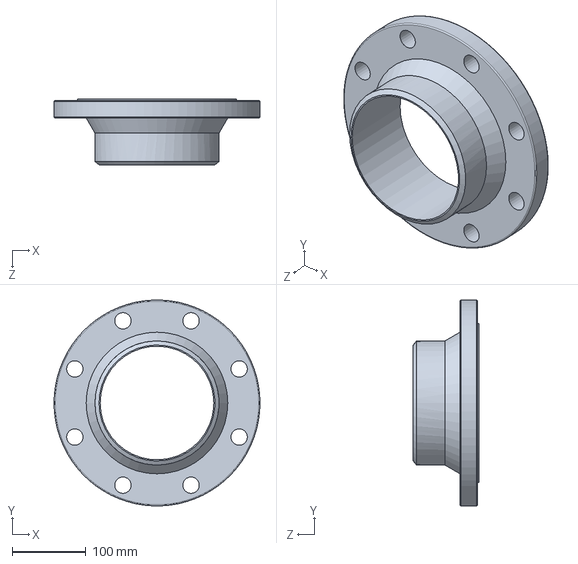
[picture p129: CAD file, 2025-09-01, last stored version]
static/images/3D/Трубчатые/3/Flange 6in.SLDPRT
279.4 x 279.1 x 88.9 mm
