BonisOleg/adiabatic/static/images/3D/Трубчатые/15/Permutador e andaimes G.C/Tubo 3,00 mg.c..sldprt

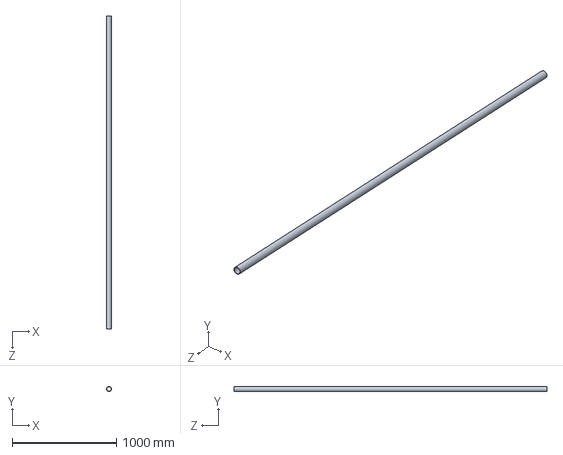
[picture p130: CAD file, 2025-09-01, last stored version]
static/images/3D/Трубчатые/15/Permutador e andaimes G.C/Tubo 3,00 mg.c..sldprt
48.2 x 48.3 x 3000.0 mm
