BonisOleg/adiabatic/static/images/3D/Трубчатые/3/Part1.SLDPRT

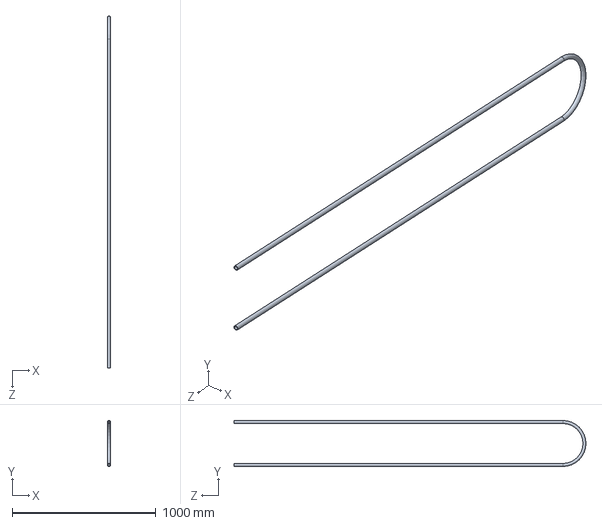
[picture p131: CAD file, 2025-09-01, last stored version]
static/images/3D/Трубчатые/3/Part1.SLDPRT
21.3 x 319.8 x 2445.9 mm
