BonisOleg/adiabatic/static/images/3D/Трубчатые/15/Permutador e andaimes G.C/piso aluminio 2,50 mg.c..SLDPRT

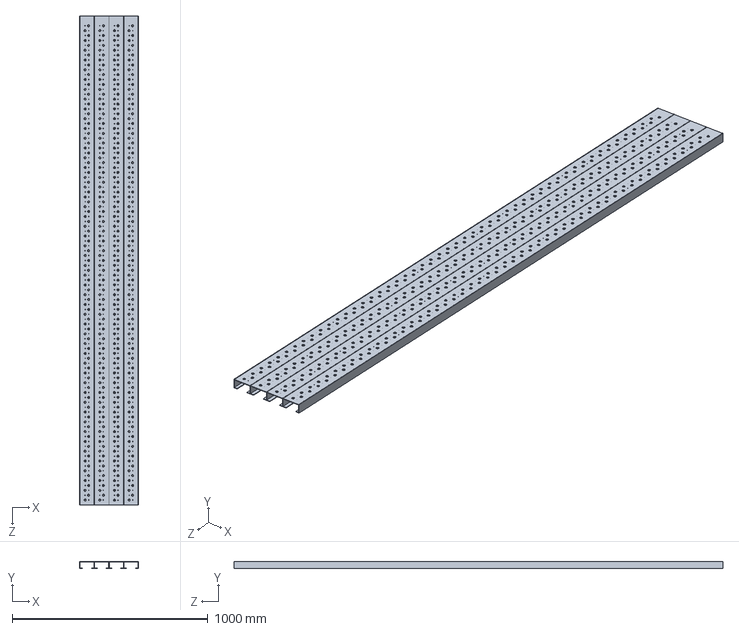
[picture p132: CAD file, 2025-09-01, last stored version]
static/images/3D/Трубчатые/15/Permutador e andaimes G.C/piso aluminio 2,50 mg.c..SLDPRT
300.0 x 36.0 x 2500.0 mm
