BonisOleg/adiabatic/static/images/3D/Трубчатые/15/Permutador e andaimes G.C/Drenog.c..SLDASM

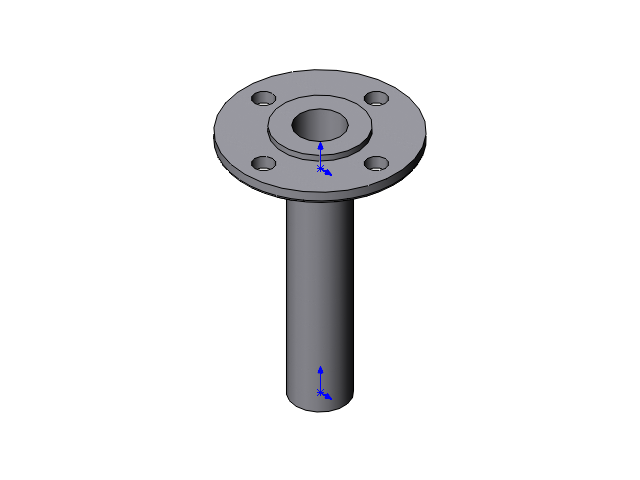
[picture p133: CAD file, 2025-09-01, last stored version]
static/images/3D/Трубчатые/15/Permutador e andaimes G.C/Drenog.c..SLDASM
Flange dreno
tubo dreno
