BonisOleg/adiabatic/static/images/3D/Трубчатые/15/Permutador e andaimes G.C/Abraçadeira giratóriag.c..SLDASM

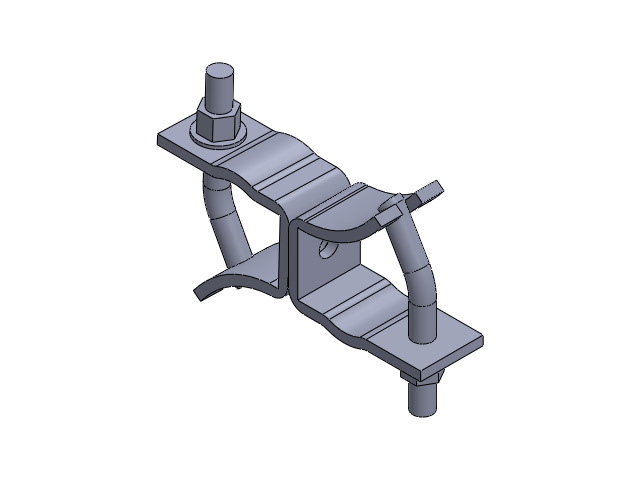
[picture p134: CAD file, 2025-09-01, last stored version]
static/images/3D/Трубчатые/15/Permutador e andaimes G.C/Abraçadeira giratóriag.c..SLDASM
Copy (2) of Abraçadeira Giratória^Abraçadeira giratóriag.c.
Copy of Abraçadeira Giratória^Abraçadeira giratóriag.c.
