BonisOleg/adiabatic/static/images/3D/Трубчатые/11/sINGLE BAFFLE.SLDASM

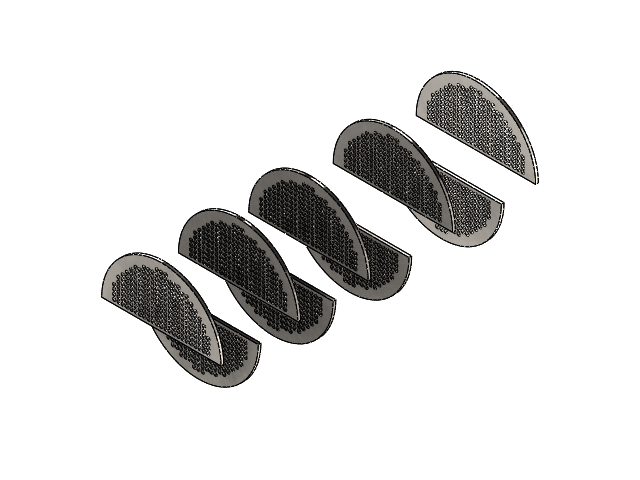
[picture p135: CAD file, 2025-09-01, last stored version]
static/images/3D/Трубчатые/11/sINGLE BAFFLE.SLDASM
baffle x 9
