BonisOleg/adiabatic/static/images/3D/Трубчатые/15/Permutador e andaimes G.C/Tubo casco.SLDASM

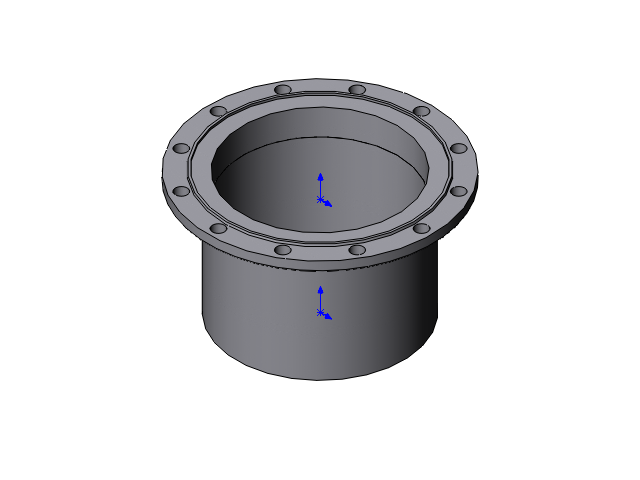
[picture p136: CAD file, 2025-09-01, last stored version]
static/images/3D/Трубчатые/15/Permutador e andaimes G.C/Tubo casco.SLDASM
Flange tubo casco
tubo casco
