BonisOleg/adiabatic/static/images/3D/Трубчатые/15/Permutador e andaimes G.C/Cascog.c..SLDASM

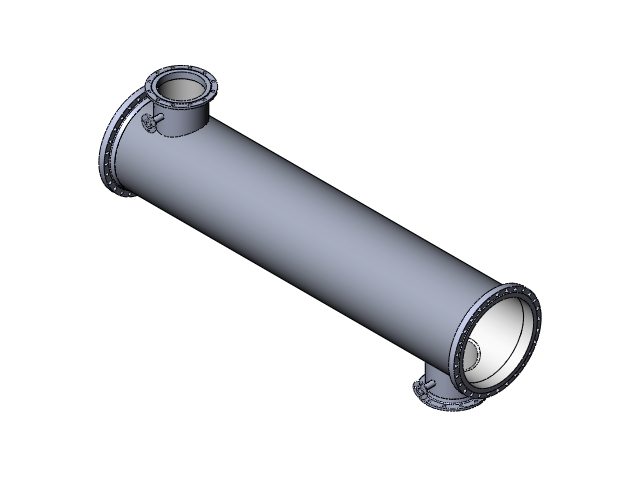
[picture p137: CAD file, 2025-09-01, last stored version]
static/images/3D/Трубчатые/15/Permutador e andaimes G.C/Cascog.c..SLDASM
Casco
Flange casco x 2
Flange tubo casco x 2
tubo casco x 2
Фланец I 32-025 ГОСТ12831-67g.c. x 2
труба 38х3-12Х18Н10Т ГОСТ 9940-81g.c. x 2
