BonisOleg/adiabatic/static/images/3D/Трубчатые/15/Permutador e andaimes G.C/Montagem feixeg.c..SLDASM

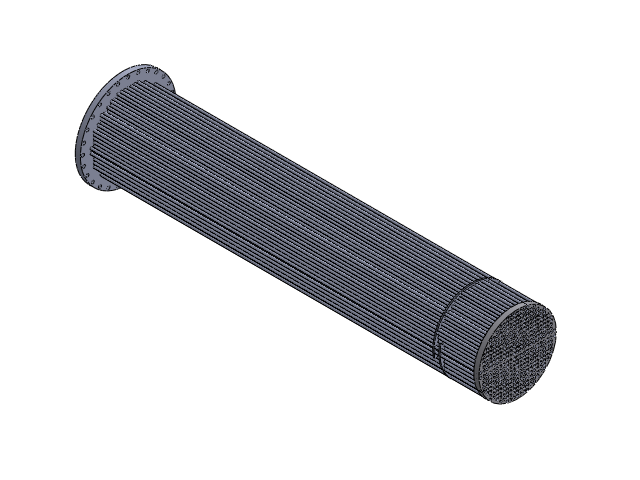
[picture p138: CAD file, 2025-09-01, last stored version]
static/images/3D/Трубчатые/15/Permutador e andaimes G.C/Montagem feixeg.c..SLDASM
Espelho fixog.c.
Tubosg.c.
Espelho flutuanteg.c.
Chicanasg.c. x 12
