BonisOleg/adiabatic/(list of files, cad)

Other CAD files:
static/images/3D/Трубчатые/3/MirrorMain Rod End .5in thrd.SLDPRT
static/images/3D/Трубчатые/14/SHELL/ASME B16.5 Flange Welding Neck - Class 600 4.SLDPRT
static/images/3D/Трубчатые/14/SUPPORT SADDLE FIX AND MOBILE DIAM 508/SUPPORT SADDLE FIX AND MOBILE DIAM 508(1).SLDASM
static/images/3D/Трубчатые/14/SHELL/ASME B36.10M PIPE 4 POL SCH 80 X 246.SLDPRT
static/images/3D/Нестандарт/13/HRSG.dwg
static/images/3D/Нестандарт/4/he.dwg
static/images/3D/Нестандарт/5/Drawing1.dwg
static/images/3D/Нестандарт/7/AC Heat Exchanger.STEP
static/images/3D/Пластинчатые/4/TS20-MFM ALFA LAVAL plate heat exchanger.dwg
static/images/3D/Паяные/1/plate Bb.SLDPRT
static/images/3D/Трубчатые/14/BONNET/SHELL COVER DIAM 508 X 177.SLDPRT
static/images/3D/Трубчатые/15/Permutador e andaimes G.C/rodapé - 2,271 mg.c..SLDPRT
static/images/3D/Трубчатые/14/SHELL/FLANGE DIAM 636 X 51.SLDPRT
static/images/3D/Нестандарт/4/finned tube he/air inlet flange.SLDPRT
static/images/3D/Трубчатые/11/double baffle p.SLDPRT
static/images/3D/Нестандарт/4/finned tube he/air vent 15bsp.SLDPRT
static/images/3D/Трубчатые/3/MirrorPipe 4in.SLDPRT
static/images/3D/Нестандарт/4/finned tube he/lh water box.SLDPRT
static/images/3D/Трубчатые/14/STATIONARY TUBESHEET/TRANSVERSE BAFFLE INFERIOR.SLDPRT
static/images/3D/Трубчатые/15/Permutador e andaimes G.C/Tubosg.c..sldprt
static/images/3D/Трубчатые/15/Permutador e andaimes G.C/tub inferior produtog.c..SLDPRT
static/images/3D/Нестандарт/4/finned tube he/DIN 6914 - M12 x 80 x 23-N.sldprt
static/images/3D/Нестандарт/4/finned tube he/Hexagon Nut ISO 4032 - M12 - D - N.sldprt
static/images/3D/Пластинчатые/5/Alfa Laval TK20-BWFG.SLDPRT
static/images/3D/Трубчатые/12/Heat Exchanger v8.f3d
static/images/3D/Трубчатые/14/SHELL/ASME B16.11 Coupling Threaded - Class 3000 1 x 1.SLDPRT
static/images/3D/Трубчатые/14/STATIONARY TUBESHEET/NUT.SLDPRT
static/images/3D/Трубчатые/14/SUPPORT SADDLE FIX AND MOBILE DIAM 508/PLATE 160 X 640 X 15,8(2).SLDPRT
static/images/3D/Трубчатые/15/Permutador e andaimes G.C/Abraçadeira fixag.c..SLDPRT
static/images/3D/Трубчатые/15/Permutador e andaimes G.C/Base conjuntog.c..sldprt
static/images/3D/Трубчатые/15/Permutador e andaimes G.C/Caretelg.c..SLDPRT
static/images/3D/Трубчатые/15/Permutador e andaimes G.C/Chainwheel valve coverg.c..sldprt
static/images/3D/Трубчатые/15/Permutador e andaimes G.C/Chicanasg.c..SLDPRT
static/images/3D/Трубчатые/15/Permutador e andaimes G.C/Degrau palitog.c..SLDPRT
static/images/3D/Трубчатые/15/Permutador e andaimes G.C/Espelho flutuanteg.c..SLDPRT
static/images/3D/Трубчатые/15/Permutador e andaimes G.C/Flange tubo casco.SLDPRT
static/images/3D/Трубчатые/15/Permutador e andaimes G.C/Saida carretel superiorg.c..sldprt
static/images/3D/Трубчатые/15/Permutador e andaimes G.C/Tampa do carretelg.c..SLDPRT
static/images/3D/Трубчатые/15/Permutador e andaimes G.C/Tubo 1,00 mg.c..SLDPRT
static/images/3D/Трубчатые/15/Permutador e andaimes G.C/Tubo 2,00 mg.c..SLDPRT
static/images/3D/Трубчатые/15/Permutador e andaimes G.C/Tubo 2,25 mg.c..sldprt
static/images/3D/Трубчатые/15/Permutador e andaimes G.C/Tubo 2,75 mg.c..SLDPRT
static/images/3D/Трубчатые/15/Permutador e andaimes G.C/guarda corpo aberto (arco aberto)g.c..SLDPRT
static/images/3D/Трубчатые/15/Permutador e andaimes G.C/piso aluminio 1,25 mg.c..SLDPRT
static/images/3D/Трубчатые/15/Permutador e andaimes G.C/rodapé - 2,319 mg.c..SLDPRT
static/images/3D/Трубчатые/15/Permutador e andaimes G.C/saida casco superiorg.c..SLDPRT
static/images/3D/Трубчатые/15/Permutador e andaimes G.C/tub inferior cascog.c..SLDPRT
static/images/3D/Трубчатые/15/Permutador e andaimes G.C/tub superior cascog.c..SLDPRT
static/images/3D/Трубчатые/15/Permutador e andaimes G.C/tub superior produtog.c..SLDPRT
static/images/3D/Трубчатые/15/Permutador e andaimes G.C/tubo casco.SLDPRT
static/images/3D/Трубчатые/15/Permutador e andaimes G.C/tubo dreno.SLDPRT
static/images/3D/Трубчатые/2/Heat Exchanger.prt
static/images/3D/Трубчатые/3/Baffle PLate.SLDPRT
static/images/3D/Трубчатые/3/Bolt SS .5in.SLDPRT
static/images/3D/Трубчатые/3/Flange 1in.SLDPRT
static/images/3D/Трубчатые/3/Flange 4in.SLDPRT
static/images/3D/Трубчатые/3/Pipe 1in.SLDPRT
static/images/3D/Трубчатые/3/Pipe 4in.SLDPRT
static/images/3D/Трубчатые/3/Plate Guide - 1.SLDPRT
static/images/3D/Трубчатые/3/Rod & Nut Assem1.SLDASM
static/images/3D/Трубчатые/3/Rod Center .5in thrd.SLDPRT
static/images/3D/Трубчатые/3/Rod Pipe .5in.SLDPRT
static/images/3D/Трубчатые/3/SS Hex Heavy Bolt_ai.sldprt
static/images/3D/Трубчатые/3/flow tag.SLDPRT
static/images/3D/Трубчатые/3/heavy hex nut_ai.sldprt
static/images/3D/Трубчатые/7/ASTM F436 - 1 1_8(1).ipt
static/images/3D/Трубчатые/7/Blind Flange 14 in.ipt
static/images/3D/Трубчатые/7/DIN 6915 - M30.ipt
static/images/3D/Трубчатые/7/DIN 976-1 - M30 x 180 - A.ipt
static/images/3D/Трубчатые/7/Fix Saddle.ipt
static/images/3D/Трубчатые/7/Flange 1 in.ipt
static/images/3D/Трубчатые/7/Flange 3 in.ipt
static/images/3D/Трубчатые/7/Front Head Pipe.ipt
static/images/3D/Трубчатые/7/Gasket.ipt
static/images/3D/Трубчатые/7/Heat Exchanger.iam
static/images/3D/Трубчатые/7/Heat Exchanger/Frame/ANSI 1 00000001.ipt
static/images/3D/Трубчатые/7/Heat Exchanger/Frame/ANSI 1 000000011.ipt
static/images/3D/Трубчатые/7/Heat Exchanger/Frame/ANSI 1 00000002.ipt
static/images/3D/Трубчатые/7/Heat Exchanger/Frame/ANSI 1 000000021.ipt
static/images/3D/Трубчатые/7/Heat Exchanger/Frame/ANSI 1 00000003.ipt
static/images/3D/Трубчатые/7/Heat Exchanger/Frame/ANSI 1 000000031.ipt
static/images/3D/Трубчатые/7/Heat Exchanger/Frame/ANSI 1 00000004.ipt
static/images/3D/Трубчатые/7/Heat Exchanger/Frame/ANSI 1 000000041.ipt
static/images/3D/Трубчатые/7/Heat Exchanger/Frame/ANSI 1 00000005.ipt
static/images/3D/Трубчатые/7/Heat Exchanger/Frame/ANSI 1 000000051.ipt
static/images/3D/Трубчатые/7/Heat Exchanger/Frame/ANSI 1 00000006.ipt
static/images/3D/Трубчатые/7/Heat Exchanger/Frame/ANSI 1 000000061.ipt
static/images/3D/Трубчатые/7/Heat Exchanger/Frame/ANSI 1 00000007.ipt
static/images/3D/Трубчатые/7/Heat Exchanger/Frame/ANSI 1 000000071.ipt
static/images/3D/Трубчатые/7/Heat Exchanger/Frame/ANSI 1 00000008.ipt
static/images/3D/Трубчатые/7/Heat Exchanger/Frame/ANSI 1 000000081.ipt
static/images/3D/Трубчатые/7/Heat Exchanger/Frame/ANSI 1 00000009.ipt
static/images/3D/Трубчатые/7/Heat Exchanger/Frame/ANSI 1 000000091.ipt
static/images/3D/Трубчатые/7/Heat Exchanger/Frame/ANSI 1 00000010.ipt
static/images/3D/Трубчатые/7/Heat Exchanger/Frame/ANSI 1 000000101.ipt
static/images/3D/Трубчатые/7/Heat Exchanger/Frame/ANSI 1 00000011.ipt
static/images/3D/Трубчатые/7/Heat Exchanger/Frame/ANSI 1 000000111.ipt
static/images/3D/Трубчатые/7/Heat Exchanger/Frame/ANSI 1 00000012.ipt
static/images/3D/Трубчатые/7/Heat Exchanger/Frame/ANSI 1 000000121.ipt
static/images/3D/Трубчатые/7/Heat Exchanger/Frame/ANSI 1 00000013.ipt
static/images/3D/Трубчатые/7/Heat Exchanger/Frame/ANSI 1 000000131.ipt
static/images/3D/Трубчатые/7/Heat Exchanger/Frame/ANSI 1 00000014.ipt
static/images/3D/Трубчатые/7/Heat Exchanger/Frame/ANSI 1 000000141.ipt
static/images/3D/Трубчатые/7/Heat Exchanger/Frame/ANSI 1 00000015.ipt
static/images/3D/Трубчатые/7/Heat Exchanger/Frame/ANSI 1 000000151.ipt
static/images/3D/Трубчатые/7/Heat Exchanger/Frame/ANSI 1 00000016.ipt
static/images/3D/Трубчатые/7/Heat Exchanger/Frame/ANSI 1 000000161.ipt
static/images/3D/Трубчатые/7/Heat Exchanger/Frame/ANSI 1 00000017.ipt
static/images/3D/Трубчатые/7/Heat Exchanger/Frame/ANSI 1 000000171.ipt
static/images/3D/Трубчатые/7/Heat Exchanger/Frame/ANSI 1 00000018.ipt
static/images/3D/Трубчатые/7/Heat Exchanger/Frame/ANSI 1 000000181.ipt
static/images/3D/Трубчатые/7/Heat Exchanger/Frame/ANSI 1 00000019.ipt
static/images/3D/Трубчатые/7/Heat Exchanger/Frame/ANSI 1 000000191.ipt
static/images/3D/Трубчатые/7/Heat Exchanger/Frame/ANSI 1 00000020.ipt
static/images/3D/Трубчатые/7/Heat Exchanger/Frame/ANSI 1 000000201.ipt
static/images/3D/Трубчатые/7/Heat Exchanger/Frame/ANSI 1 00000021.ipt
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
