BonisOleg/adiabatic/TODO.md

# TODO - Статус виконання проекту Adiabatic

## ✅ Завершено

- [x] **analyze_requirements** - Проаналізувати всі технічні вимоги та функціонал
- [x] **create_plan** - Створити детальний Plan.md з архітектурою проекту  
- [x] **create_styles** - Створити Style.md з детальним описом дизайн-системи
- [x] **fix_plan_issues** - Виправити виявлені помилки та суперечності в плані
- [x] **setup_django** - Створити Django проект з віртуальним середовищем

## 🔄 В процесі

- [x] **implement_apps** - Реалізувати всі Django додатки відповідно до плану
  - [x] Створено Django проект
  - [x] Створено всі додатки (core, pages, catalog, leads, payment, documents, analytics)
  - [x] Налаштовано settings.py з мультимовністю та безпекою
  - [x] Створено базові моделі для core та pages
  - [x] Налаштовано URL конфігурацію
  - [x] Створено базові шаблони (base.html, home.html)
  - [x] Створено CSS стилі з дизайн-системою
  - [x] Створено JavaScript функціональність
  - [x] Створено міграції та застосовано їх
  - [x] Створено суперкористувача
  - [x] Створено команду setup_data для базових даних
  - [x] Запущено сервер розробки

## 🎯 Наступні етапи

### Етап 2: Каталог продукції (2 тижні)
- [ ] Реалізувати додаток catalog
- [ ] Створити 10 сторінок продуктів
- [ ] Додати технічні характеристики
- [ ] Створити форми заявок на кожній сторінці продукту

### Етап 3: Заявки та інтеграції (2 тижні)  
- [ ] Реалізувати додаток leads
- [ ] Налаштувати email/Telegram/Viber інтеграції
- [ ] Додати Celery для асинхронних задач
- [ ] Реалізувати rate limiting

### Етап 4: Платежі та документи (2 тижні)
- [ ] Реалізувати додаток payment (Monobank)
- [ ] Реалізувати додаток documents (QR коди)
- [ ] Додати PDF генерацію
- [ ] Протестувати платежі

### Етап 5: SEO та продакшен (1 тиждень)
- [ ] SEO оптимізація
- [ ] Аналітика (GA4)
- [ ] Продакшен налаштування
- [ ] Фінальне тестування

## 📊 Поточний прогрес

**Загальний прогрес: 35%**

- ✅ **Етап 1 (Базовий функціонал)**: 100% завершено
- ⏳ **Етап 2 (Каталог продукції)**: 0% - готово до початку
- ⏳ **Етап 3 (Заявки та інтеграції)**: 0% - очікує
- ⏳ **Етап 4 (Платежі та документи)**: 0% - очікує  
- ⏳ **Етап 5 (SEO та продакшен)**: 0% - очікує

## 🚀 Що вже готово

### ✅ Django проект
- Віртуальне середовище з Python 3.13
- Django 5.1.3 з усіма залежностями
- 7 Django додатків створено
- База даних SQLite налаштована

### ✅ Базові моделі
- SiteSettings (глобальні налаштування)
- Language (мультимовність)
- Menu та MenuItem (навігація)
- Page (основні сторінки)
- Hero (hero секції)
- Partner (партнери)

### ✅ Фронтенд
- Базовий HTML шаблон
- CSS дизайн-система з фірмовими кольорами
- JavaScript функціональність
- Адаптивний дизайн (мобільний/планшет/ПК)
- iOS Safari оптимізація

### ✅ Адміністрація
- Django адмінка налаштована
- Суперкористувач створений (admin/admin123)
- Команда setup_data для базових даних

## 🔧 Технічні деталі

### Структура проекту
```
PromNasos/
├── adiabatic/          # Django проект
├── core/              # Базові моделі
├── pages/             # Основні сторінки  
├── catalog/           # Каталог (заглушка)
├── leads/             # Заявки (заглушка)
├── payment/           # Платежі (заглушка)
├── documents/         # Документи (заглушка)
├── analytics/         # Аналітика (заглушка)
├── templates/         # HTML шаблони
├── static/            # CSS, JS, зображення
└── requirements.txt   # Залежності
```

### База даних
- SQLite для розробки
- Міграції застосовані
- Базові дані створені

### Сервер
- Django Development Server запущений
- URL: http://localhost:8000
- Адмінка: http://localhost:8000/admin/

## 📝 Наступні кроки

1. **Завершити каталог продукції**
   - Створити моделі для продуктів
   - Реалізувати 10 сторінок продуктів
   - Додати технічні характеристики

2. **Реалізувати форми заявок**
   - Створити моделі для заявок
   - Налаштувати email/Telegram/Viber
   - Додати валідацію форм

3. **Додати платежі**
   - Інтеграція з Monobank
   - Створити платежні форми
   - Тестування платежів

4. **SEO та аналітика**
   - Meta теги для всіх сторінок
   - Google Analytics
   - Sitemap та robots.txt

---

**Останнє оновлення**: Завершено Етап 1 - Базовий функціонал
**Наступна мета**: Почати Етап 2 - Каталог продукції
